JiachengDong2026/Vapor_Radar_App_V2/Docs/【任务书】三成员任务书_V1.3/00_任务分配总览与集成边界_V1.3.md

# 机载三维水汽激光雷达 FPGA 下位机——三成员任务分配总览与集成边界

> 版本：V1.3（2026-09-13，取代 V1.2/V1.1/V1.0 的任务责任分配）  
> 开发环境：Xilinx Vivado  
> RTL：Verilog-2001  
> FPGA：Xilinx XCKU11P-2FFVA1156I  
> 技术架构基线：`FPGA下位机Verilog开发指南_V1.1.md` + `FPGA下位机详细架构与接口分配方案_V1.1.md`  
> 说明：上述技术文档中的接口、寄存器、协议和物理连接仍有效；**本 V1.3 保持责任分工不变，并重新冻结多源数据通路、FIFO、DILA 分片和仲裁接口**。若责任归属与旧文档冲突，以 V1.3 为准。

---

# 1. V1.3 最终任务分配

| 责任主体 | 正式负责内容 | 形成的完整功能链 |
|---|---|---|
| **成员1** | AD4630、ADC3660、两路 ADC capture/FIFO/CDC、DILA0/DILA1 及 DILA 子模块 | **探测器 → ADC → FPGA采集 → DILA 1f/2f 解调 → DILA标准数据流** |
| **成员2** | WMS0/WMS1、正弦/锯齿发生、AD5791-0、AD5791-1、WMS→DAC 端到端链路 | **参数配置 → WMS锯齿+正弦 → DAC码 → AD5791 → 激光驱动器** |
| **成员3** | 公共 UART；PTB210、HMP、EPSILON2、BMP390、SHT45、TFA1500-L、RD105；Modbus RTU、RS485控制、I²C | **全部非ADC传感器的物理接口/串口/I²C → 协议解析 → 标准传感器数据流** |
| **项目负责人** | 时钟复位、统一时间基准/同步、RAW周期切帧、项目级 sensor_hub、stream arbiter、packetizer、命令/寄存器 crossbar、stepper、USB3.1/FX3、顶层/XDC整合、上下位机联调 | **项目公共控制、传输和最终集成** |

## 1.1 三条成员链路的设计原则

### 成员1：接收与解调链
成员1对“从 ADC 物理引脚开始，到 DILA 标准输出结束”的数据正确性负责。两种 ADC 的物理接口虽然不同，但进入系统后必须统一为 `sample_stream`。DILA0/DILA1 使用同一套可参数化 RTL，分别服务原位和遥测通道；每个 WMS 周期的曲线按 fragment 输出到独立 `bulk_stream`。

### 成员2：激励与输出链
成员2只负责 WMS + DAC，不再承担任何传感器协议。WMS 必须输出供系统使用的 `scan_start/cycle_id/sine_phase`，同时生成 DAC 样点并通过 AD5791 物理接口输出。

### 成员3：全部低速/串行传感器链
成员3统一负责公共 UART 和全部非 ADC 传感器，避免多个成员各自实现串口或协议栈。成员3需要把 RS232、RS422、RS485、TTL UART、I²C 等设备差异全部封装在驱动内部，上层只看到各设备独立的标准 `msg_stream` 和寄存器接口；每个 source 先进入独立 FIFO，再由负责人实现的 `sensor_hub` 进行消息级仲裁。

---

# 2. 项目负责人保留模块

以下模块仍由项目负责人开发或最终整合：

- `clk_rst_mgr`
- `time_sync_core`
- `timestamp_capture`
- `adc_cycle_framer`（RAW ADC 周期切帧）
- 项目级 `sensor_hub`（只做多传感器消息仲裁/状态汇总，不解析设备协议）
- `stepper_ctrl`
- 项目级 `stream_fifo`/深缓存策略
- `stream_arbiter`
- `data_packetizer`
- `cmd_decoder`
- `reg_ctrl_crossbar`
- `status_manager`
- `watchdog`
- `usb_fx3_gpif_if`
- `vapor_lidar_top`
- 最终 `vapor_lidar_top.xdc`
- FX3 firmware
- USB endpoint/VLP1 协议落地
- Qt 上位机对接与最终系统联调

**V1.3 中，公共 UART 和 DILA 仍由成员负责；新增的系统级多源仲裁、RAW bulk framer 仍由项目负责人负责。**

---

# 3. 模块所有权冻结表

| 模块 | 所有人 | 上游 | 下游 |
|---|---|---|---|
| `adc_ad4630_if` | 成员1 | AD4630 pins | ADC0 `sample_stream` |
| `adc_adc3660_if` | 成员1 | ADC3660 pins | ADC1 `sample_stream` |
| `dila_core` | 成员1 | `sample_stream` + WMS phase/cycle | DILA curve points |
| `dila_ref_gen` | 成员1 | WMS phase 或独立频率 | 1f/2f sin/cos |
| `dila_mixer` | 成员1 | ADC sample + refs | I/Q products |
| `dila_lpf` | 成员1 | mixed I/Q | filtered I/Q |
| `dila_decimator` | 成员1 | filtered I/Q | decimated points |
| `dila_block_framer` | 成员1 | DILA points + cycle metadata | `DILA_BLOCK` V2 `bulk_stream` fragments |
| `wms_wavegen` | 成员2 | cfg/time | DAC sample + scan/cycle/phase |
| `sine_lut`（WMS侧） | 成员2 | phase | WMS sine |
| `dac_ad5791_if` | 成员2 | WMS DAC sample | AD5791 pins |
| `uart_rx` | 成员3 | serial RX pin | byte stream |
| `uart_tx` | 成员3 | byte stream | serial TX pin |
| `crc16_modbus` | 成员3 | bytes | CRC |
| `modbus_rtu_master` | 成员3 | UART byte stream | device transactions |
| `rs485_halfduplex_ctrl` | 成员3 | UART TX state | DE/RE |
| `i2c_master` | 成员3 | device drivers | SCL/SDA |
| `ptb210_rs232` | 成员3 | UART | `msg_stream` |
| `hmp_modbus_rs485` | 成员3 | UART/Modbus/RS485 | `msg_stream` |
| `epsilon_rs422` | 成员3 | UART + FDILink | `msg_stream` + GNSS time tag |
| `bmp390_driver` | 成员3 | I²C | `msg_stream` |
| `sht45_driver` | 成员3 | I²C | `msg_stream` |
| `tfa1500_uart` | 成员3 | UART/GPIO RX | `msg_stream` |
| `rd105_uart` | 成员3 | UART/Modbus | `msg_stream` |

---

# 4. 成员之间必须冻结的接口

## 4.1 成员2 → 成员1/项目负责人：WMS参考接口

每个 WMS 通道必须提供：

```verilog
output wire        scan_start;       // 一个 sys_clk 周期脉冲，新锯齿周期开始
output wire [31:0] cycle_id;         // scan_start 时已经更新为新周期 ID
output wire [31:0] sine_phase;       // 当前 1f 相位，U32: 0..2^32-1 = 0..2pi
output wire        wms_running;
output wire        phase_valid;
```

冻结要求：

1. `scan_start`、`cycle_id`、`sine_phase` 位于 `sys_clk=100 MHz` 控制/参考域；
2. `scan_start` 仅 1 cycle；
3. `cycle_id` 每次有效 scan 起始递增 1；
4. `phase_valid=1` 时 `sine_phase` 可供 DILA 锁相；
5. WMS/DAC 内部 SPI 实现不能泄漏到成员1；
6. 成员1不得读取成员2内部寄存器来“猜”相位。

项目负责人同时消费 `scan_start/cycle_id` 用于 RAW ADC 周期切帧和周期级 timestamp。

## 4.2 成员1 → 项目负责人：ADC RAW 与 DILA 输出

每个 ADC 继续暴露标准 RAW `sample_stream`，供项目负责人 `adc_cycle_framer` 和 DILA 使用：

```verilog
output wire        raw_valid;
input  wire        raw_ready;
output wire [31:0] raw_data;
output wire [7:0]  raw_flags;
```

DILA0/DILA1 从 V1.3 起不再输出低速 `msg_stream`，而输出各自独立的 `bulk_stream`：

```verilog
output wire        b_valid;
input  wire        b_ready;
output wire [31:0] b_data;
output wire [3:0]  b_keep;
output wire        b_sof;
output wire        b_last;
output wire [15:0] b_source_id;
output wire [15:0] b_msg_id;
output wire [63:0] b_timestamp;
output wire [31:0] b_cycle_id;
output wire [31:0] b_flags;
```

冻结要求：

- `DILA0 source=0x0030`, `DILA1 source=0x0031`, `msg_id=0x1001`；
- 每个 WMS 周期可以产生多个 fragment；
- 默认最多 256 点/fragment；单 fragment payload <=8192 B；
- 每通道独立 bulk FIFO / ping-pong buffer，至少能缓存 2 个最大 fragment；
- 同一周期所有 fragment 的 timestamp/cycle_id 相同；
- 项目负责人只在 fragment 的 `b_last` 后切换 source。

成员1必须保证物理 ADC 不受下游 `ready` 直接反压。

## 4.3 成员3 → 项目负责人：传感器统一消息接口

每个 sensor driver 最终输出**独立**标准 `msg_stream`，并在 driver 输出侧配置独立消息 FIFO。项目负责人不需要知道 PTB ASCII、FDILink、Modbus、TFA binary frame 或 SHT CRC 等细节。

冻结要求：

- PTB/HMP/EPSILON2/BMP390/SHT45/TFA/RD105 不得直接并联一套 `msg_stream`；
- 每个 source 默认建议 FIFO 有效容量 >=1 KiB，至少能容纳一条最大合法记录；
- FIFO full 必须计数并置错误；
- 项目负责人实现 `sensor_hub`，按 message-locked round-robin 在各 source FIFO 之间仲裁；
- 成员3不实现项目级 `sensor_hub/stream_arbiter`。

成员3的 UART、Modbus、I²C 可以在成员内部复用。

---

# 5. 冻结寄存器地址/数据源归属

| 功能 | Base | 负责人 |
|---|---:|---|
| WMS0 | `0x2000` | 成员2 |
| WMS1 | `0x2100` | 成员2 |
| DAC0 AD5791 | `0x3000` | 成员2 |
| DAC1 AD5791 | `0x3100` | 成员2 |
| ADC0 AD4630 | `0x4000` | 成员1 |
| ADC1 ADC3660 | `0x4100` | 成员1 |
| DILA0 | `0x5000` | 成员1 |
| DILA1 | `0x5100` | 成员1 |
| PTB210 | `0x6000` | 成员3 |
| HMP | `0x6100` | 成员3 |
| EPSILON2 | `0x6200` | 成员3 |
| BMP390 | `0x6300` | 成员3 |
| SHT45 | `0x6400` | 成员3 |
| TFA1500-L | `0x6500` | 成员3 |
| RD105 | `0x6600` | 成员3 |

成员不得修改 base address、source_id、msg_id。若需要新增模块专用寄存器，只能在自己的 `0x100 B` 地址页内从未占用 offset 扩展，并在 README 中明确说明。

---

# 6. 项目级统一接口要求

> V1.3：`sample_stream`=ADC样点；`msg_stream`=低速消息；`bulk_stream`=DILA/RAW大块分片。禁止混用。

## 6.1 时钟/复位

```verilog
input wire sys_clk;       // 100 MHz
input wire rst_sys_n;     // 低有效，同步释放
```

器件源同步时钟（ADC DCLK/FCLK 等）可在接口模块内部使用，但进入统一数据平面前必须完成 CDC。

## 6.2 `cfg_bus`

正式可配置模块统一实现：

```verilog
input  wire        cfg_valid;
input  wire        cfg_write;
input  wire [31:0] cfg_addr;
input  wire [31:0] cfg_wdata;
input  wire [3:0]  cfg_wstrb;
output wire        cfg_ready;
output wire [31:0] cfg_rdata;
output wire        cfg_error;
```

规则：

- `cfg_valid && cfg_ready` 完成一次访问；
- `cfg_error` 与 `cfg_ready` 同拍；
- 单 outstanding；
- 只响应自身地址页；
- 非法参数返回 `cfg_error`；
- 实时参数优先使用 shadow + commit；
- WMS/DILA 等实时处理参数在安全边界生效。

## 6.3 统一寄存器页首部

每个 `0x100 B` 页：

| offset | 名称 | 访问 | 含义 |
|---:|---|---|---|
| `+0x00` | `ID_VERSION` | RO | module ID/version |
| `+0x04` | `CONTROL` | RW/W1P | enable/reset/commit/clear FIFO |
| `+0x08` | `STATUS` | RO | ready/busy/online/overflow/error/time sync |
| `+0x0C` | `ERROR` | RO/W1C | timeout/protocol/overflow/config/internal/device/data format |

---

# 7. 物理资源责任汇总

## 7.1 成员1

- AD4630：CON15/对应 ADC 接口网络及原理图中全部 AD4630 FPGA pins；
- ADC3660：CON17/对应 ADC3660 source-synchronous FPGA pins；
- ADC SPI/控制 pins（若该器件需要）；
- DILA 无新增板外引脚，使用内部数字数据。

## 7.2 成员2

- AD5791-0 → CON7 SMA；
- AD5791-1 → CON8 SMA；
- 两路 AD5791 的 SCLK/SYNCN/SDIN/SDO/RSTN/CLRN/LDACN FPGA pins。

## 7.3 成员3

- PTB210 → CON25 RS232A；
- HMP → CON19 RS485；
- EPSILON2 → CON24 RS422，SYNC 信号 CON22 交由项目负责人 `time_sync_core`；
- BMP390/SHT45 → CON11 I²C；
- TFA1500-L → CON21 TTL UART + CON11 LF RX；
- RD105 → CON11 GPIO UART。

最终 ball/pin 号以各自任务书与主开发指南的接口汇总表为准。

---

# 8. 禁止跨责任边界修改

成员不得：

1. 修改 VLP1/USB 协议；
2. 修改 source_id/msg_id/base address；
3. 修改项目顶层；
4. 修改最终总 XDC；
5. 新建第二套 timestamp；
6. 直接向 FX3/USB 写数据；
7. 在设备 driver 外暴露设备私有协议；
8. 通过全局变量/层次引用读取其他成员内部信号；
9. 修改其他成员冻结接口；
10. 未经负责人确认新增 IP 依赖或第三方 RTL。

---

# 9. 每名成员最终统一交付目录

```text
memberX_<scope>/
├── README.md
├── rtl/
│   └── *.v
├── sim/
│   ├── tb/
│   ├── models/
│   ├── vectors/
│   └── stubs/           # 仅仿真，禁止综合
├── constraints/
│   └── memberX_<scope>.xdc
├── scripts/
│   ├── run_sim.tcl
│   └── run_synth_check.tcl
├── reports/
│   ├── SIM_REPORT.md
│   ├── SYNTH_REPORT.md
│   └── TIMING_CDC_NOTES.md
└── docs/
    ├── INTERFACE.md
    ├── REGISTER_MAP.md
    ├── HARDWARE_MAPPING.md
    └── KNOWN_ISSUES.md
```

## README 最低内容

- Vivado 版本；
- 顶层待实例化模块名；
- RTL 文件清单；
- 编译顺序；
- 所需 clock/reset；
- 参数默认值；
- 外部依赖；
- 通过的 testbench；
- 综合/时序状态；
- 尚需实机确认项。

---

# 10. 统一验收门槛

每名成员交付前必须满足：

1. 所有 testbench PASS；
2. RTL 无 latch；
3. 综合无 Error/Critical Warning；
4. CDC 已解释或约束；
5. I/O 时钟有正确时序约束；
6. `cfg_bus` 非本地址不响应；
7. valid/ready 背压测试通过；
8. FIFO overflow/timeout/CRC 等异常均可观测；
9. XDC 只提交自己的 fragment；
10. 不提交 `.runs/`、`.cache/`、巨大 waveform 等临时文件；
11. 项目负责人将成员 RTL 加入顶层时，不应需要修改成员内部代码才能完成基本实例化。

---

# 11. 推荐并行开发顺序

### 成员1
ADC物理接口 → capture FIFO/CDC → ADC标准流 → DILA数学链 → DILA block → 双通道端到端测试。

### 成员2
WMS phase/波形 → AD5791 transport → 单通道 WMS→DAC → 双通道独立运行 → 导出冻结 WMS参考接口。

### 成员3
UART → Modbus/RS485/I²C → PTB/HMP/RD105 → EPSILON/TFA → BMP/SHT → 全传感器 `msg_stream` 回归。

三名成员均应在其他成员未完成时使用**同端口仿真 stub/model**，不得以依赖未完成为理由串行等待。
