JiachengDong2026/Vapor_Radar_App_V2/Docs/INTEGRATION_REVISION_20261002_DLIA_PRECISION.md

# 2026-10-02 DLIA参考与低通精度修订

本说明对应隔离候选源码 `E:/Documents/Vapor_Lc_App_Test/dlia_precision_20261002/source`。2026-10-04已将该版本同步至正式 `E:/Documents/Vapor_Lc_App_v2`；同步范围及复验见 [正式同步记录](MERGE_MANIFEST_20261004.md)。历史BIT的版本、哈希和板测记录保留原值。本隔离版本现已完成算法回归、实现时序检查、比特流下载和两轮真实激光器上板采集；验收范围为 CON7/WMS1 对应的第一路 ADC/DLIA，详见本任务目录的 [完整报告](E:/Documents/Vapor_Lc_App_Test/dlia_precision_20261002/REPORT.md)。其余通道不据此宣称完成实板验收。

## 原因与版本识别

解调输入含较大的直流偏置时，混频产生的20kHz/40kHz分量必须在抽取前充分抑制。原二阶1kHz低通的带外残留可能在抽取后影响H2；参考LUT直接截断地址也会引入参考波形量化误差。本修订分别改善参考精度与混频后滤波。

| 读回项 | 历史构建 | 本隔离候选 |
| --- | --- | --- |
| DLIA0 `0x5000` | `0x00300100` | `0x00300101` |
| DLIA1 `0x5100` | `0x00310100` | `0x00310101` |
| 模块版本低16位 | `0x0100` | `0x0101` |
| 1MHz `LPF_PROFILE` | `0x00020101`，二阶 | `0x00040101`，四阶 |
| 12.5MHz `LPF_PROFILE` | `0x00020102`，二阶 | `0x00040102`，四阶 |
| 数值描述 `+0x28` | `0x20112E10` | `0x20112E10` |

双AD4630顶层的两路均选择1MHz profile；12.5MHz profile继续用于编译参数与旧高速ADC回归兼容。profile由`INPUT_RATE_HZ`在编译时决定，不随运行时采样率寄存器自动重新设计。偏离设计采样率时，实际截止频率随采样率同比例变化。

寄存器地址、读写属性、既有位域、source/msg ID、流位宽、VLP 1.0以及`DILA_BLOCK` schema2均保持原定义。上位机须按读回版本选择算法说明，不应将旧BIT的profile读回当作新算法通过。

## 参考发生器

`dila_ref_gen.v`保留1024点有符号18位Q1.17正弦LUT，峰值为131071。`phase[31:22]`定位表项，`phase[21:10]`提供12位线性插值小数；下一表项在1023→0处回绕。插值乘积除以4096时采用最近舍入、恰好半LSB时远离零；最终10位phase不参与插值。组合端口及流水级数不变。

相位公式继续采用U32整圈并自然回绕：

- `p1 = phase + PHASE_1F`；
- `p2 = 2*phase + PHASE_2F_CORRECTION`；
- cos参考在对应sin相位上加`0x40000000`。

H2校正不自动包含两倍的1f相位偏置。本修订不新增H2校正角，也不改变I/Q符号、幅值计算或输出比例。混频低通后的I/Q仍没有额外乘2补偿。

## 四阶低通与定点格式

`dila_core.v`将两个已有`dila_lpf`串联，对I1/Q1/I2/Q2四个分量分别处理。结构为四阶Butterworth，设计截止频率1kHz；低Q节在前，高Q节在后。每节都具有单位DC增益，避免把极小前级增益与极大后级增益带入定点实现。

每节采用递推式 `y[n]=b0*x[n]+b1*x[n-1]+b2*x[n-2]-a1*y[n-1]-a2*y[n-2]`。系数均为48位有符号Q2.46，下表为乘以`2^46`后的整数；`a0=2^46`。

| 输入率 | 节 | b0=b2 | b1 | a1 | a2 |
| --- | --- | ---: | ---: | ---: | ---: |
| 1MHz | 1，低Q | 690501114 | 1381002230 | -139922478782895 | 69556496609689 |
| 1MHz | 2，高Q | 692843472 | 1385686942 | -140397131718583 | 70031158914805 |
| 12.5MHz | 1，低Q | 4442812 | 8885622 | -140672143489574 | 70303417083156 |
| 12.5MHz | 2，高Q | 4444020 | 8888039 | -140710403851039 | 70341677449454 |

每行严格满足 `b0+b1+b2=2^46+a1+a2`，包括系数量化后的DC增益。输入和节间IQ为32位有符号数；每节历史状态为48位有符号、16位小数。乘积96位，求和100位，舍入临时量101位；系数缩放和最终输出均采用最近舍入、半LSB远离零。状态限幅到48位，输出限幅到32位，避免溢出回绕。

`+0x34`累计两节的饱和脉冲；任一节同一输入的多个IQ通道同时饱和仍计为该节一个事件，两节同周期同时饱和加2，并置滤波饱和错误位。正常信号验证未触发饱和；有意施加的正负满幅阶跃用于验证限幅和计数。

MODE.bit2同时旁路两节输出。两节共用本地复位/FIFO clear；完整194位采样标签随数据流转。待提交配置和STOP/drain判断同时包含两节busy/valid，避免第一节仍在处理时误认流水为空。连续周期边界保持IIR状态；清空和软件复位按原语义清除算术历史。

## 时序与频率响应变化

第二节增加3个100MHz系统时钟，即30ns的运算流水延迟。两节并行处理相邻样点，各自每3clk可接收一个输入；既有core最短6clk接收间隔不变。仿真验证12.5MHz场景每8clk输入一次没有漏样或额外背压。抽取位置仍在两节低通之后，1MHz→10kHz仍抽取100，12.5MHz→10kHz仍抽取1250。

运算流水延迟与滤波群延迟不同。四阶响应在低基带频率附近的群延迟约0.416ms，原二阶约0.225ms，增加约0.191ms；具体群延迟随包络频率变化，不能用固定30ns代表全部响应变化。因此扫描包络和瞬态的响应会延后、启动稳定需要时间。H2参考相位定义保持原样，但随时间变化的H2包络会受到新的滤波相位响应；不能据此宣称所有频率上的输出相位数值不变。

标签仍标识原采样时刻，未增加软件时间戳补偿。对比RAW与DLIA扫描曲线时应考虑滤波群延迟，不能把新旧曲线逐点错位直接当作幅值错误。

| 数值频响 | 1MHz设计 | 12.5MHz设计 |
| --- | ---: | ---: |
| 1kHz增益 | -3.0103dB | -3.0103dB |
| 20kHz抑制 | 104.128dB | 104.083dB |
| 40kHz抑制 | 128.348dB | 128.166dB |

以上为双精度Butterworth设计响应；定点、LUT与输出量化另由逐位模型验证，不能将理论带外抑制直接当作整板噪声指标。

## 已完成验证及交付边界

Vivado/XSim 2020.2运行`tb_dila_filter_precision.v`，实际`dila_core`通过1MHz的18,000个输入与12.5MHz的225,000个输入逐位比较，共243,000个。覆盖两节完整标签、8clk持续吞吐、正负满幅限幅及计数、旁路±满幅/±1LSB、软件复位清历史、在途FIFO clear，以及新版ID/profile。最终日志标记`DILA_FILTER_PRECISION_PASS`，满幅用例累计两节饱和事件分别为13和50。

独立Python整数模型还与SciPy双精度SOS比较。已知合成输入为4V DC、0.5V峰值20kHz一次谐波和0.05V峰值40kHz二次谐波，换算比例131072 LSB/V，运行10ms并对最后2ms统计。为与输入峰值比较，验证计算采用`2*sqrt(I2^2+Q2^2)`，这不是对硬件接口新增乘2。

| 指标 | 1MHz | 12.5MHz |
| --- | ---: | ---: |
| H2峰值相对理想值最大误差 | 0.03069% | 0.06049% |
| 定点IQ相对双精度最大误差 | 0.594 LSB | 2.789 LSB |

复现脚本、向量、日志及详细报告在外部 `E:/Documents/Vapor_Lc_App_Test/dlia_precision_20261002/filter_validation/`，入口`run_filter_validation.ps1`，结果`REPORT.md`与`numeric_summary.json`。参考发生器独立回归、已有系统回归、真实RAW回放、实现时序/资源和上板测试由本次总任务另行汇总，不能用这里的合成信号结果代替实板结论。

## 版本记录

- 历史模块0100：1024点参考LUT直接寻址，二阶1kHz低通，profile00020101/00020102；既有2026-09-28/2026-10-01构建记录保留。
- 2026-10-02隔离候选模块0101：参考增加12位线性插值，低通改为各节单位DC增益的四阶结构，profile00040101/00040102；同步更新协议入口、寄存器附录、开发指南与任务规范引用。寄存器布局、数据格式和硬件管脚不变。
