JiachengDong2026/Vapor_Radar_App_V2/Docs/【资料】电路板资料/项目开发需求表单—国科大杭高院260420.xlsx

为了更高效地推进项目合作，精准把握产品细节和开发功能需求，烦请您仔细填写以下功能需求表。这份表格是项目开发的关键指引，将贯穿产品设计、研发、测试等各个环节，我们依据此了解产品功能全貌，确保开发方向与您的期望严丝合缝。请您从功能特性、性能指标、优先级等维度详尽描述需求，若有相关示例或参考设计，可一并附上，以便我们深入理解。再次感谢您的积极配合！
项目开发需求表
公司名称 | 国科大杭州高等研究院
服务类型 | ☑ PCB硬件 □ PCB硬件+固件 □ ID,MD外壳设计&3D打印手板（配套可选） □ 其他开发（配套可选）备注：XXXXXXX
项目名称 | 激光雷达水汽检测
项目情况 | 系统总体安装于无人机平台。信号发生器输出用于光谱扫描的低频扫频信号，并叠加高频调制信号以驱动激光器工作。激光经发射光路射向目标区域，在传播过程中受到水汽吸收后，目标区域的部分反射回波由接收光学系统收集并聚焦至光电探测器。光电探测器输出的模拟电压信号经模数转换器（ADC）采集后转换为数字信号，并送入FPGA进行高速数据接收与预处理。 与此同时，机载多类环境与状态传感器同步接入FPGA，包括通过1个RS232接口连接的气压传感器、通过1个3.3V的TTL接口连接的高度传感器、通过1个RS485接口连接的温湿度传感器以及通过1个RS422接口连接的组合导航模块，FPGA统一完成各类传感器数据与光电探测原始数据的时序汇聚、同步管理及部分前端处理，并通过PCIe高速接口将光电探测原始数据、FPGA预处理结果以及各辅助传感器数据传输至机载工控机。工控机把数据存到本地硬盘，用于实现大容量数据存储。工控机运行上位机软件，完成信号解调、特征提取、浓度反演、数据存储及检测报告生成等功能；同时，借助工控机现有无线传输链路，将相关数据实时或准实时回传至地面端。
功能需求（总体要求） | 目前我方已确定采用的FPGA芯片是XCKU11P-2FFVA1156I,放弃原有的核心板方案，不用核心板了，设计一个pcb板，以实现模拟信号采集、模拟信号输出、外部传感器接入、同步控制以及与上位机高速通信等功能。工作温度范围应达到：-40°C ～ +50°C。系统总数据吞吐能力要求满足 最大 5.2 Gbps 的传输需求。 板子总体应包含以下接口与功能模块： 2个ADC模块； 3个DAC模块； 1路RS485接口； 1路RS422接口； 2路RS232接口； 9个SMA口（其中8个给了AD,DA使用，剩下的一个给sync_out触发信号） 1个PCIE3×8金手指 1路FMC HPC接口；（不要和下面的banK88,89）重复 DDR4-2666 64bit； 1个千兆网口； 1个USB3.1 FPGA Bank电压可配置和bank引脚要求 底板需支持通过 跳线帽或等效硬件配置方式，对FPGA芯片的Bank89的工作电压进行切换设置，使其能够在 2.5 V 与 3.3 V 两种电压等级之间灵活切换，以适应不同外设接口的电平匹配需求。bank88引出来24个引脚，bank89引出来16个引脚，一共是40个引脚，用20*2p的排针引出，bank89的引脚已经引出来16个引脚给到了那个40Pin排针，现在bank89还剩8个引脚没引出，然后再将bank89剩下的8个引脚用一个8*1p的排针引出来,banK88电压是3.3V。 接口统计： 9个SMA口（其中8个连接4个AD/DA芯片，另一个SMA口输入sync_out触发信号（频率最高100Hz，这个触发信号最高是5V电平，打算将触发信号输入到一个SMA口后直接连接FPGA的IO口，这个IO口对应的BANK电压3.3V就行，触发信号5V电压太高了会损坏IO口，需要降压处理，可以采用电阻分压降压降到3.3V。）； 1个40pin I/O（这个40pin的组成为bank88提供24个，bank89提供16个，然后要求bank89电压可调）； 1个8Pin I/O（由bank89剩下的8个引脚提供） 1个RS422输入；2个RS232输入；1个485输入，1个UART TTL_3.3V输入 1个FMC HPC； 1个PCIE3×8金手指;1个USB3.1 1个千兆网口
功能需求（核心功能） | 一、需要两套AD/DA模块，一套低速一套高速。DA均需要电压输出，AD均为单端电压输入。其中： 低速AD/DA（信号最高频率50kHz）： DAC 1： AD5791BRUZ（20bit，1Msps，单通道，电压输出） 输出电压范围：±2.5V，±5V，±10V 一共三个范围可调节（电压输出）；输入接口形式：2个SMA。 （2个这个芯片） ADC 1： AD4630-24BBCZ（24bit，2Msps，双通道，差分输入） 前端要设置单端转差分；输入电压范围：0-5V，0-10V，0- -10V，一共三个范围可调节（我们的输入信号是单端输入）；输入接口形式：2个SMA。（1个这个芯片）；此外，增加50欧和1M欧的不同输入阻抗调节 高速AD/DA（信号最高频率1MHz）： DAC 2： AD3552RBCPZ16-RL7（16bit，33Msps，双通道，电流输出） 后端要求转换，将输出的电流信号转为电压信号;输出电压范围：±2.5V，±5V，±10V 一共三个范围可调节（电压输出）;输出接口形式：2个SMA。（1个这个芯片） ADC 2： ADC3660IRSBT（16bit，30Msps，双通道，差分输入） 前端要设置单端转差分;输入电压范围：0-5V，0-10V，0- -10V，一共三个范围可调节（我们的输入信号是单端输入）;输入接口形式：2个SMA。（1个这个芯片）；此外，增加50欧和1M欧的不同输入阻抗调节 二、通过该电路板实现对多个串口设备的数据接收和转发。其中，串口设备包括： 1. 激光测距模块接口。要求：采用 UART TTL_3.3V 电平；接口形式为4pin接线端子座（TX,RX用两个pin，地用一个pin,使能再用一个pin）；4pin端子座型号:DG301-5.0-04P-14-1000A(H) 2. 温湿度传感器接口。要求：提供 1 路RS-485接口，接口形式为5pin接线端子座；需加485转换芯片；5pin端子座型号：DB128V-5.0-5P-GN-S 3. 压强计接口。要求：提供 1 路 RS232C 接口，接口形式为9pin接线端子座；需加232转换芯片； 9pin端子座型号：DB128V-5.0-9P-GN-S 4. 组合导航接口。要求：其中一个RS232串口通信，波特率（921600bps），接口形式为5pin接线端子座；需加232转换芯片；然后我这个组合导航模块还会输出一个sync_out触发信号（频率最高100Hz，这个触发信号最高是5V电平，打算将触发信号输入到一个SMA口后直接连接FPGA的IO口，这个IO口对应的BANK电压3.3V就行，触发信号5V电压太高了会损坏IO口，需要降压处理，可以采用电阻分压降压降到3.3V。）
细分选项 | 3 | 产品要求级别： □ 消费级 ☑ 工业级 □ 车规级 □军工级 □ 航天级
 | 单板成本控制要求： □不敏感 ☑敏感 控制金额：99000（报销政策限制，总价不能超过10万） | 是否需要进行产品认证： ☑ 不需要 □ 需要 种类：
 | 需要PCBA样品数量： □不需要 ☑ 需要 数量：1 | 是否需要进行EMC测试及整改： ☑ 不需要 □需要 种类：
 | 量产是否需要批量供PCBA： ☑ 不需要 □ 需要 数量： | PCBA尺寸结构定义： □ 提供DXF图纸及限高信息 ☑ 无需考虑，可先行设计，后期结构配合
 | 需要3D打印手板样品数量： ☑不需要 □ 需要 数量： | 对标产品链接：
服务备注 | B，研发服务流程：需求解析——合同签订——项目60%预付——原理图设计——PCB设计——固件编写——功能调试——项目验收——结算40%尾款（服务全流程客户确认）
项目备注
