JiachengDong2026/Vapor_Radar_App_V2/Docs/【资料】电路板资料/LIDAR_WATER_VAPOR_DETECTION_SCH_0908(1).pdf

# TITLE

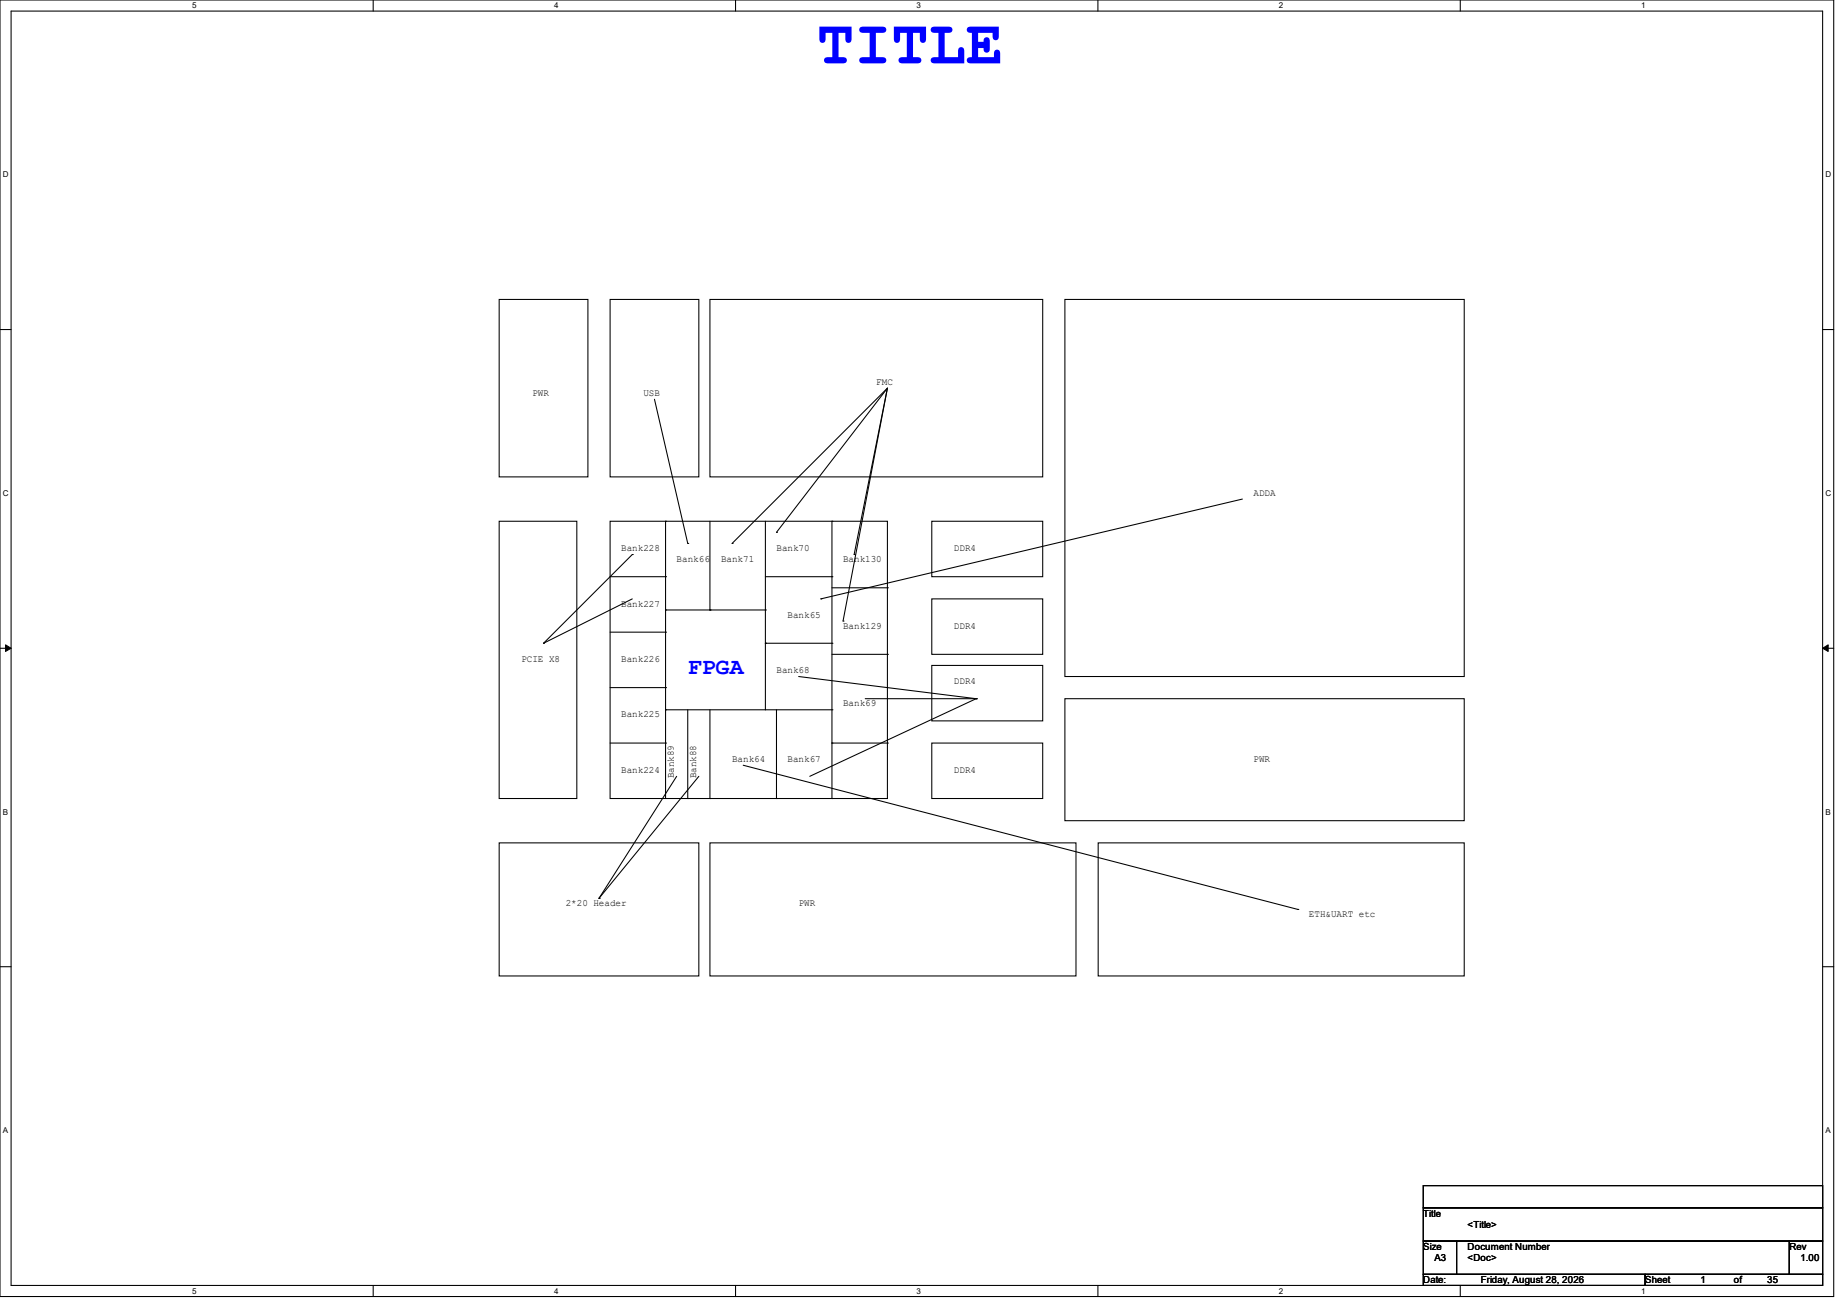
[picture p2: page 1]
Bank228; Bank224; Bank225; Bank226; Bank227; Bank129; Bank130; Bank64; Bank65; Bank66; Bank67; Bank68; Bank69; Bank70; Bank71 Bank89; Bank88; DDR4; ADDA; PCIE X8; USB; FMC; PWR; FPGA; 2*20 Header; Title Size; Document Number; Rev Date:; Sheet; of <Doc>; 1.00 <Title> A3; Friday, August 28, 2026; 35 Title Size

ETH&UART etc

# Diagram

+12V

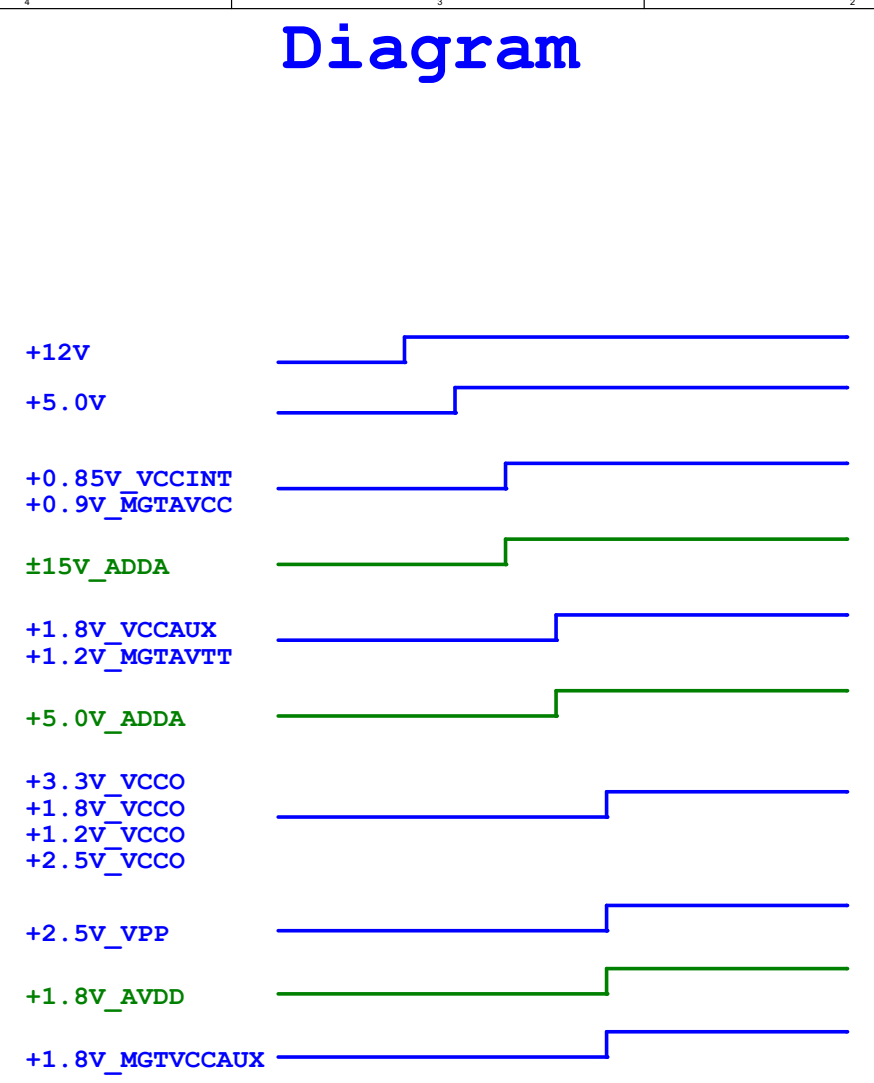
[picture p3: page 2]
+0.85V_VCCINT +0.9V_MGTAVCC; ±15V_ADDA; +3.3V_VCCO +1.8V_VCCO +1.2V_VCCO +2.5V_VCCO; +2.5V_VPP; +1.8V_VCCAUX +1.2V_MGTAVTT; +1.8V_MGTVCCAUX; +5.0V_ADDA; +1.8V_AVDD; Title Size; Document Number; Rev Date:; Sheet; of <Doc>; 1.00 <Title> A3; Friday, July 10, 2026; 35 Title Size

# FPGA_CFG

# 0402 R516 4.7K/1%_NC ⁰⁴⁰² R260

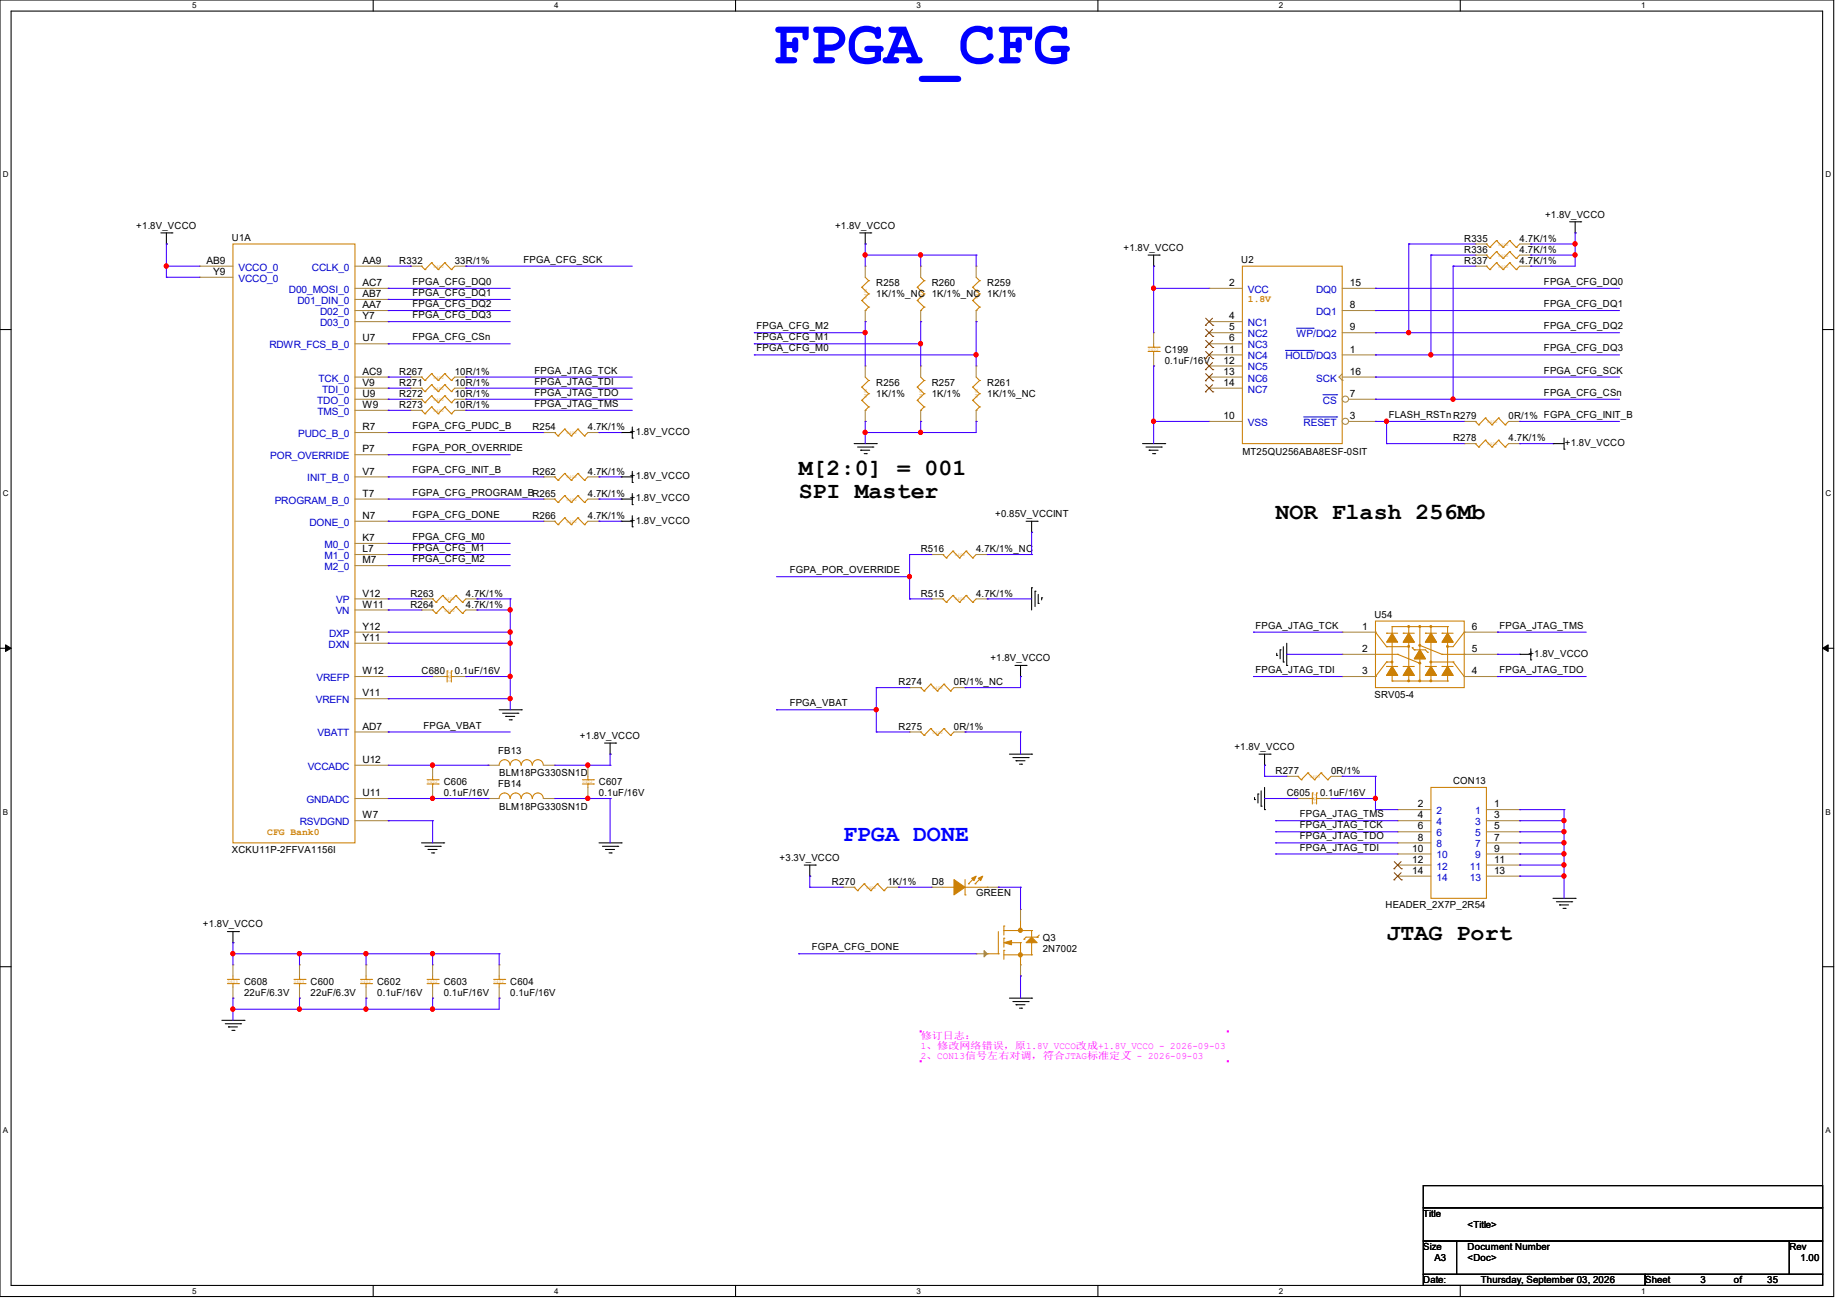
[picture p4: page 3]

1.8V U2MT25QU256ABA8ESF-0SIT HOLD/DQ3 1 RESET 3 CS 7 DQ1 8 WP/DQ2 9 DQ0 15 SCK 16 VCC 2 NC2 5 NC3 6 NC4 11 NC5 12 NC6 13 NC7 14 NC1 4 VSS 10

VBATT AD7 VCCADC U12 VREFN V11 VREFP W12

# FPGA_DDRMC

FPGA_DDR4_DQ9 FPGA_DDR4_DQSP1 FPGA_DDR4_DQSN1 FPGA_DDR4_DQSP3 FPGA_DDR4_DQSN3 FPGA_DDR4_DM3 FPGA_DDR4_DQSP2 FPGA_DDR4_DQSN2 FPGA_DDR4_DM2 FPGA_DDR4_DQSP0 FPGA_DDR4_DQSN0 FPGA_DDR4_DM0

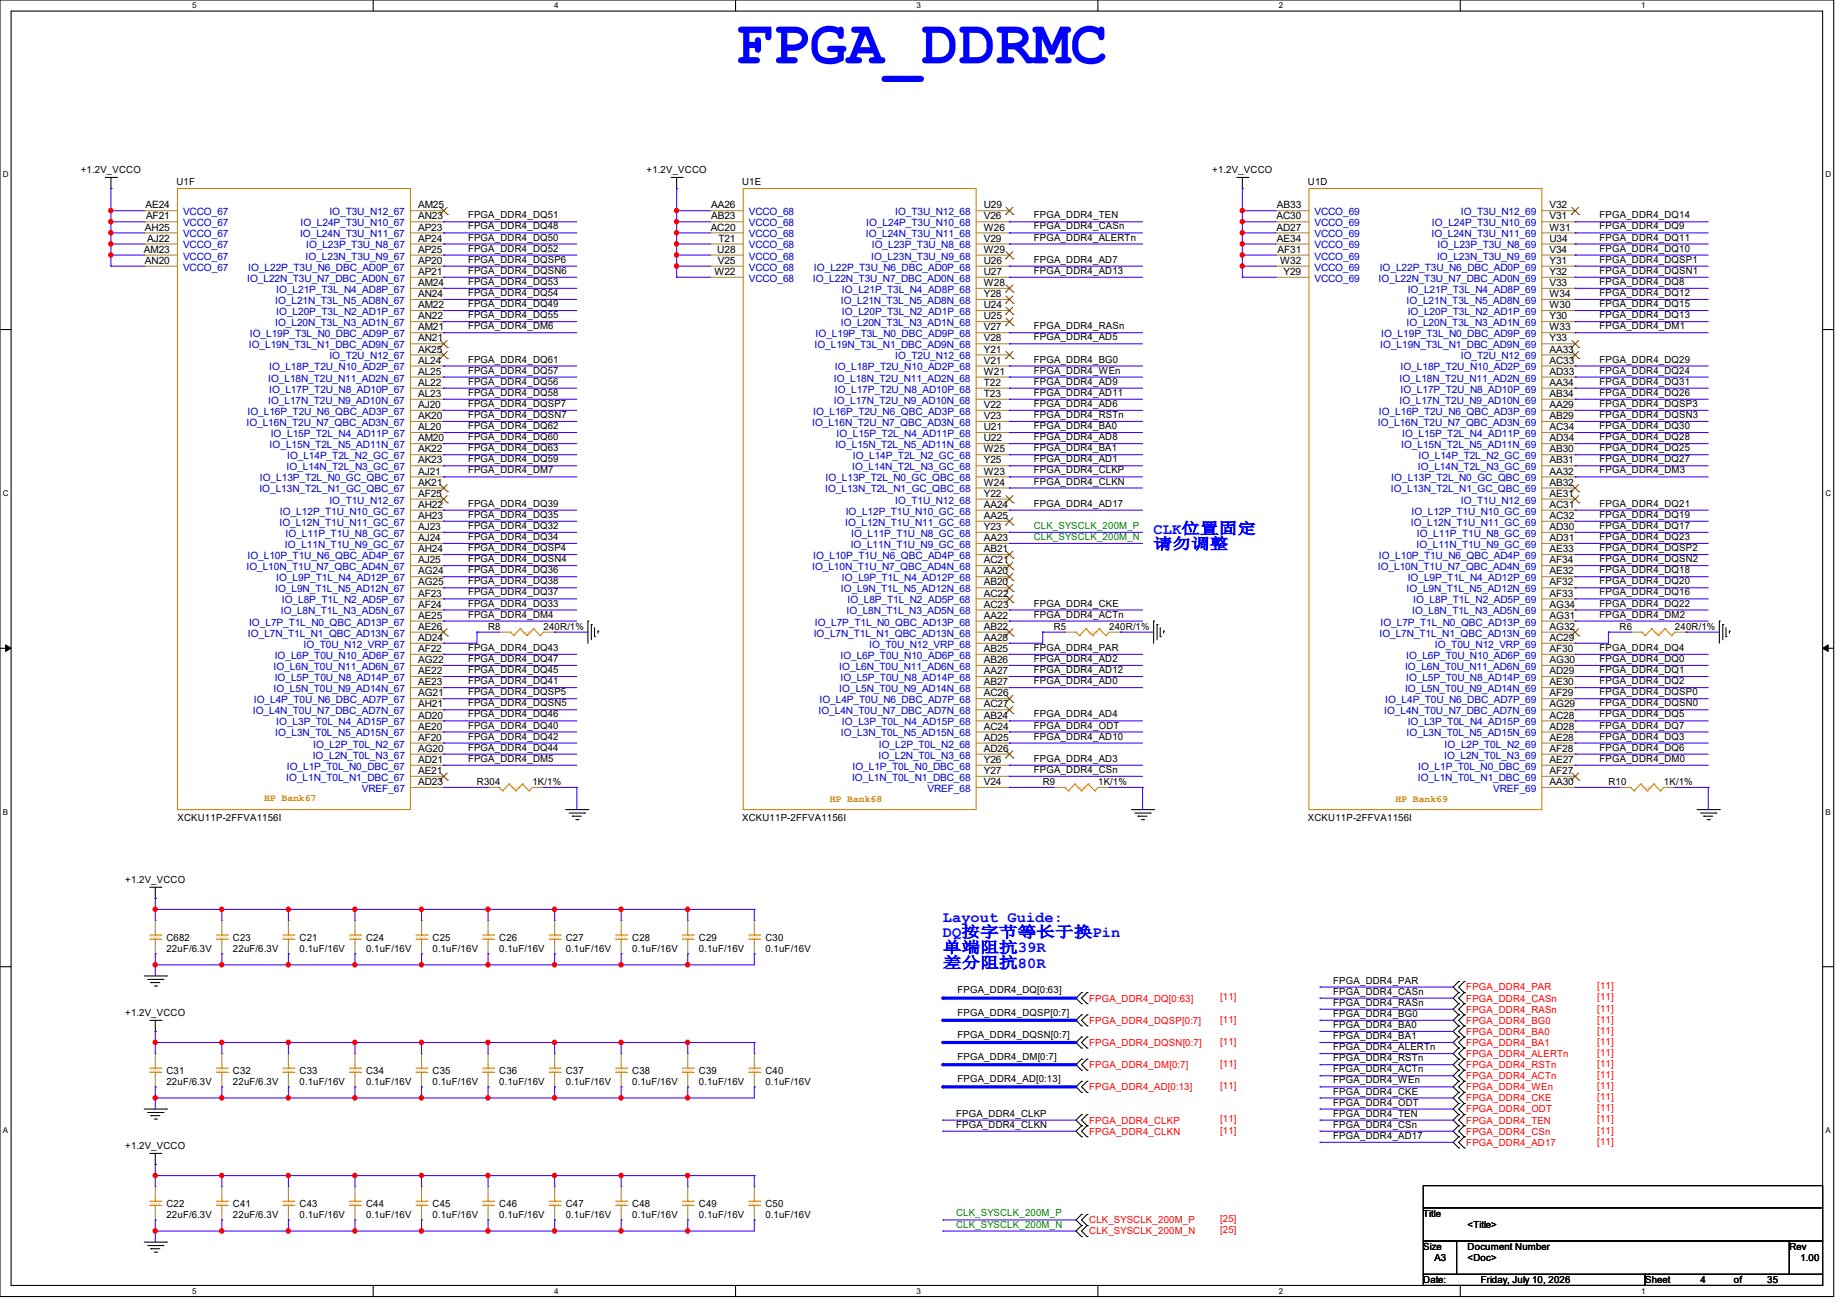
[picture p5: page 4]

# FPGA_ADDA&USB

# Low Speed DAC

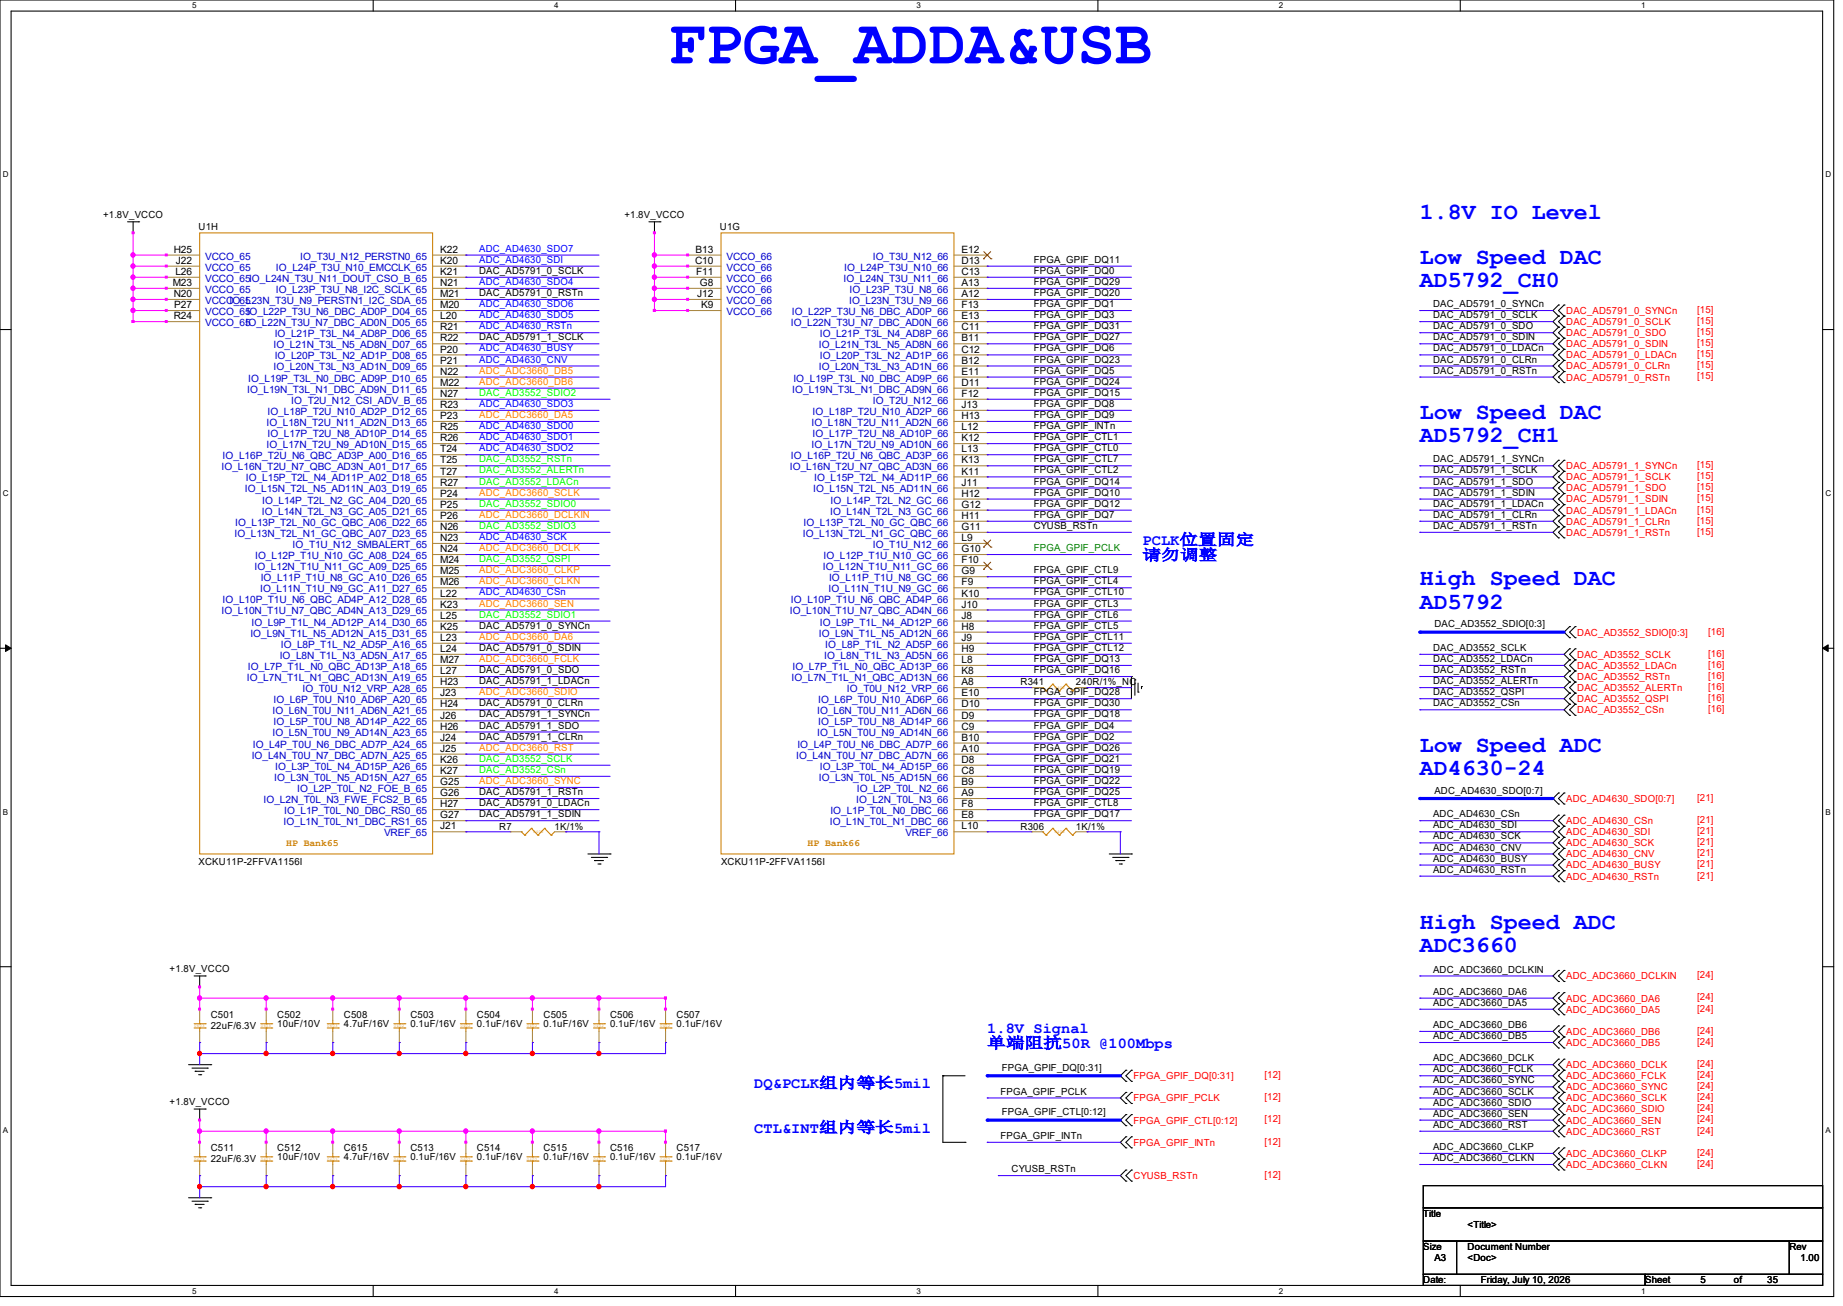
[picture p6: page 5]

# FPGA_HPIO_FMC

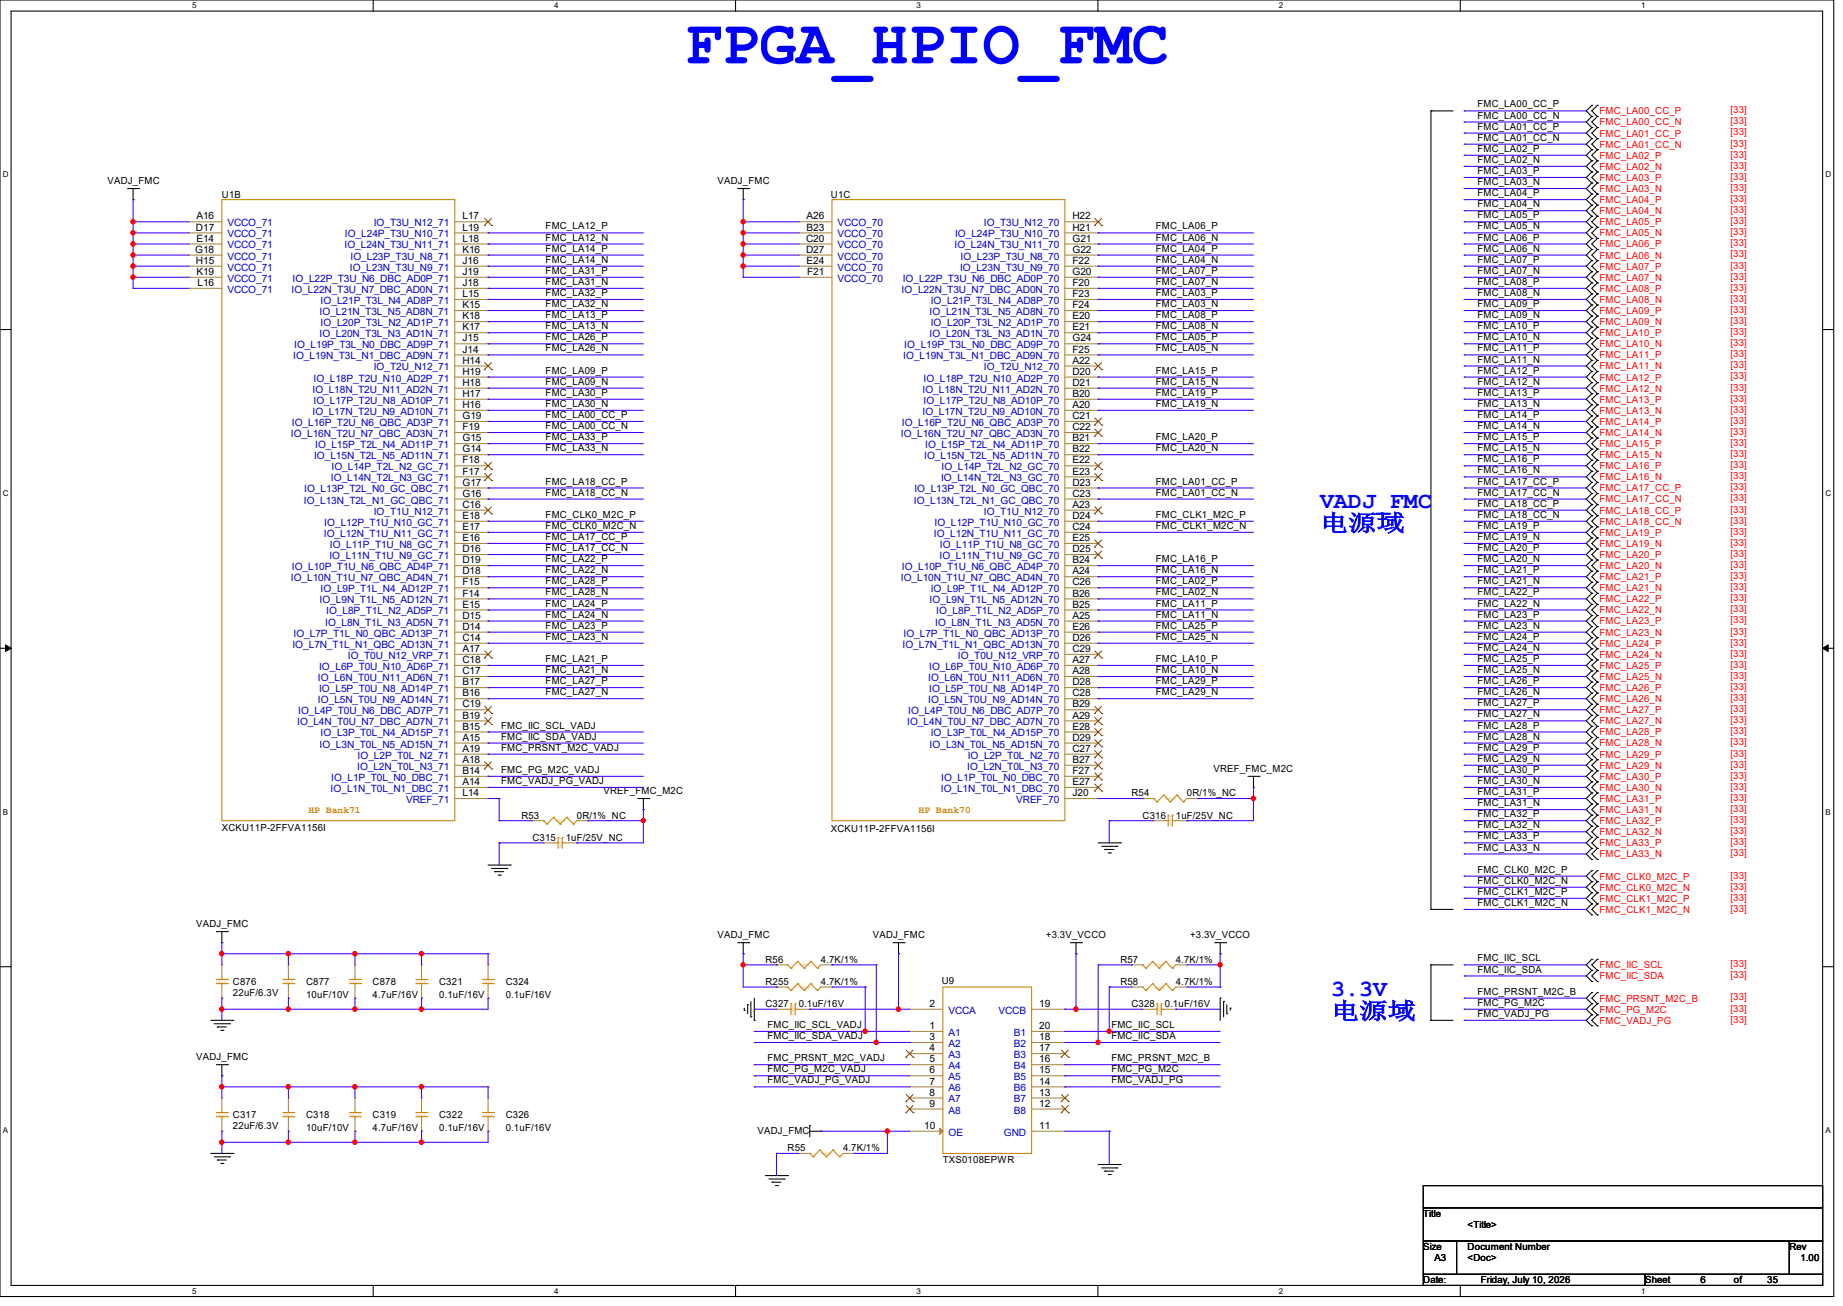
[picture p7: page 6]

# FPGA_OTHER

GPIO_BANK88_LP1 GPIO_BANK88_LN1 GPIO_BANK88_LP3 GPIO_BANK88_LN3 GPIO_BANK88_LP4 GPIO_BANK88_LN4 GPIO_BANK88_LP5 GPIO_BANK88_LN5 GPIO_BANK88_LP6 GPIO_BANK88_LN6 GPIO_BANK88_LP7 GPIO_BANK88_LN7 GPIO_BANK88_LP8 GPIO_BANK88_LN8 GPIO_BANK88_LP9 GPIO_BANK88_LN9 GPIO_BANK88_LP10 GPIO_BANK88_LN10 GPIO_BANK88_LP11 GPIO_BANK88_LN11 GPIO_BANK88_LP12 GPIO_BANK88_LN12

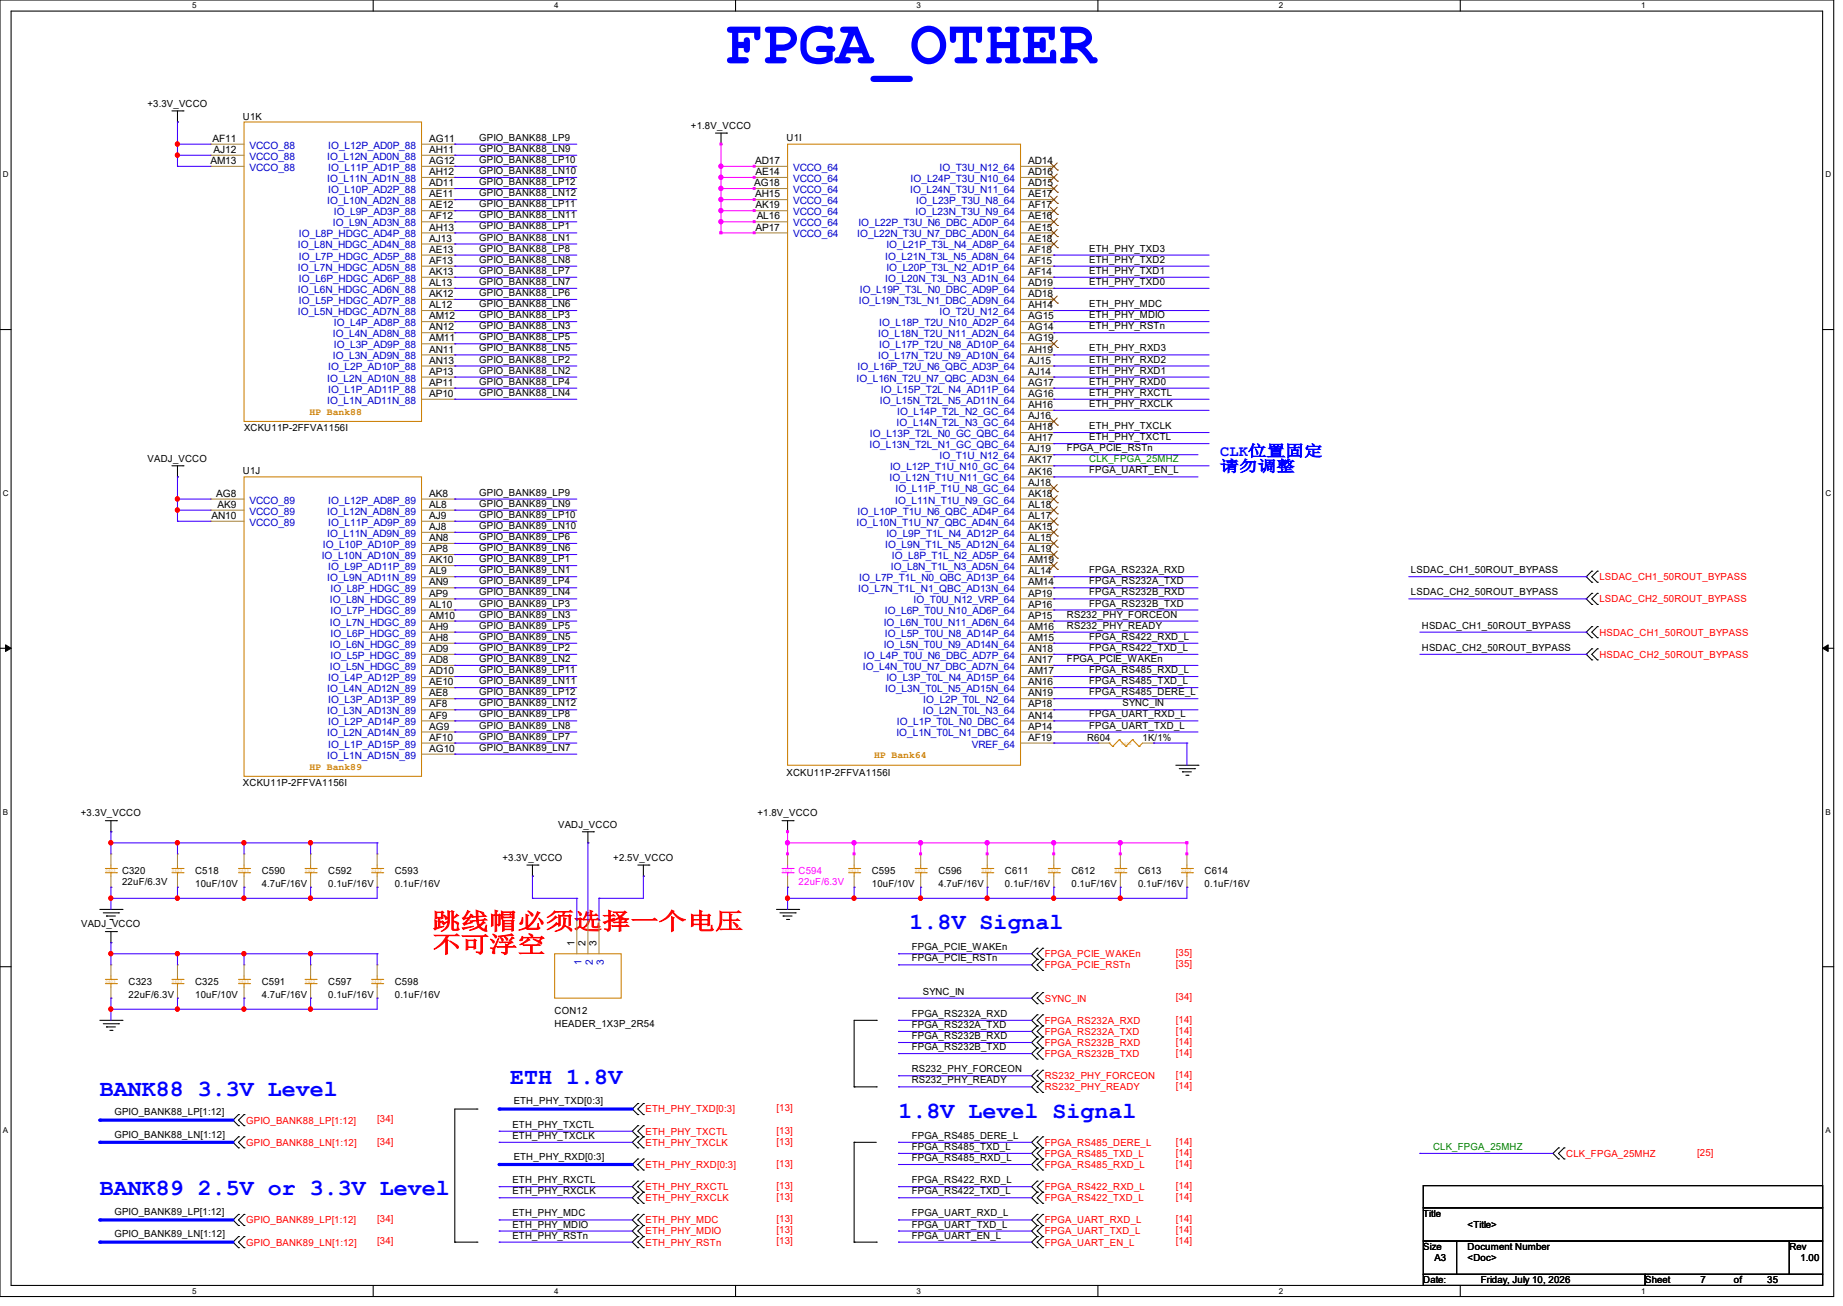
[picture p8: page 7]

# FGPA_GT_SerDes

# FMC HPC GT 8Lane

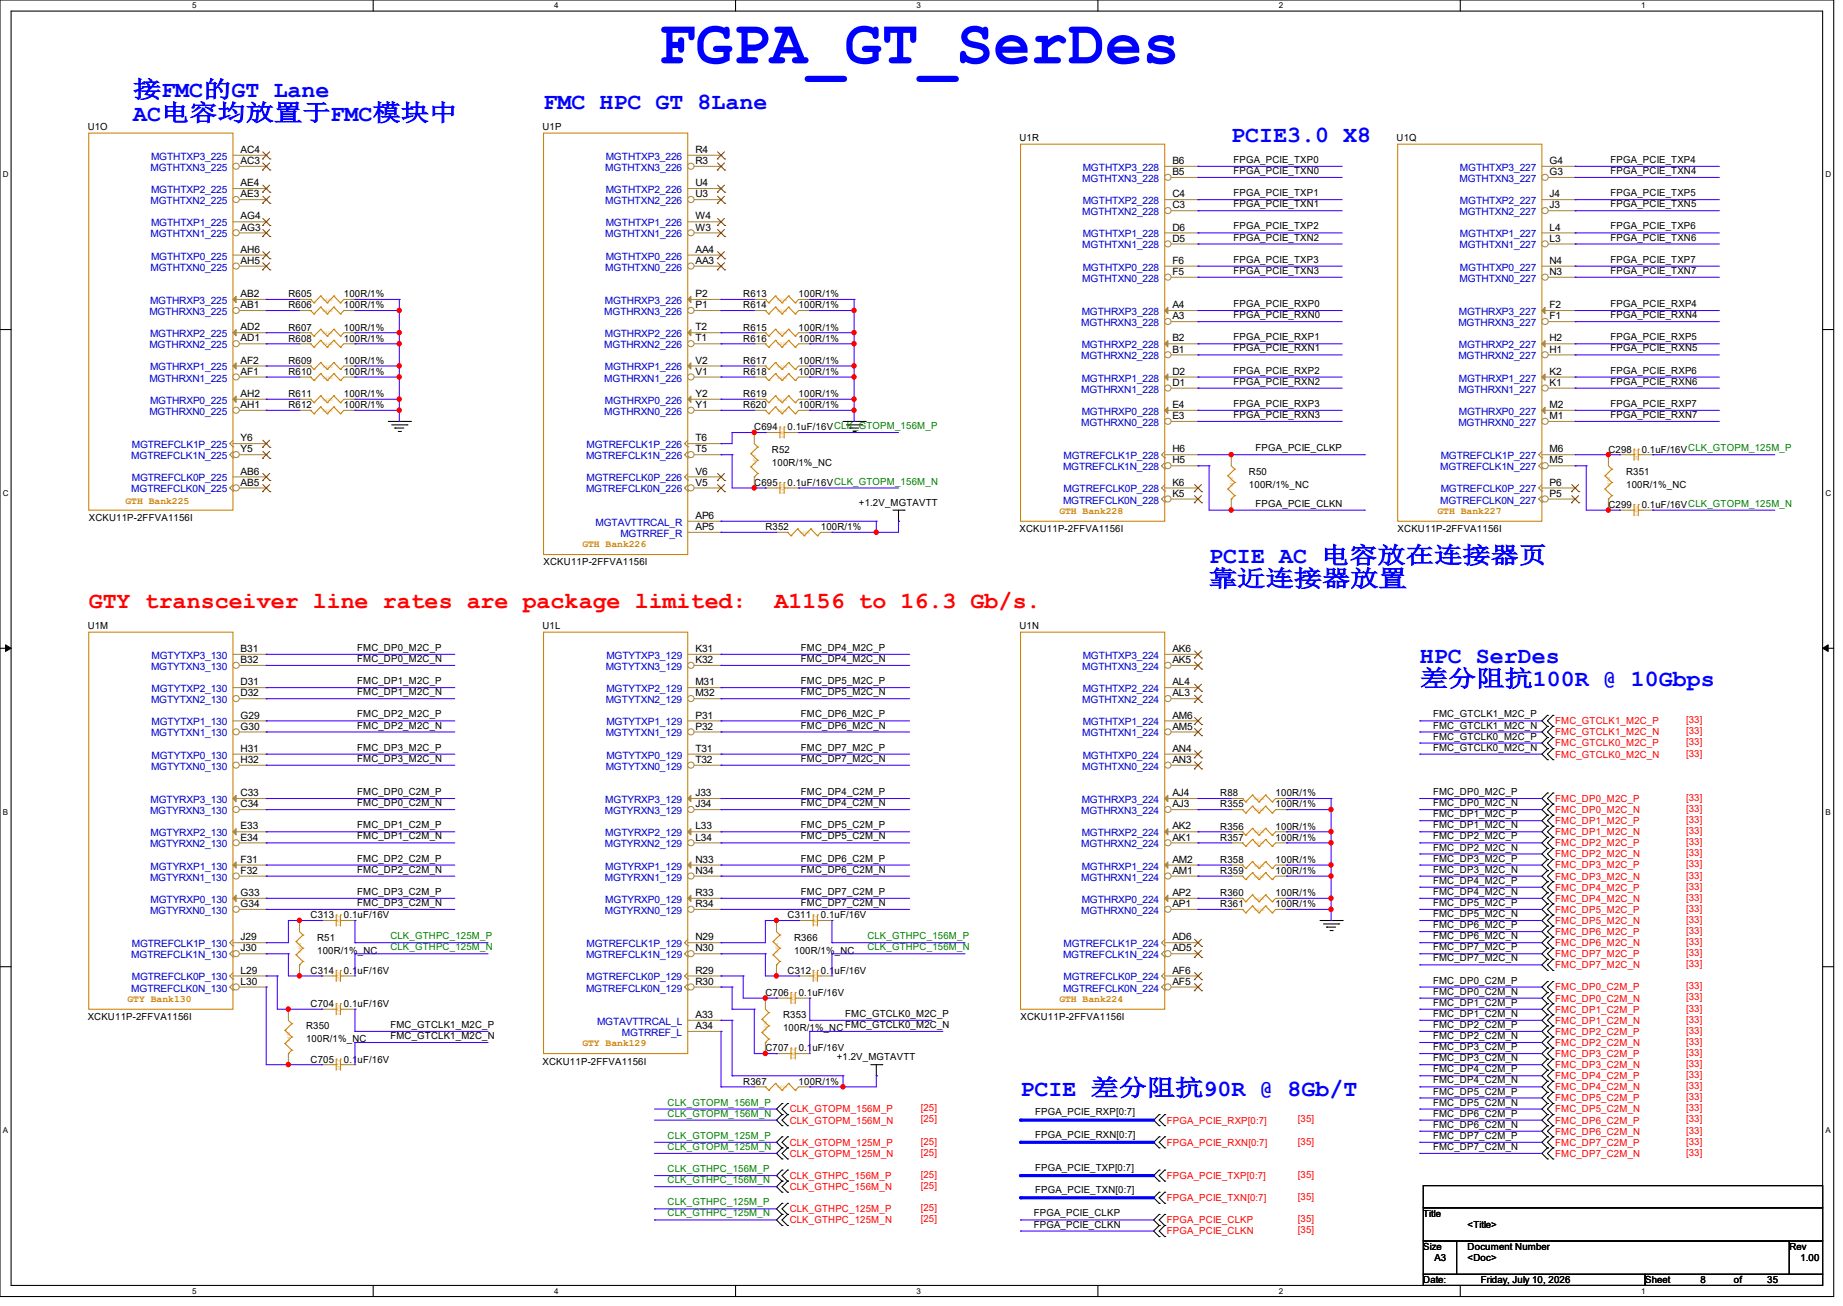
[picture p9: page 8]

GTY transceiver line rates are package limited: A1156 to 16.3 Gb/s.

# FPGA_GND&NC

GND F33 GND F34 GND F4 GND F7 GND G1 GND G13 GND G23 GND G28 GND G31 GND G5 GND G7 GND H10 GND H20 GND H28 GND H30 GND H34 GND H4 GND H7 GND J1 GND J17 GND J2 GND J27 GND J28 GND J32 GND J5 GND J7 GND K14 GND K24 GND K28 GND K3 GND K30 GND K34 GND K4 GND L1 GND L11 GND L21 GND L28 GND L31 GND L5 GND M10 GND M12 GND M14 GND M16 GND M18 GND M28 GND M30 GND M33 GND M34 GND M4 GND M8 GND N1 GND N11 GND N13 GND N15 GND N17 GND N19 GND N2 GND N25 GND N28 GND N32 GND N5 GND N9 GND P10 GND P12 GND P14 GND P16 GND P18

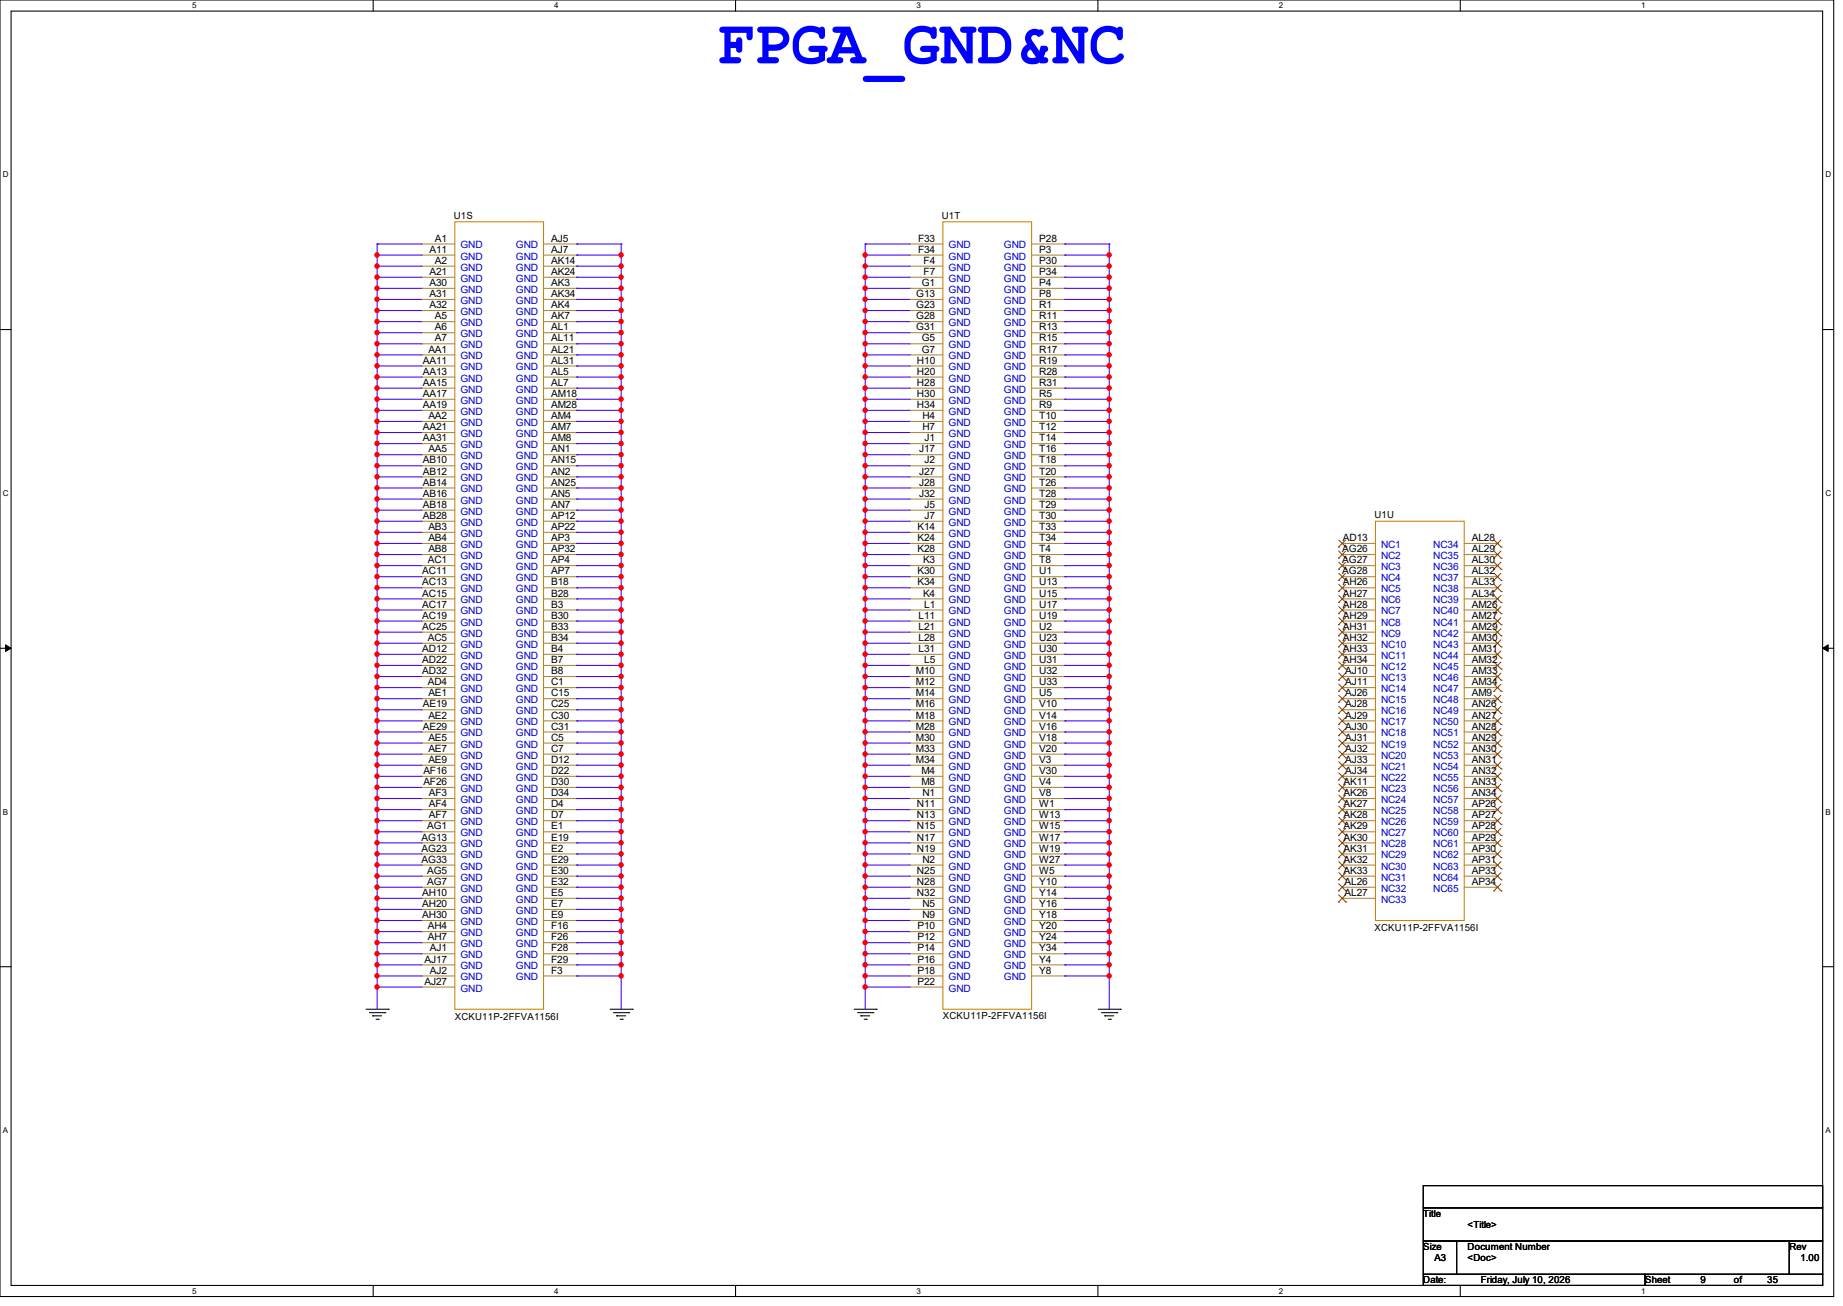
[picture p10: page 9]

GND A1 GND A11 GND A2 GND A21 GND A30 GND A31 GND A32 GND A5 GND A6 GND A7 GND AA1 GND AA11 GND AA13 GND AA15 GND AA17 GND AA19 GND AA2 GND AA21 GND AA31 GND AA5 GND AB10 GND AB12 GND AB14 GND AB16 GND AB18 GND AB28 GND AB3 GND AB4 GND AB8 GND AC1 GND AC11 GND AC13 GND AC15 GND AC17 GND AC19 GND AC25 GND AC5 GND AD12 GND AD22 GND AD32 GND AD4 GND AE1 GND AE19 GND AE2 GND AE29 GND AE5 GND AE7 GND AE9 GND AF16 GND AF26 GND AF3 GND AF4 GND AF7 GND AG1 GND AG13 GND AG23 GND AG33 GND AG5 GND AG7 GND AH10 GND AH20 GND AH30 GND AH4 GND AH7 GND AJ1 GND AJ17 GND AJ2 GND AJ27

GND P8 GND R1 GND R11 GND R13 GND R15 GND R17 GND R19 GND R28 GND R31 GND R5 GND R9 GND T10 GND T12 GND T14 GND T16 GND T18 GND T20

GND AJ5 GND AJ7 GND AK14 GND AK24 GND AK3 GND AK34 GND AK4 GND AK7 GND AL1 GND AL11 GND AL21 GND AL31 GND AL5 GND AL7 GND AM18 GND AM28 GND AM4 GND AM7 GND AM8 GND AN1 GND AN15 GND AN2 GND AN25 GND AN5 GND AN7 GND AP12 GND AP22 GND AP3 GND AP32 GND AP4 GND AP7 GND B18 GND B28 GND B3 GND B30 GND B33 GND B34 GND B4 GND B7 GND B8 GND C1 GND C15 GND C25 GND C30 GND C31 GND C5 GND C7 GND D12 GND D22 GND D30 GND D34 GND D4 GND D7 GND E1 GND E19 GND E2 GND E29 GND E30 GND E32 GND E5 GND E7 GND E9 GND F16 GND F26 GND F28 GND F29 GND F3

GND T26 GND T28 GND T29 GND T30 GND T33 GND T34 GND T4 GND T8 GND U1 GND U13 GND U15 GND U17 GND U19 GND U2 GND U23 GND U30 GND U31 GND U32 GND U33 GND U5 GND V10 GND V14 GND V16 GND V18 GND V20 GND V3 GND V30 GND V4 GND V8 GND W1 GND W13 GND W15 GND W17 GND W19 GND W27 GND W5 GND Y10 GND Y14 GND Y16 GND Y18 GND Y20 GND Y24 GND Y34 GND Y4 GND Y8

VCCINT AA10 VCCINT AA12 VCCINT AA14 VCCINT AA16 VCCINT AB11 VCCINT AB13 VCCINT AB15 VCCINT AC10 VCCINT AC12 VCCINT AC14 VCCINT AC16 VCCINT M11 VCCINT M13 VCCINT M15 VCCINT M9 VCCINT N10 VCCINT N12 VCCINT N14 VCCINT N16 VCCINT N8 VCCINT P11 VCCINT P13 VCCINT P15 VCCINT P9 VCCINT R10 VCCINT R12 VCCINT R14 VCCINT R16 VCCINT R8 VCCINT T11 VCCINT T13 VCCINT T15 VCCINT T17 VCCINT T9 VCCINT U10 VCCINT U14 VCCINT U16 VCCINT V13 VCCINT V15 VCCINT W10 VCCINT W14 VCCINT W16 VCCINT Y13 VCCINT Y15

XCKU11P-2FFVA1156I VCCAUX AA8 VCCAUX AC8 VCCAUX U8 VCCAUX W8 VCCBRAM AA18 VCCBRAM AB17 VCCBRAM V17 VCCBRAM Y17 VCCINT_IO M17 VCCINT_IO P17 VCCINT_IO R18 VCCINT_IO U18 VCCINT_IO W18 VCCAUX_IO AB19 VCCAUX_IO AC18 VCCAUX_IO M19 VCCAUX_IO N18 VCCAUX_IO P19 VCCAUX_IO R20 VCCAUX_IO T19 VCCAUX_IO U20 VCCAUX_IO V19 VCCAUX_IO W20 VCCAUX_IO Y19

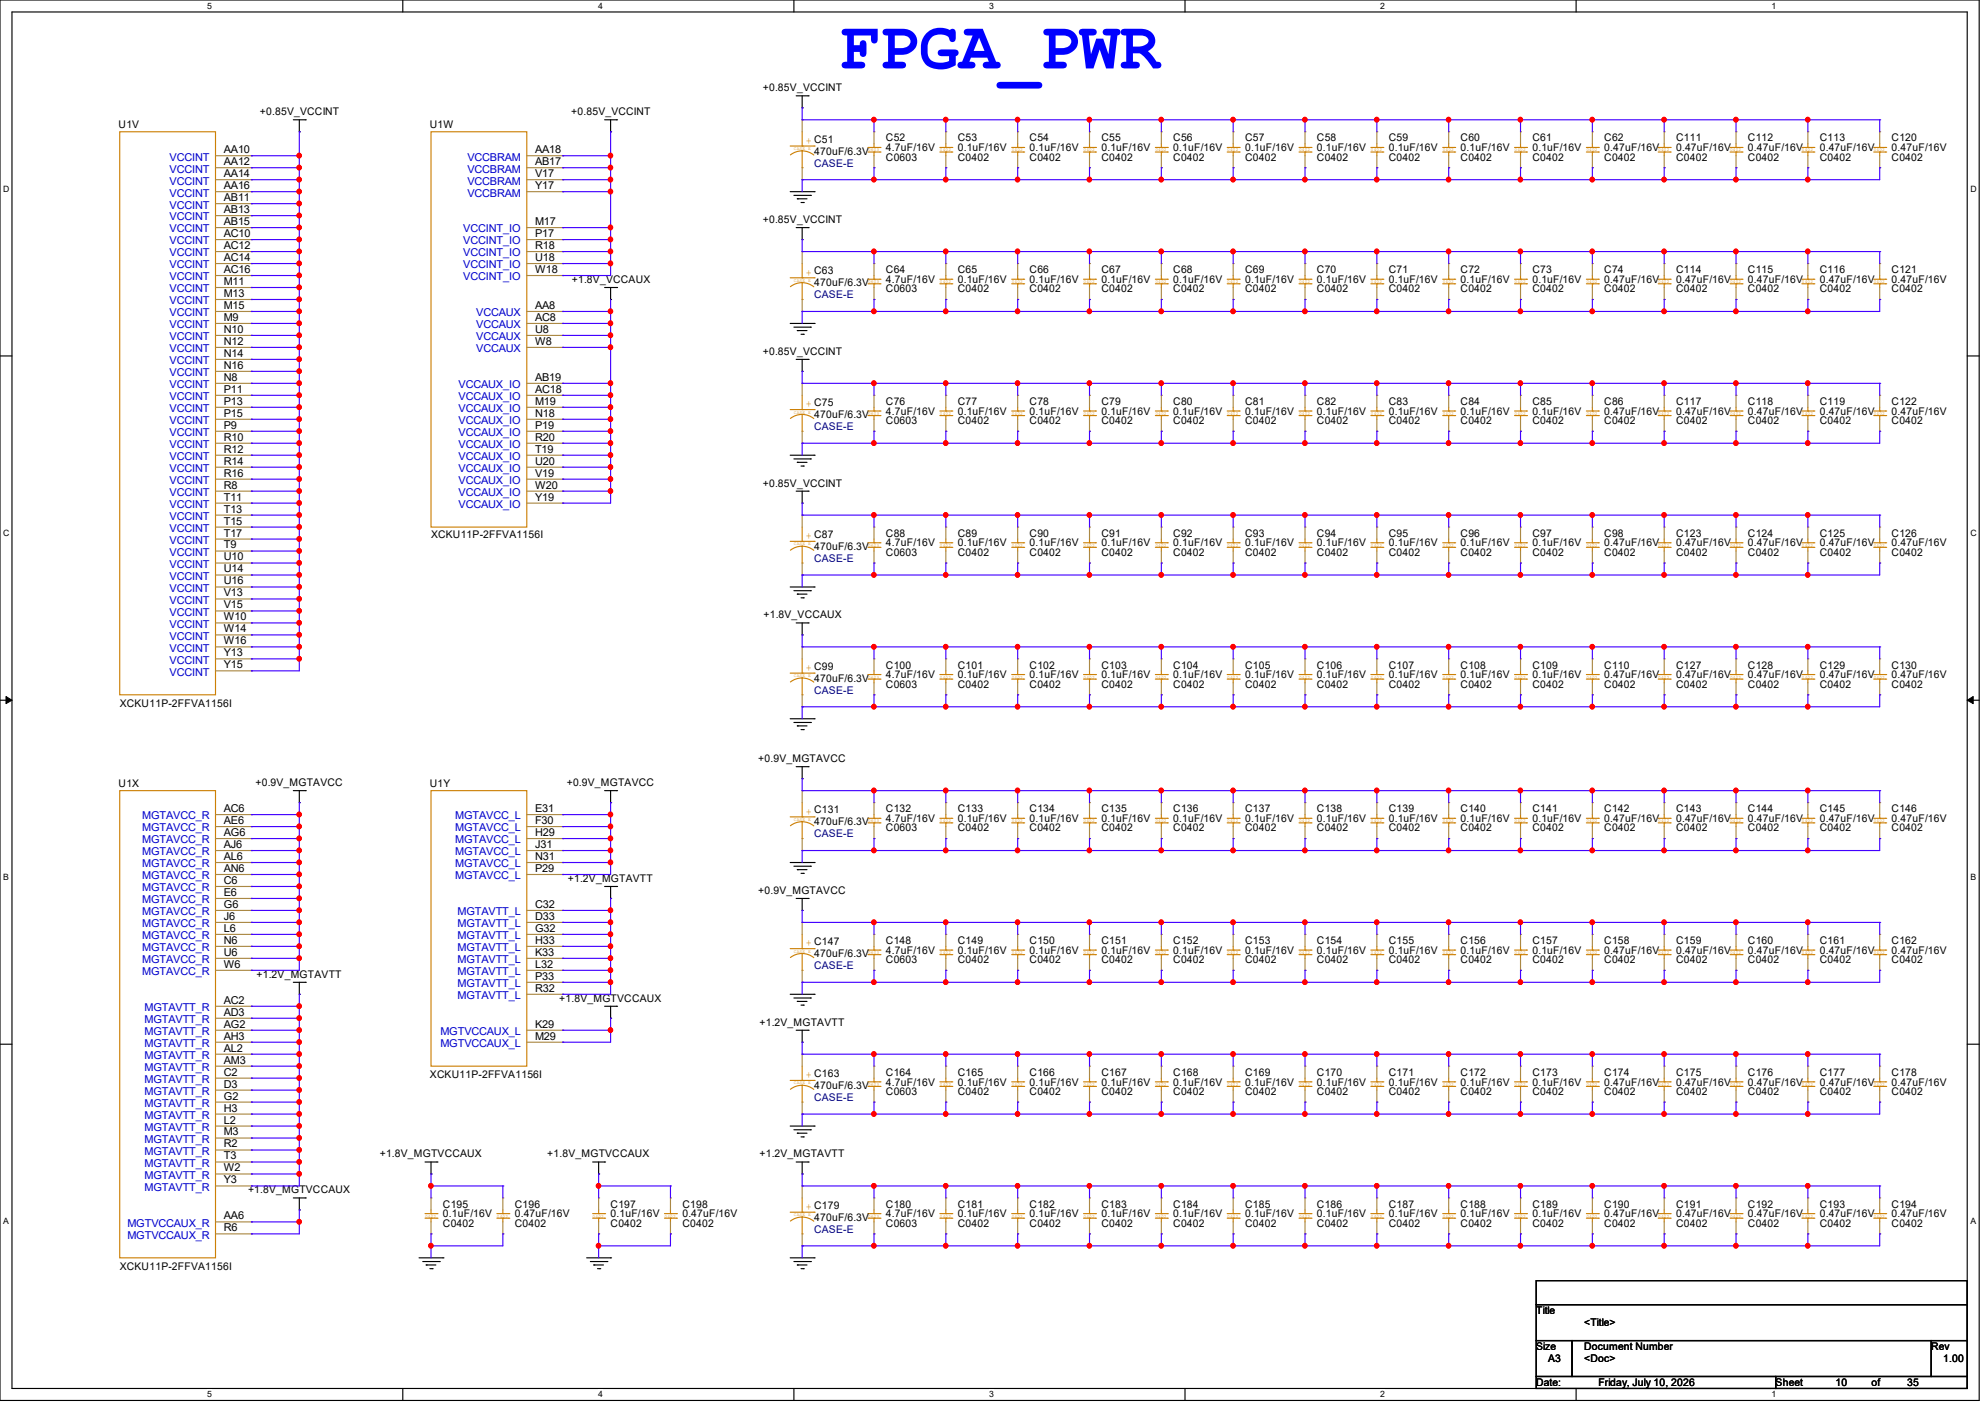
[picture p11: page 10]

# FPGA_DDR4

# LDM/LDBI E7 DQ0 G2 DQ1 F7 DQ2 H3 DQ3 H7 DQ4 H2 DQ5 H8 DQ6 J3 DQ7 J7

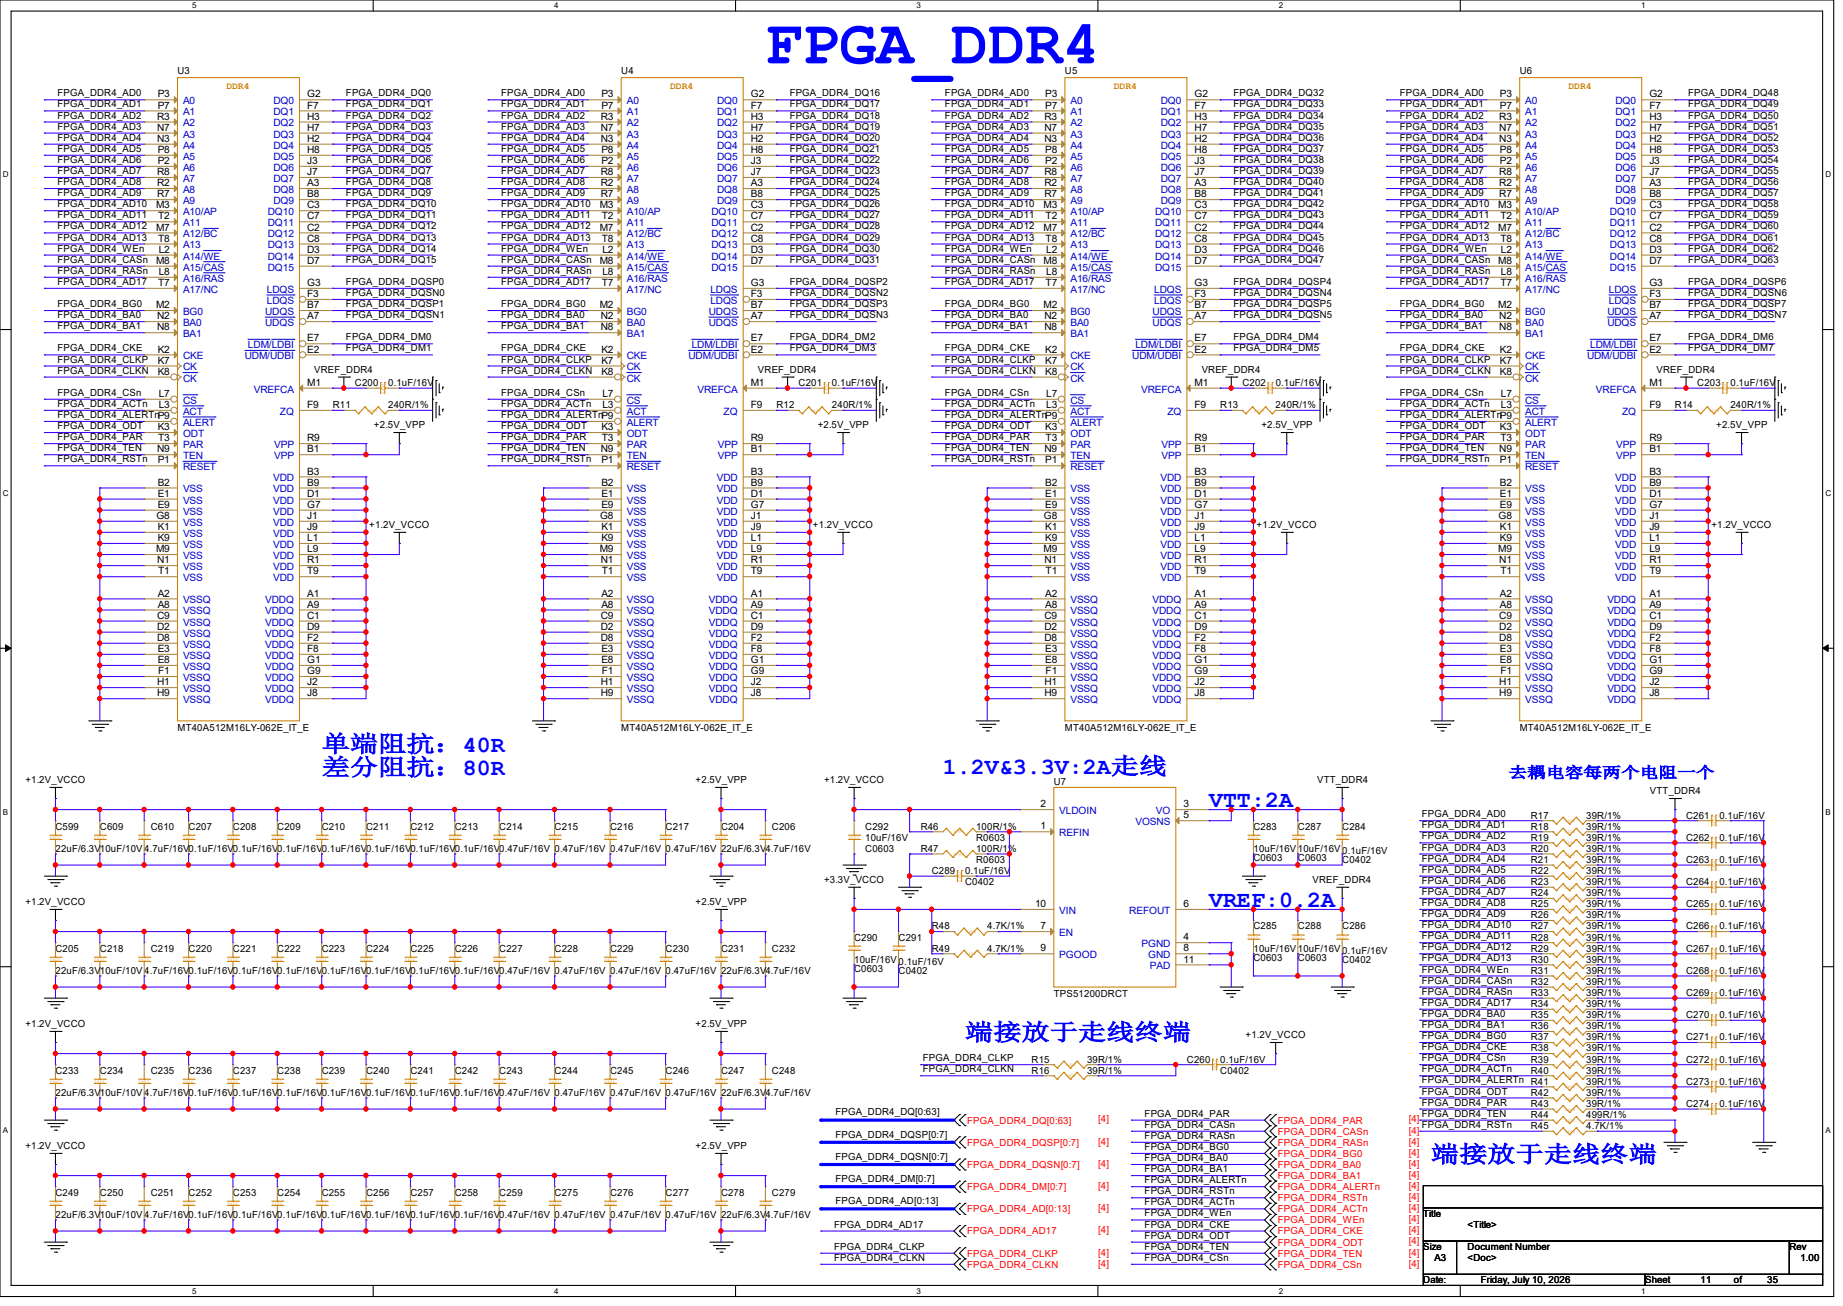
[picture p12: page 11]

# USB_PHY 设计参考

## infineon-an70707-ez-usb-fx3-fx3s-hardware-design-

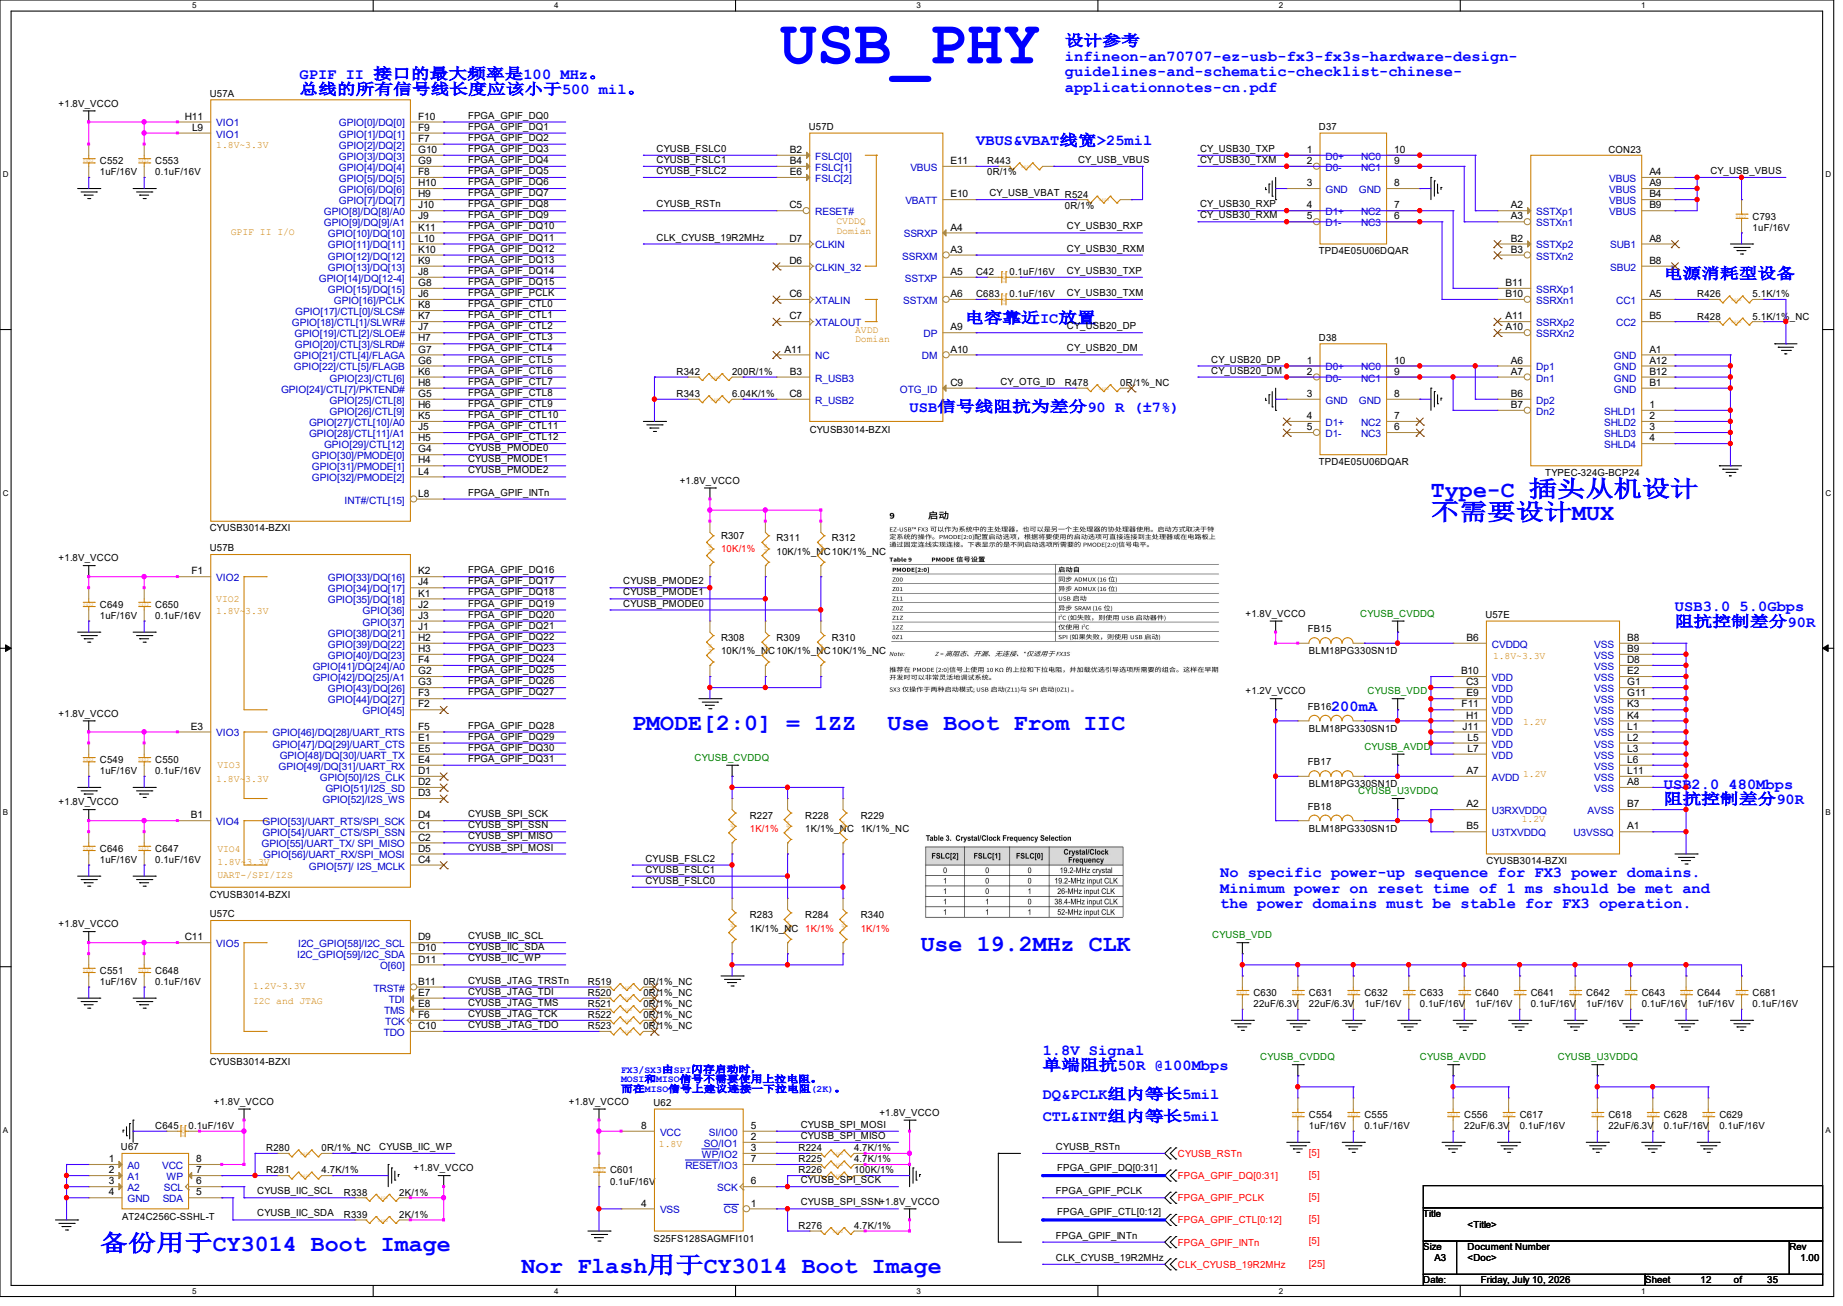
[picture p13: page 12]

GPIF II 接口的最大频率是100 MHz。
总线的所有信号线长度应该小于500 mil。
FPGA_GPIF_DQ0 FPGA_GPIF_DQ1 FPGA_GPIF_DQ2 FPGA_GPIF_DQ3 FPGA_GPIF_DQ4 FPGA_GPIF_DQ5 FPGA_GPIF_DQ6 FPGA_GPIF_DQ7 FPGA_GPIF_DQ8 FPGA_GPIF_DQ9 FPGA_GPIF_DQ10 FPGA_GPIF_DQ11 FPGA_GPIF_DQ12 FPGA_GPIF_DQ13 FPGA_GPIF_DQ14 FPGA_GPIF_DQ15 FPGA_GPIF_PCLK
GPIO[0]/DQ[0] F10 GPIO[5]/DQ[5] F8 GPIO[1]/DQ[1] F9 GPIO[2]/DQ[2] F7 GPIO[22]/CTL[5]/FLAGB G6 GPIO[21]/CTL[4]/FLAGA G7 GPIO[15]/DQ[15] G8 GPIO[4]/DQ[4] G9 GPIO[3]/DQ[3] G10 GPIO[20]/CTL[3]/SLRD# H7 GPIO[7]/DQ[7] H9 GPIO[6]/DQ[6] H10 GPIO[16]/PCLK J6 GPIO[19]/CTL[2]/SLOE# J7 GPIO[14]/DQ[12-4] J8 GPIO[9]/DQ[9]/A1 J9 GPIO[8]/DQ[8]/A0 J10 GPIO[23]/CTL[6] K6 GPIO[18]/CTL[1]/SLWR# K7 GPIO[17]/CTL[0]/SLCS# K8 GPIO[13]/DQ[13] K9 GPIO[12]/DQ[12] K10 GPIO[10]/DQ[10] K11 GPIO[11]/DQ[11] L10 GPIO[30]/PMODE[0] G4 GPIO[25]/CTL[8] G5 GPIO[31]/PMODE[1] H4 GPIO[29]/CTL[12] H5 GPIO[26]/CTL[9] H6 GPIO[24]/CTL[7]/PKTEND# H8 GPIO[28]/CTL[11]/A1 J5 GPIO[27]/CTL[10]/A0 K5 GPIO[32]/PMODE[2] L4

guidelines-and-schematic-checklist-chinese-
applicationnotes-cn.pdf
FPGA_GPIF_CTL0 FPGA_GPIF_CTL1 FPGA_GPIF_CTL2 FPGA_GPIF_CTL3 FPGA_GPIF_CTL4 FPGA_GPIF_CTL5 FPGA_GPIF_CTL6 FPGA_GPIF_CTL7 FPGA_GPIF_CTL8 FPGA_GPIF_CTL9 FPGA_GPIF_CTL10 FPGA_GPIF_CTL11 FPGA_GPIF_CTL12 CYUSB_PMODE0 FPGA_GPIF_INTn

PMODE[2:0] = 1ZZ Use Boot From IIC

No specific power-up sequence for FX3 power domains.
Minimum power on reset time of 1 ms should be met and
the power domains must be stable for FX3 operation.

I2C_GPIO[59]/I2C_SDA D10 O[60] D11 TRST# B11 TDI E7 TDO C10 TMS E8 TCK F6

# ETH_PHY

## 靠近PHY芯片放置

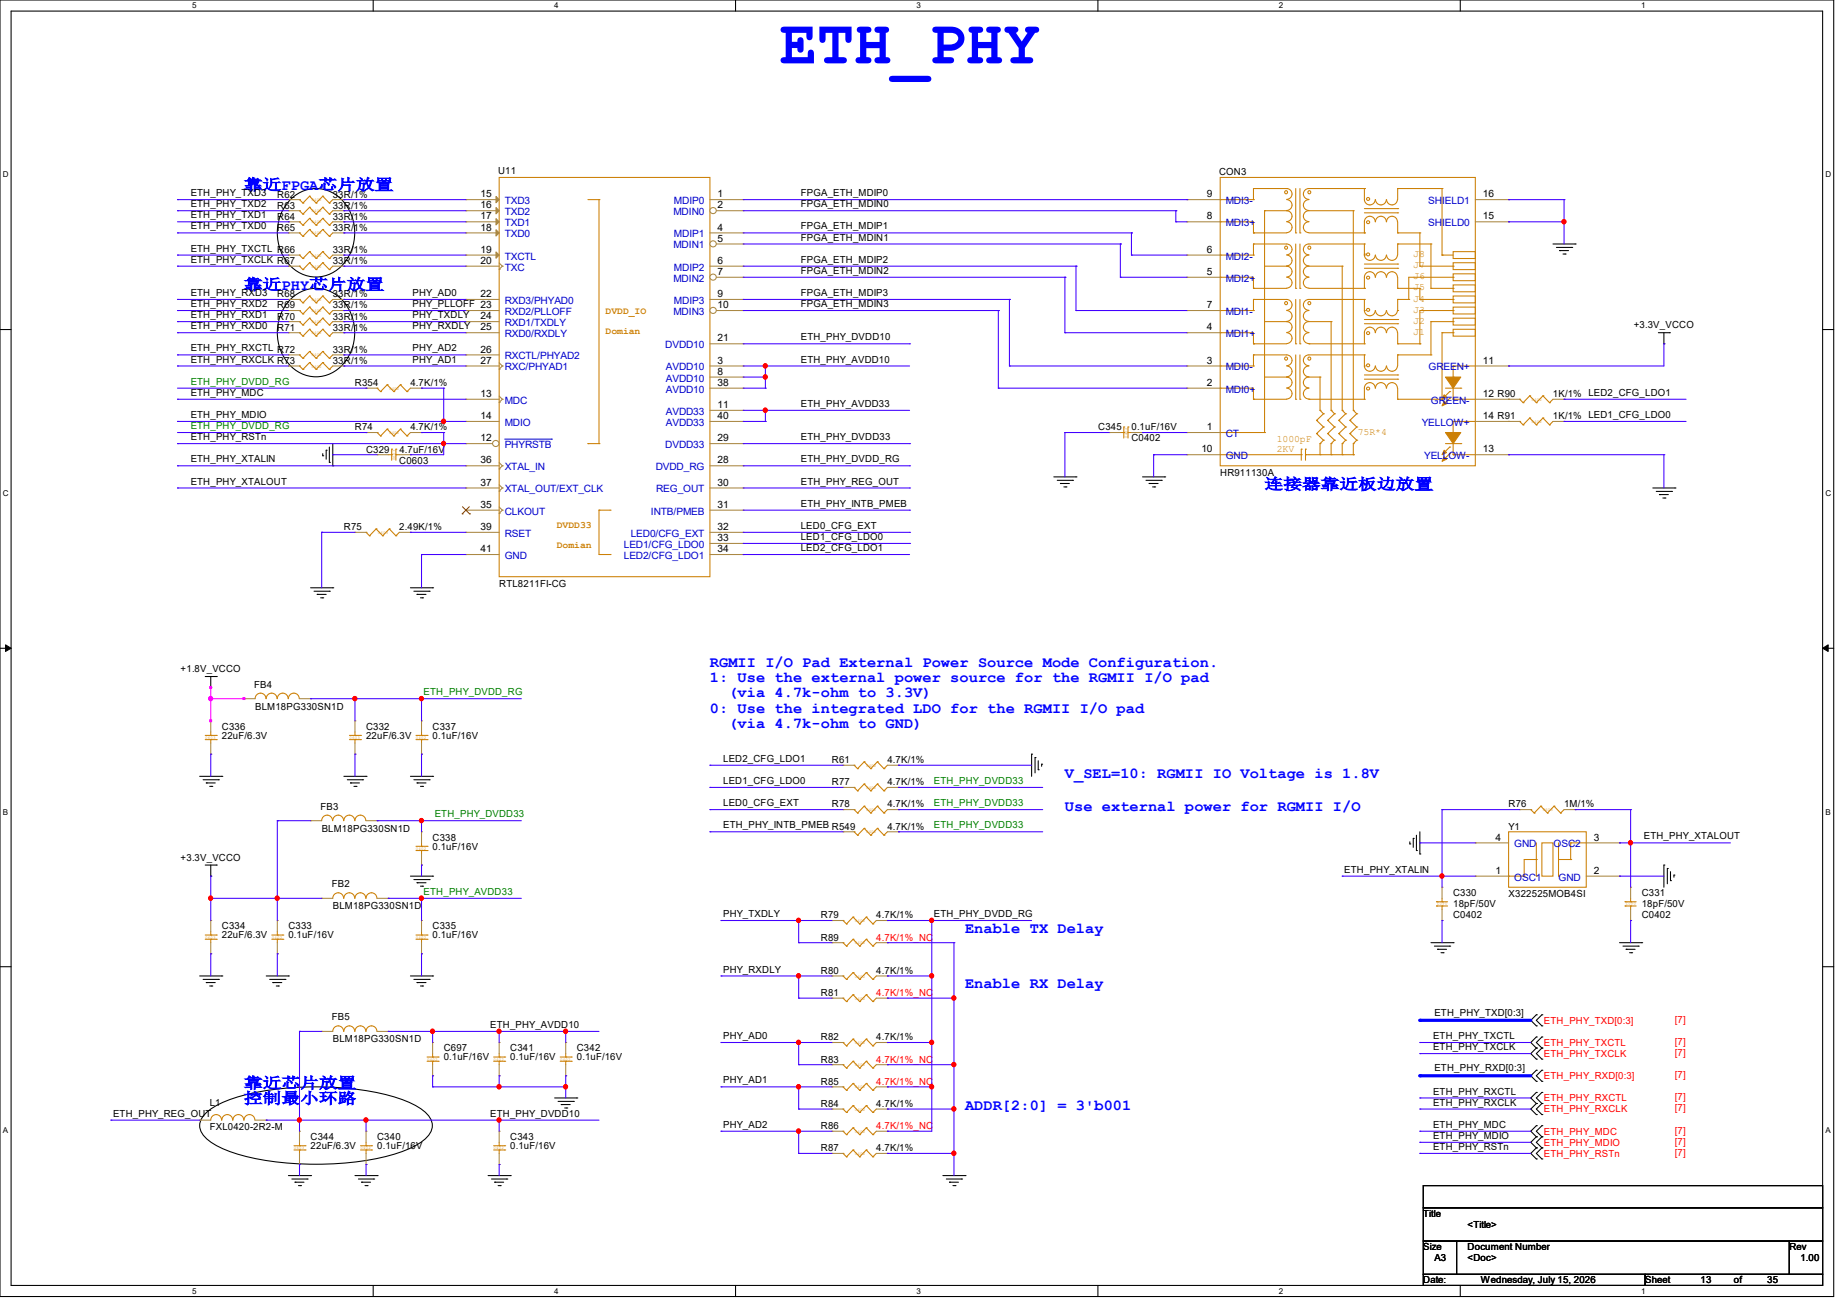
[picture p14: page 13]

TXD3 15 TXD2 16 TXD1 17 TXD0 18 TXCTL 19 TXC 20 RXD3/PHYAD0 22 RXD2/PLLOFF 23 RXD1/TXDLY 24 RXD0/RXDLY 25 RXCTL/PHYAD2 26 RXC/PHYAD1 27 MDC 13 MDIO 14

RGMII I/O Pad External Power Source Mode Configuration.
1: Use the external power source for the RGMII I/O pad
(via 4.7k-ohm to 3.3V)
0: Use the integrated LDO for the RGMII I/O pad
(via 4.7k-ohm to GND)

V_SEL=10: RGMII IO Voltage is 1.8V
Use external power for RGMII I/O

# PHY_RSXXX

1.8V

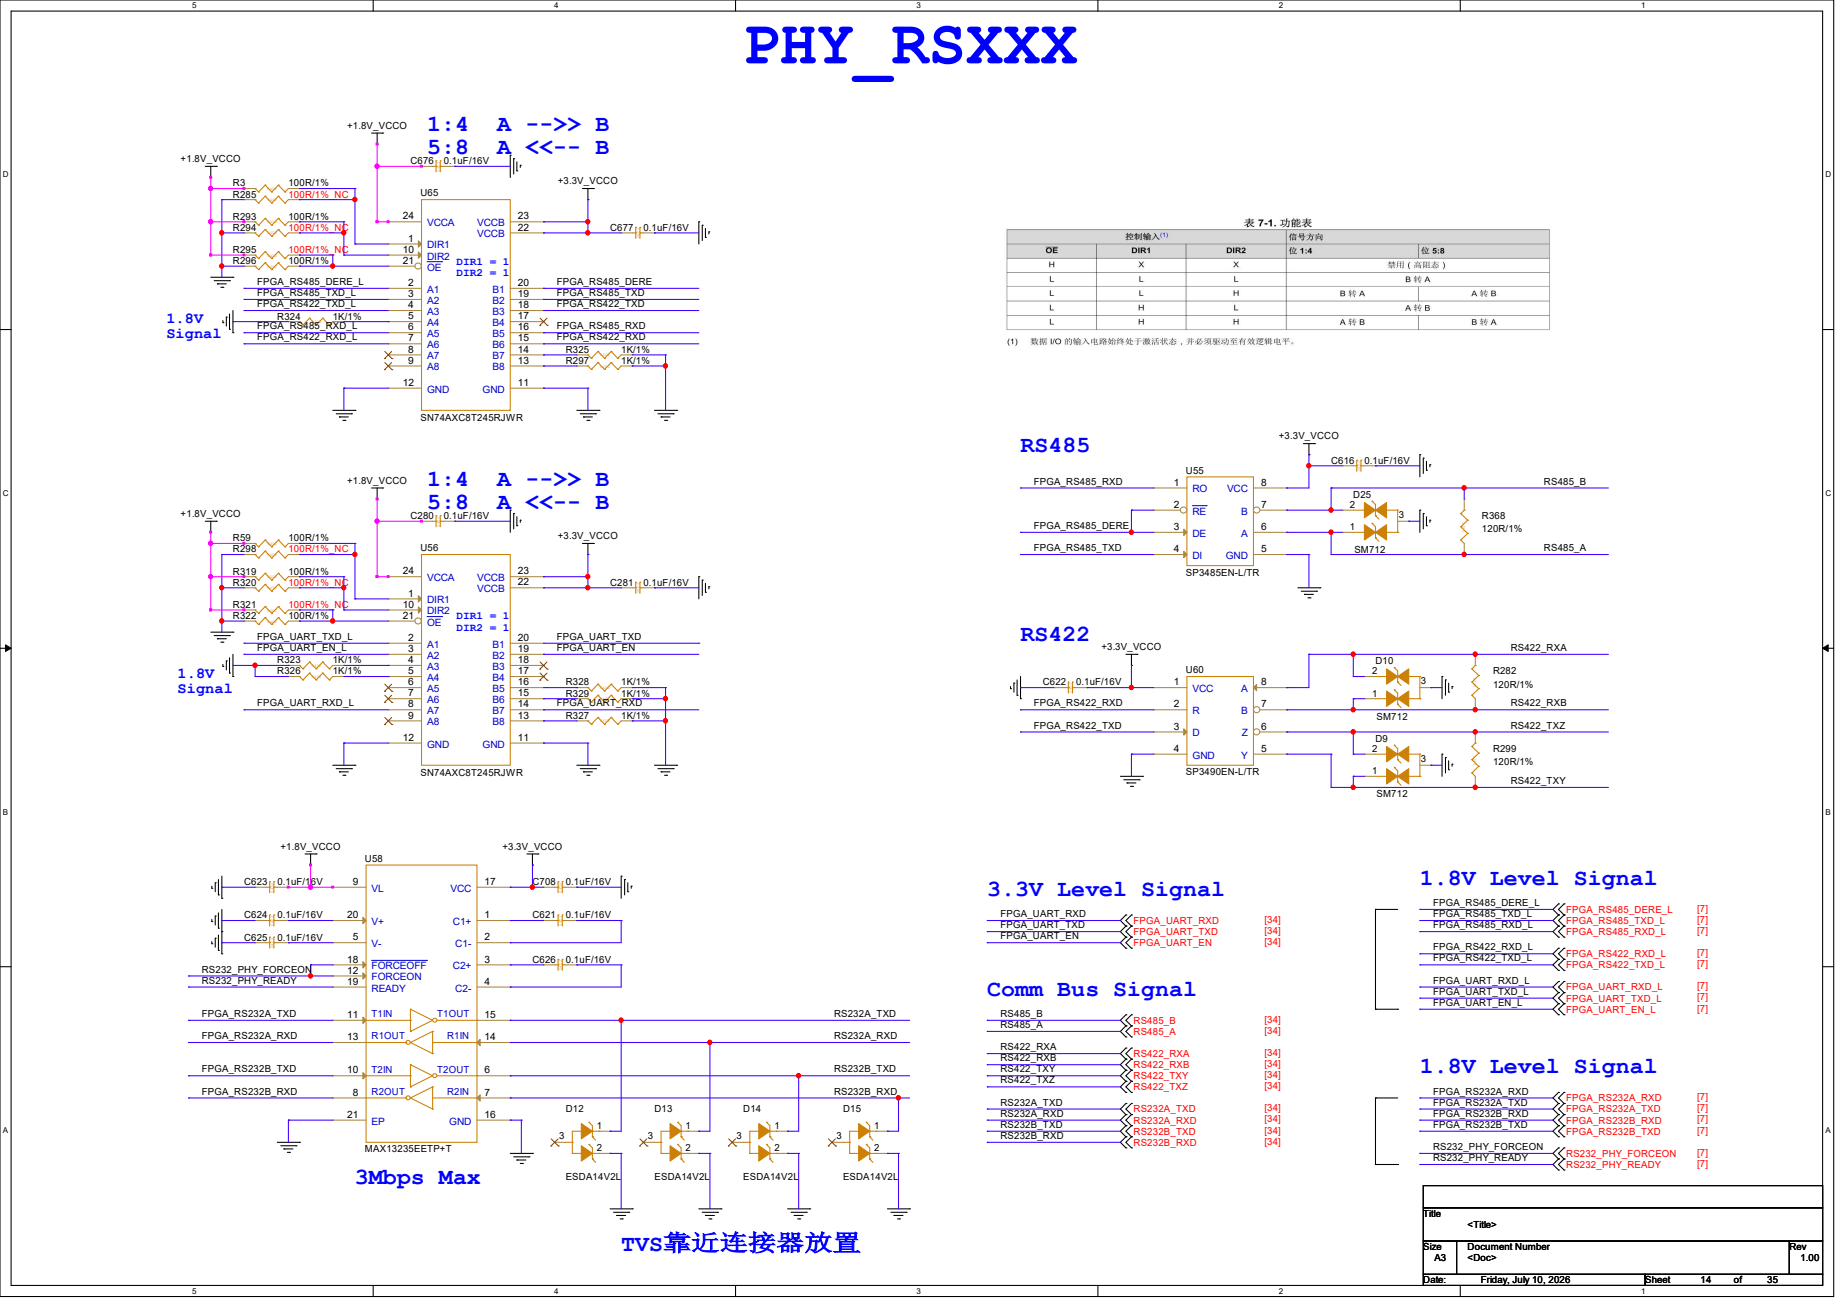
[picture p15: page 14]

## AD5791BRUZ（20bit，1Msps，单通道，电压输出）

## 输出电压范围：±2.5V，±5V，±10V 一共三个范围可调节（电压输出）； DAC_AD5791 输入接口形式：2个SMA。 （2个这个芯片）

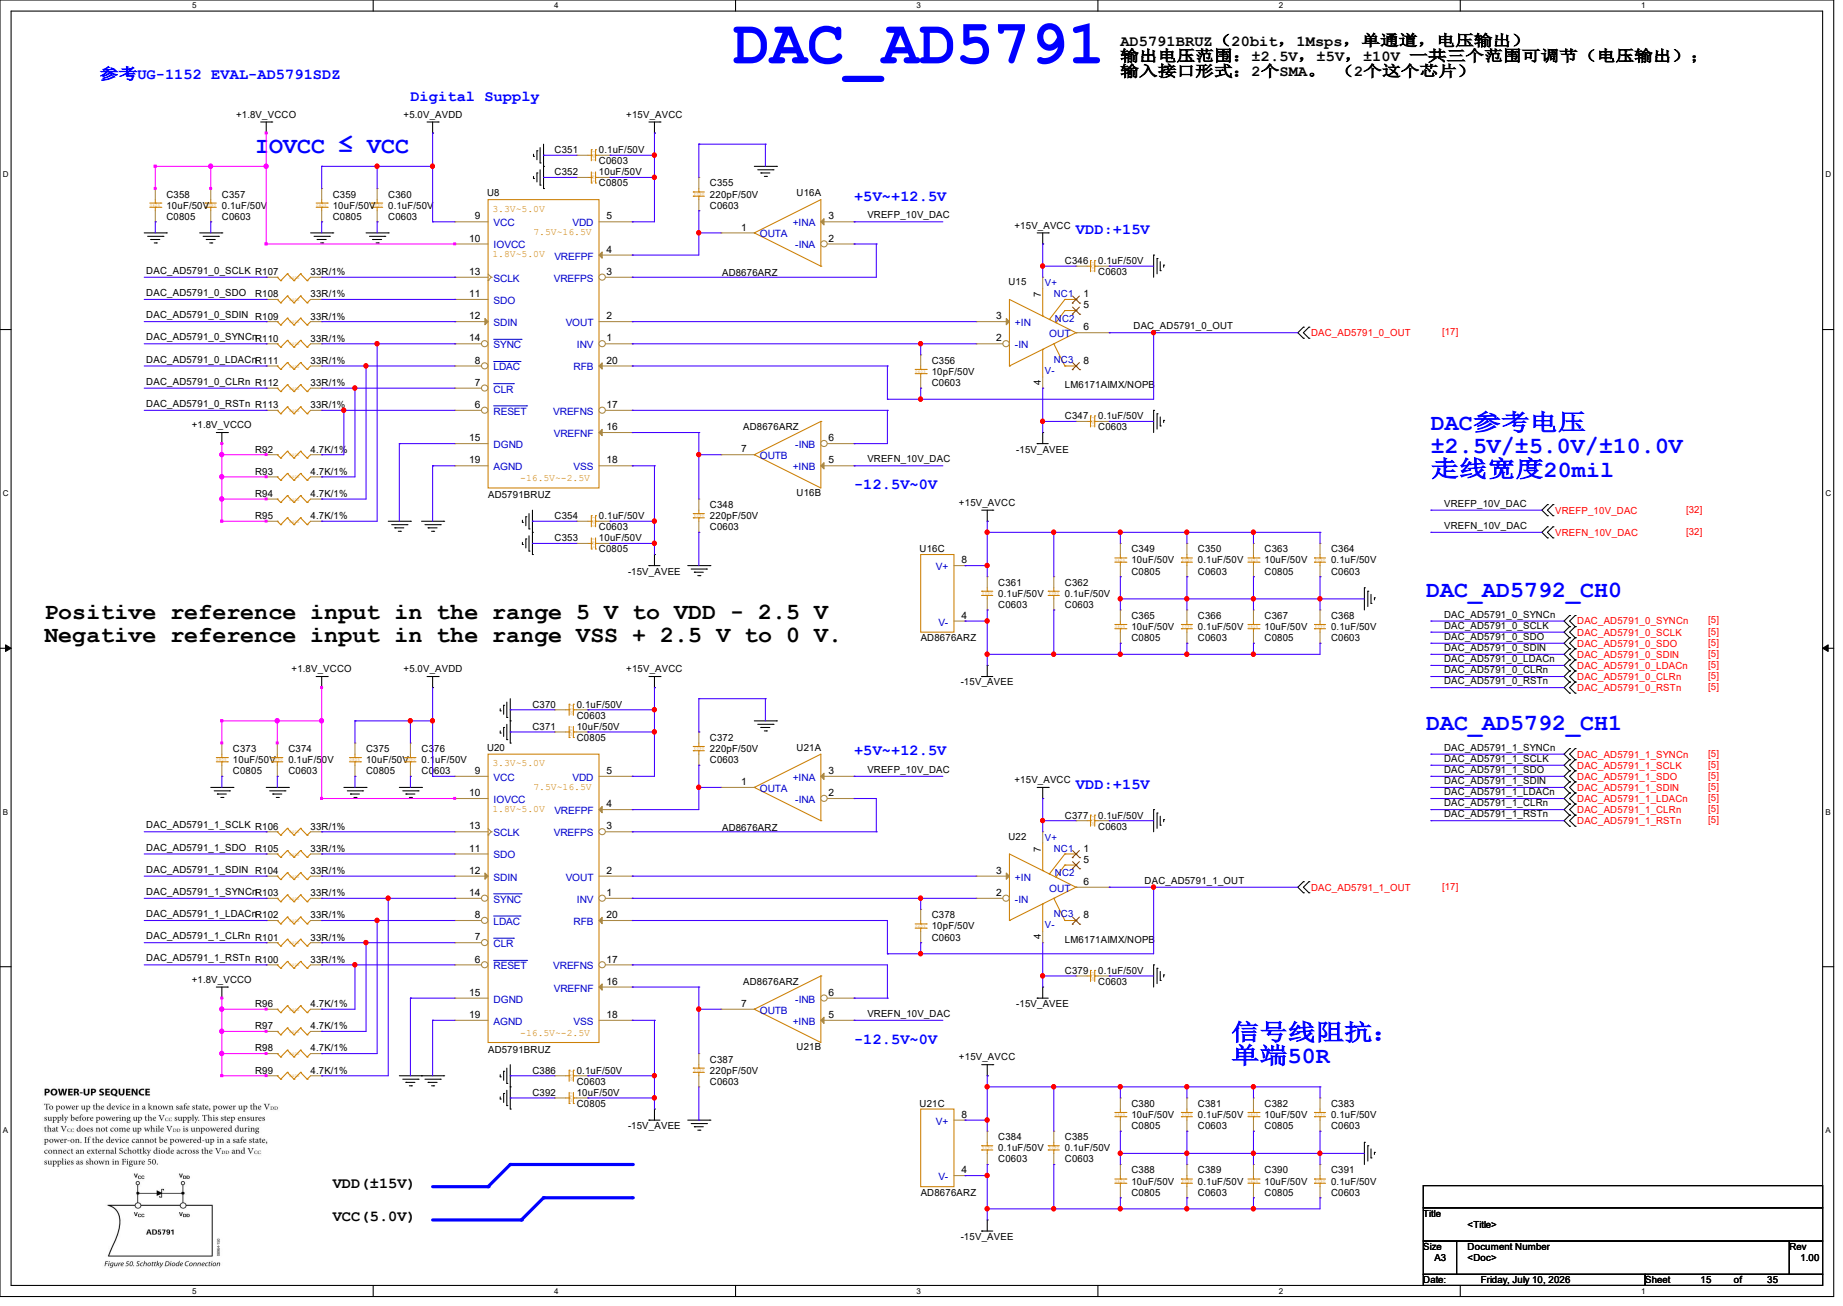
[picture p16: page 15]

Digital Supply
U8AD5791BRUZ
INV 1 VOUT 2 VREFPS 3 VREFPF 4 VDD 5 RESET 6 CLR 7

Positive reference input in the range 5 V to VDD - 2.5 V
Negative reference input in the range VSS + 2.5 V to 0 V.

## AD3552RBCPZ16-RL7（16bit，33Msps，双通道，电流输出）

## 后端要求转换，将输出的电流信号转为电压信号; 输出电压范围：±2.5V，±5V，±10V 一共三个范围可调节（电压输出）; 输出接口形式：2个SMA。

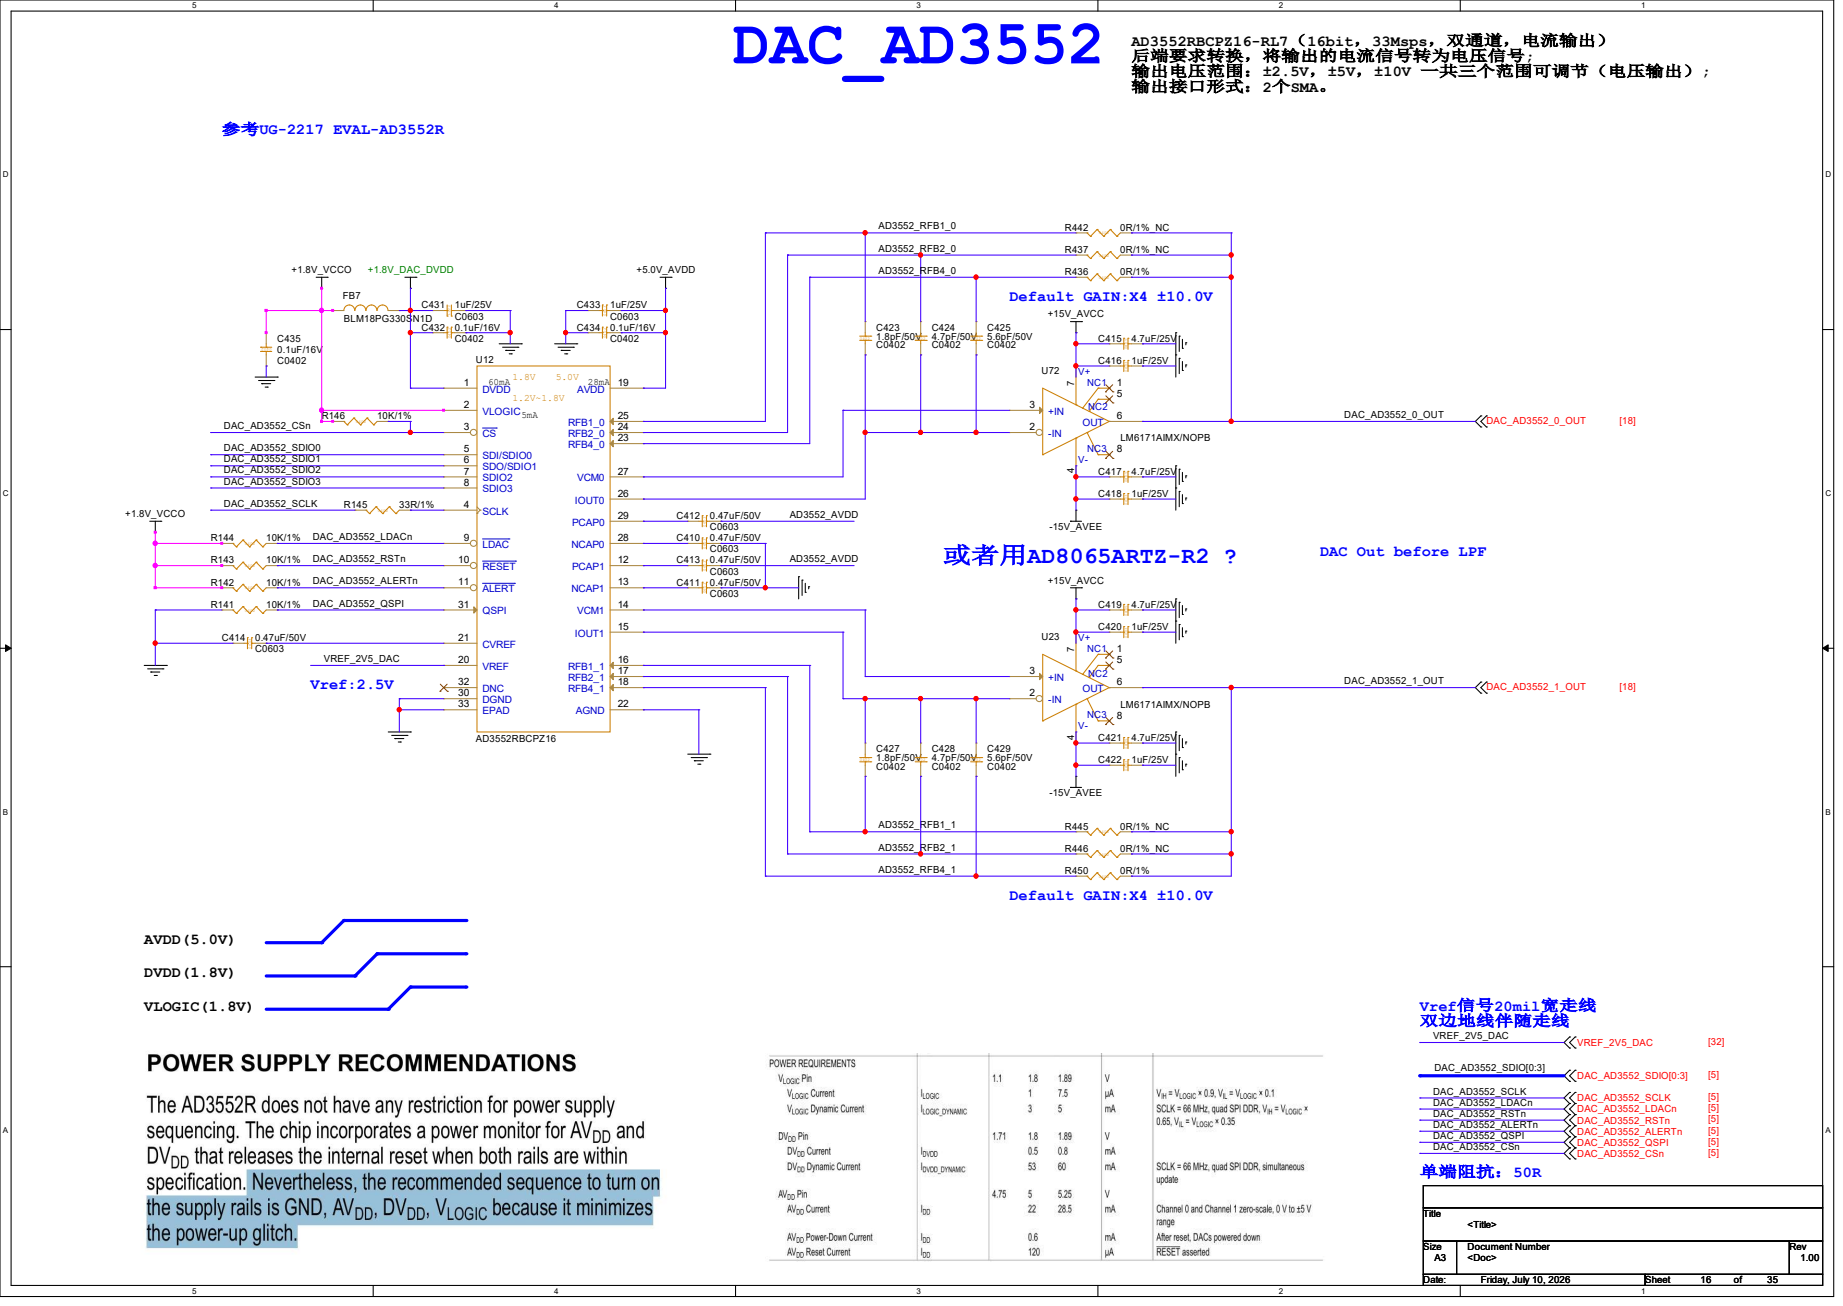
[picture p17: page 16]

CS 3 SCLK 4 SDI/SDIO0 5 SDO/SDIO1 6 SDIO2 7 SDIO3 8

# LSDAC_LPF 低速DAC的滤波截止频率设计为250KHZ

# 采用二阶Bessel低通滤波

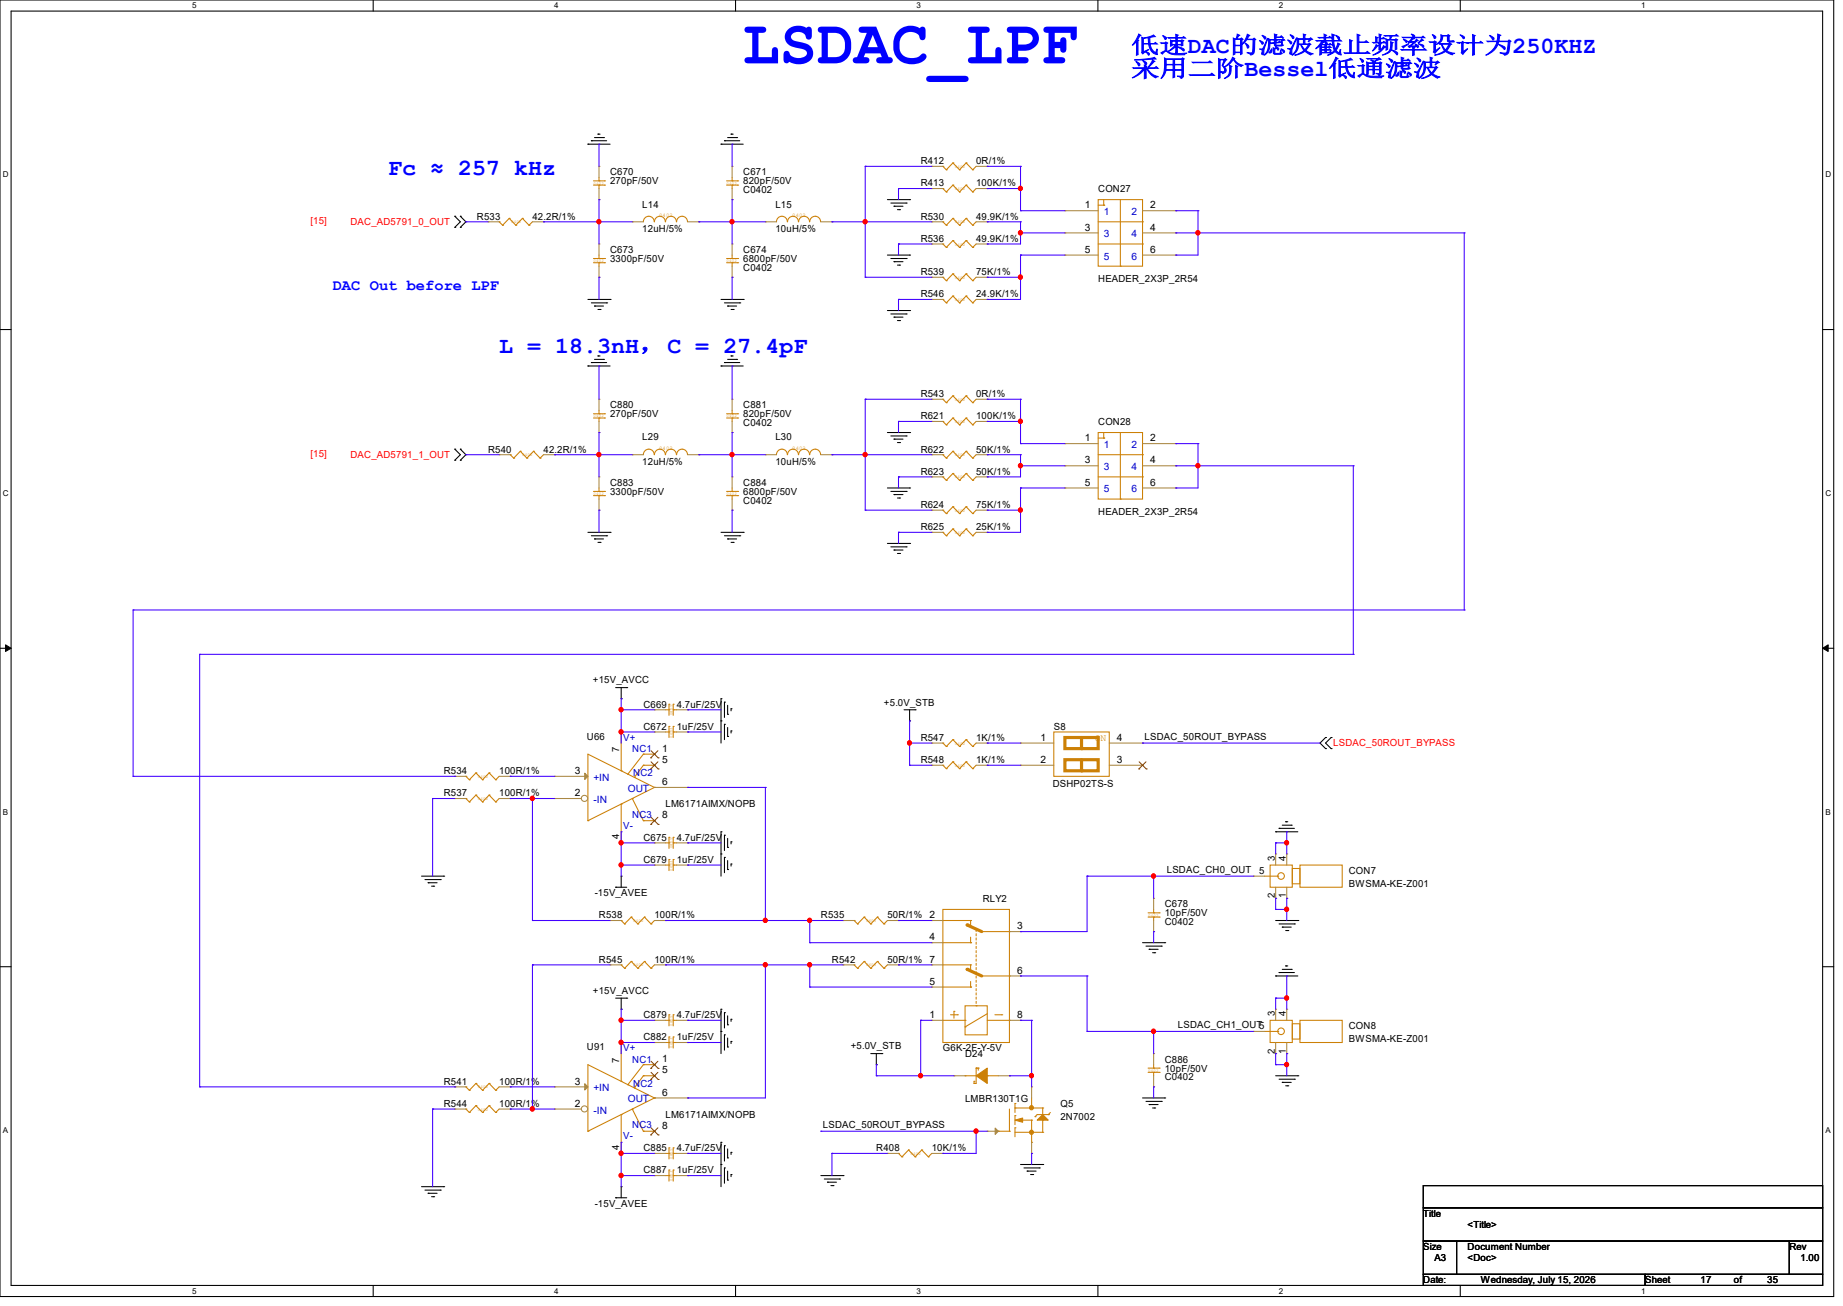
[picture p18: page 17]

DAC Out before LPF

# HSDAC_LPF 高速DAC的滤波截至频率设计为5MHZ

# 采用二阶Bessel低通滤波

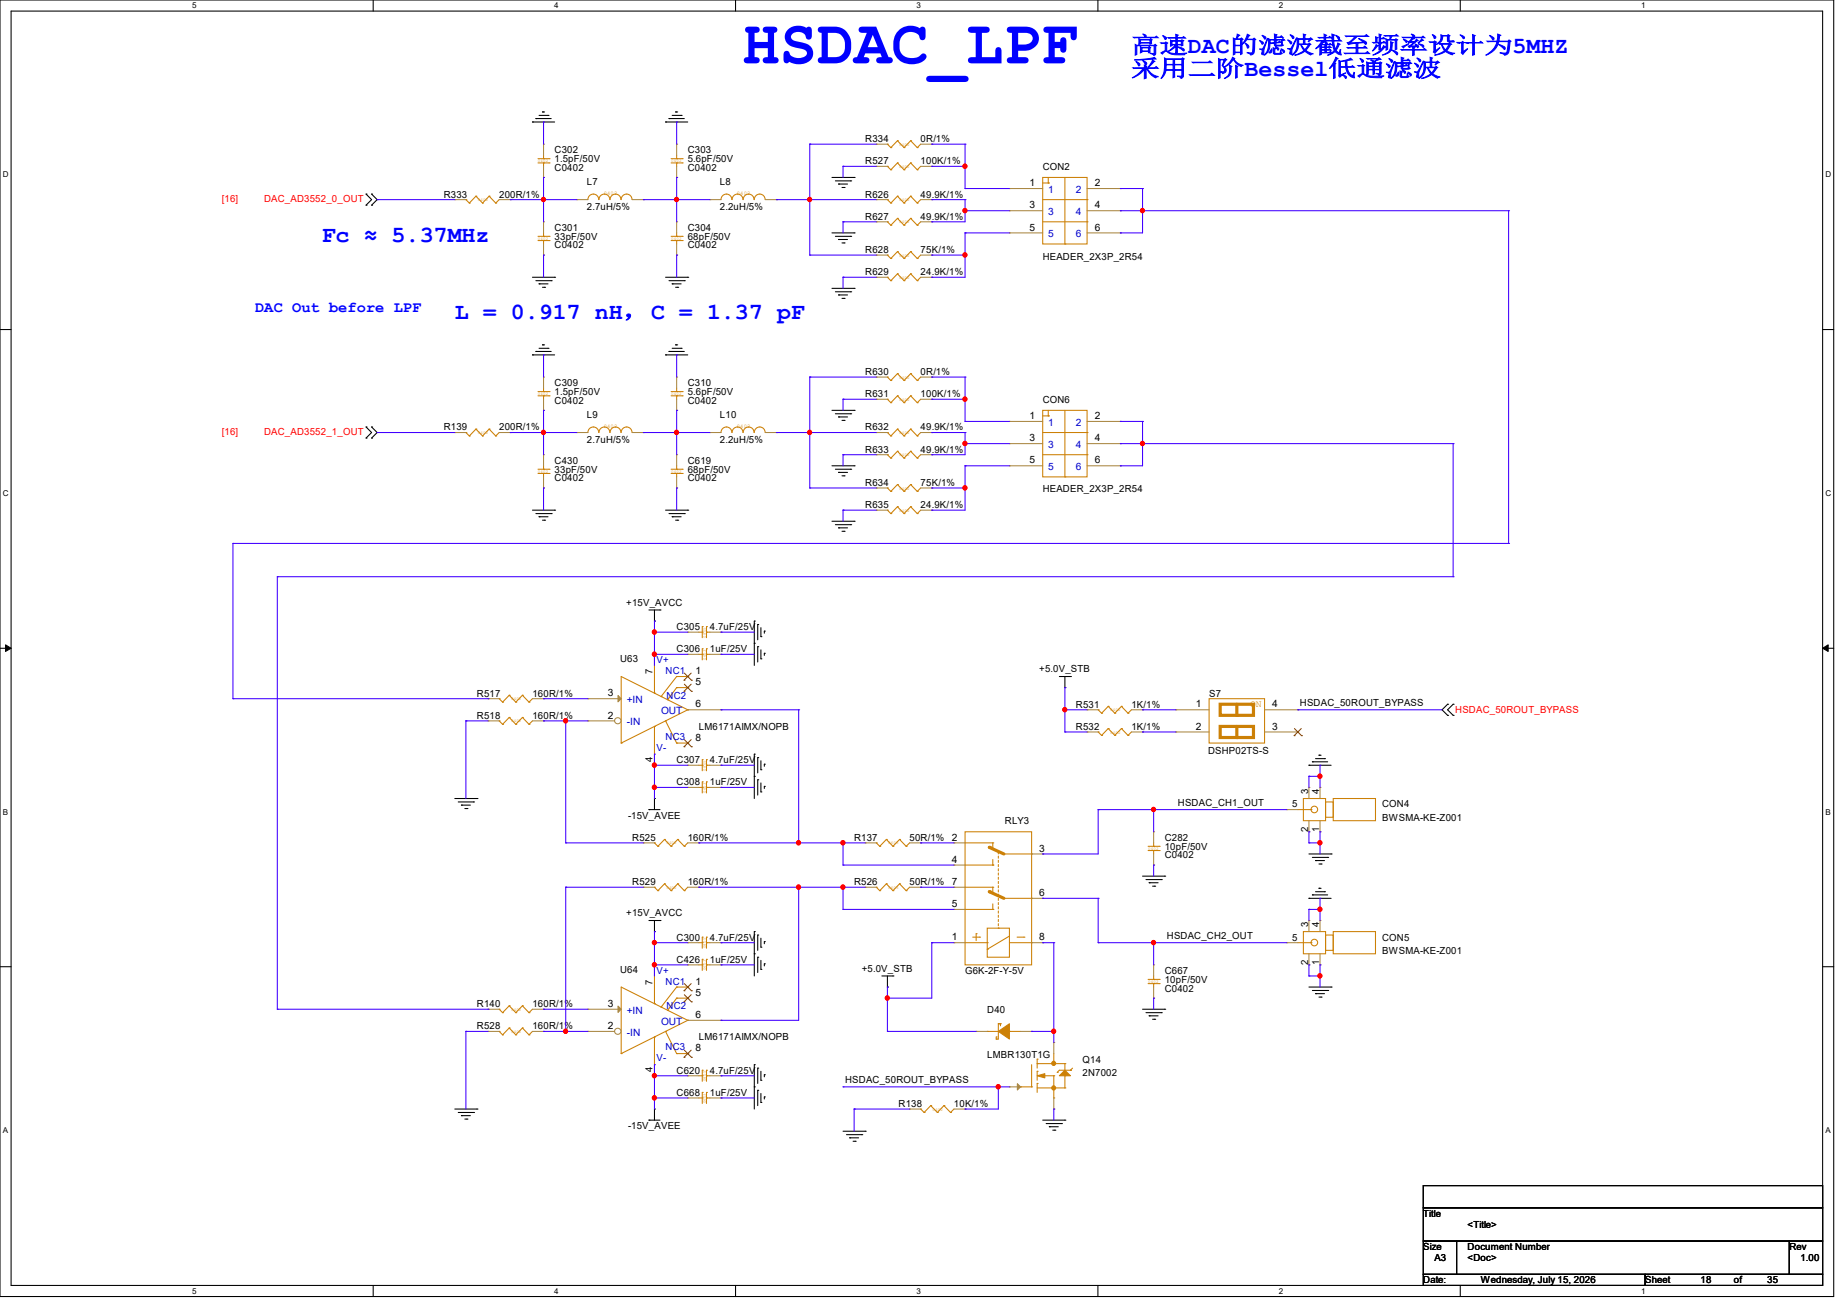
[picture p19: page 18]

DAC Out before LPF

# VADJ_AD4630

## 50R/1M端接电阻/运放/继电器

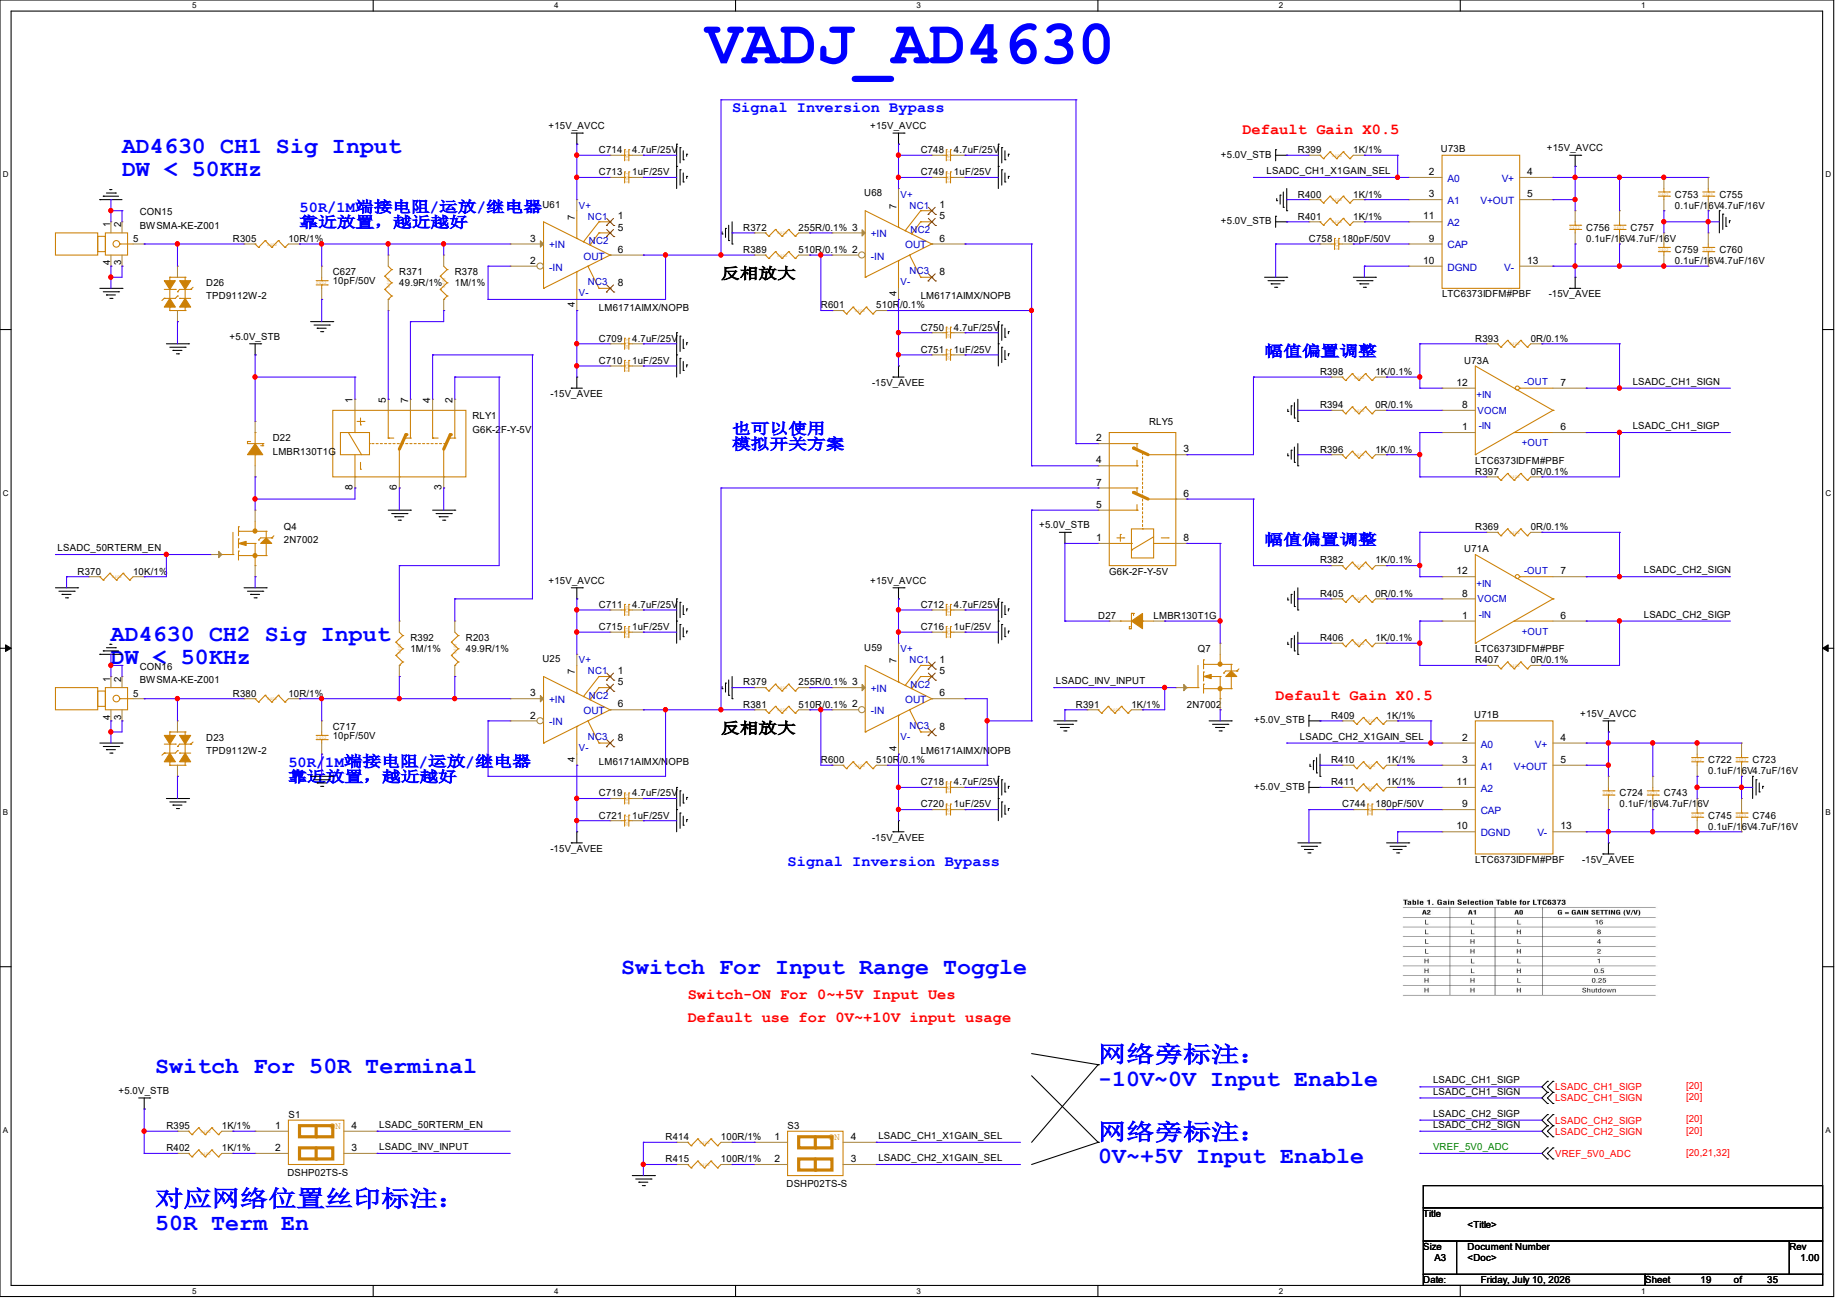
[picture p20: page 19]

Switch For Input Range Toggle

Switch-ON For 0~+5V Input Ues
Default use for 0V~+10V input usage

# AD4630_LPF

# 高速ADC截至频率设计为250KHZ

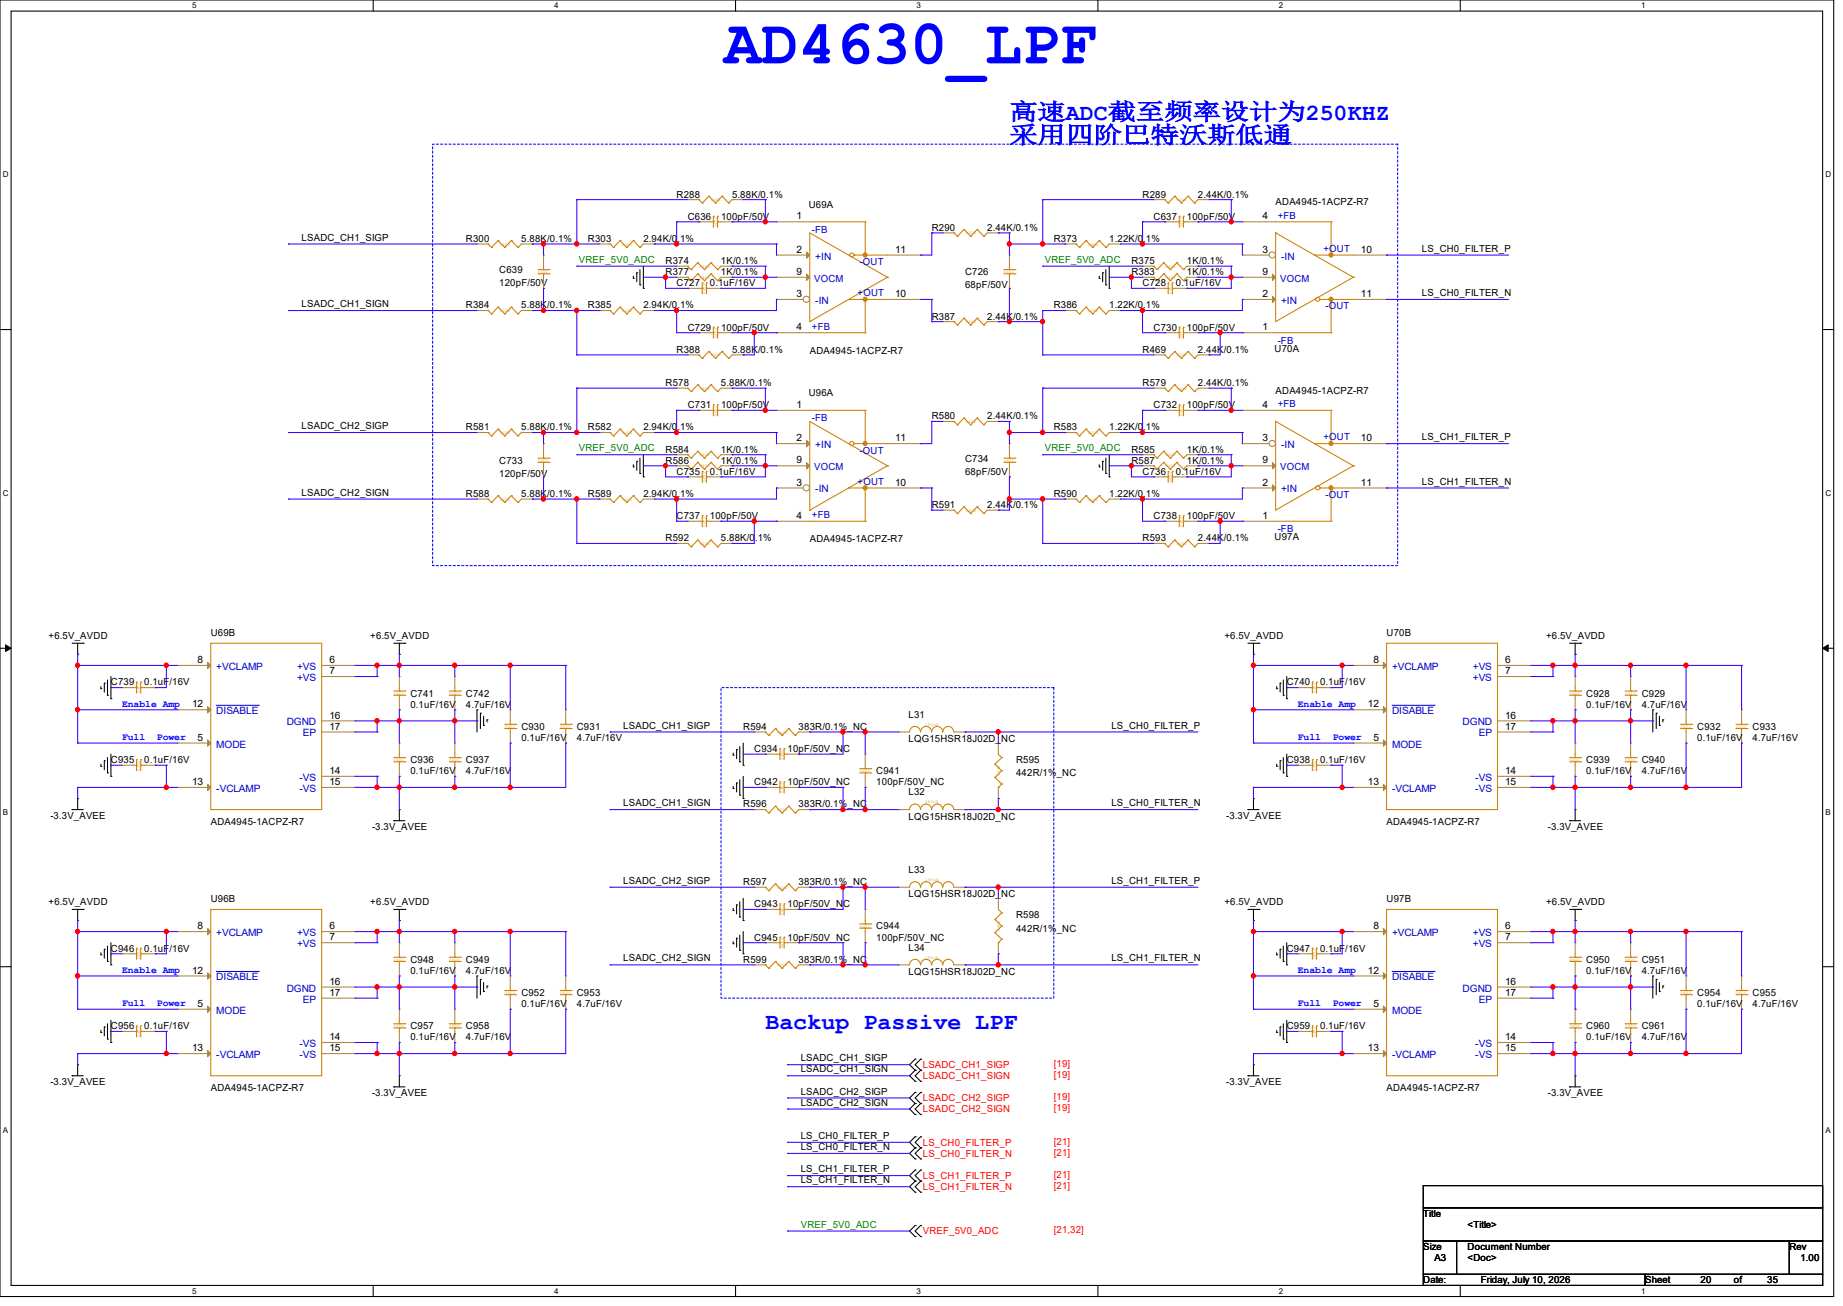
[picture p21: page 20]

## ADC_AD4630AD4630-24BBCZ（24bit，2Msps，双通道，差分输入）

## 输入电压范围：0-5V，0-10V，0- -10V，三个范围可调节（单端输入）；

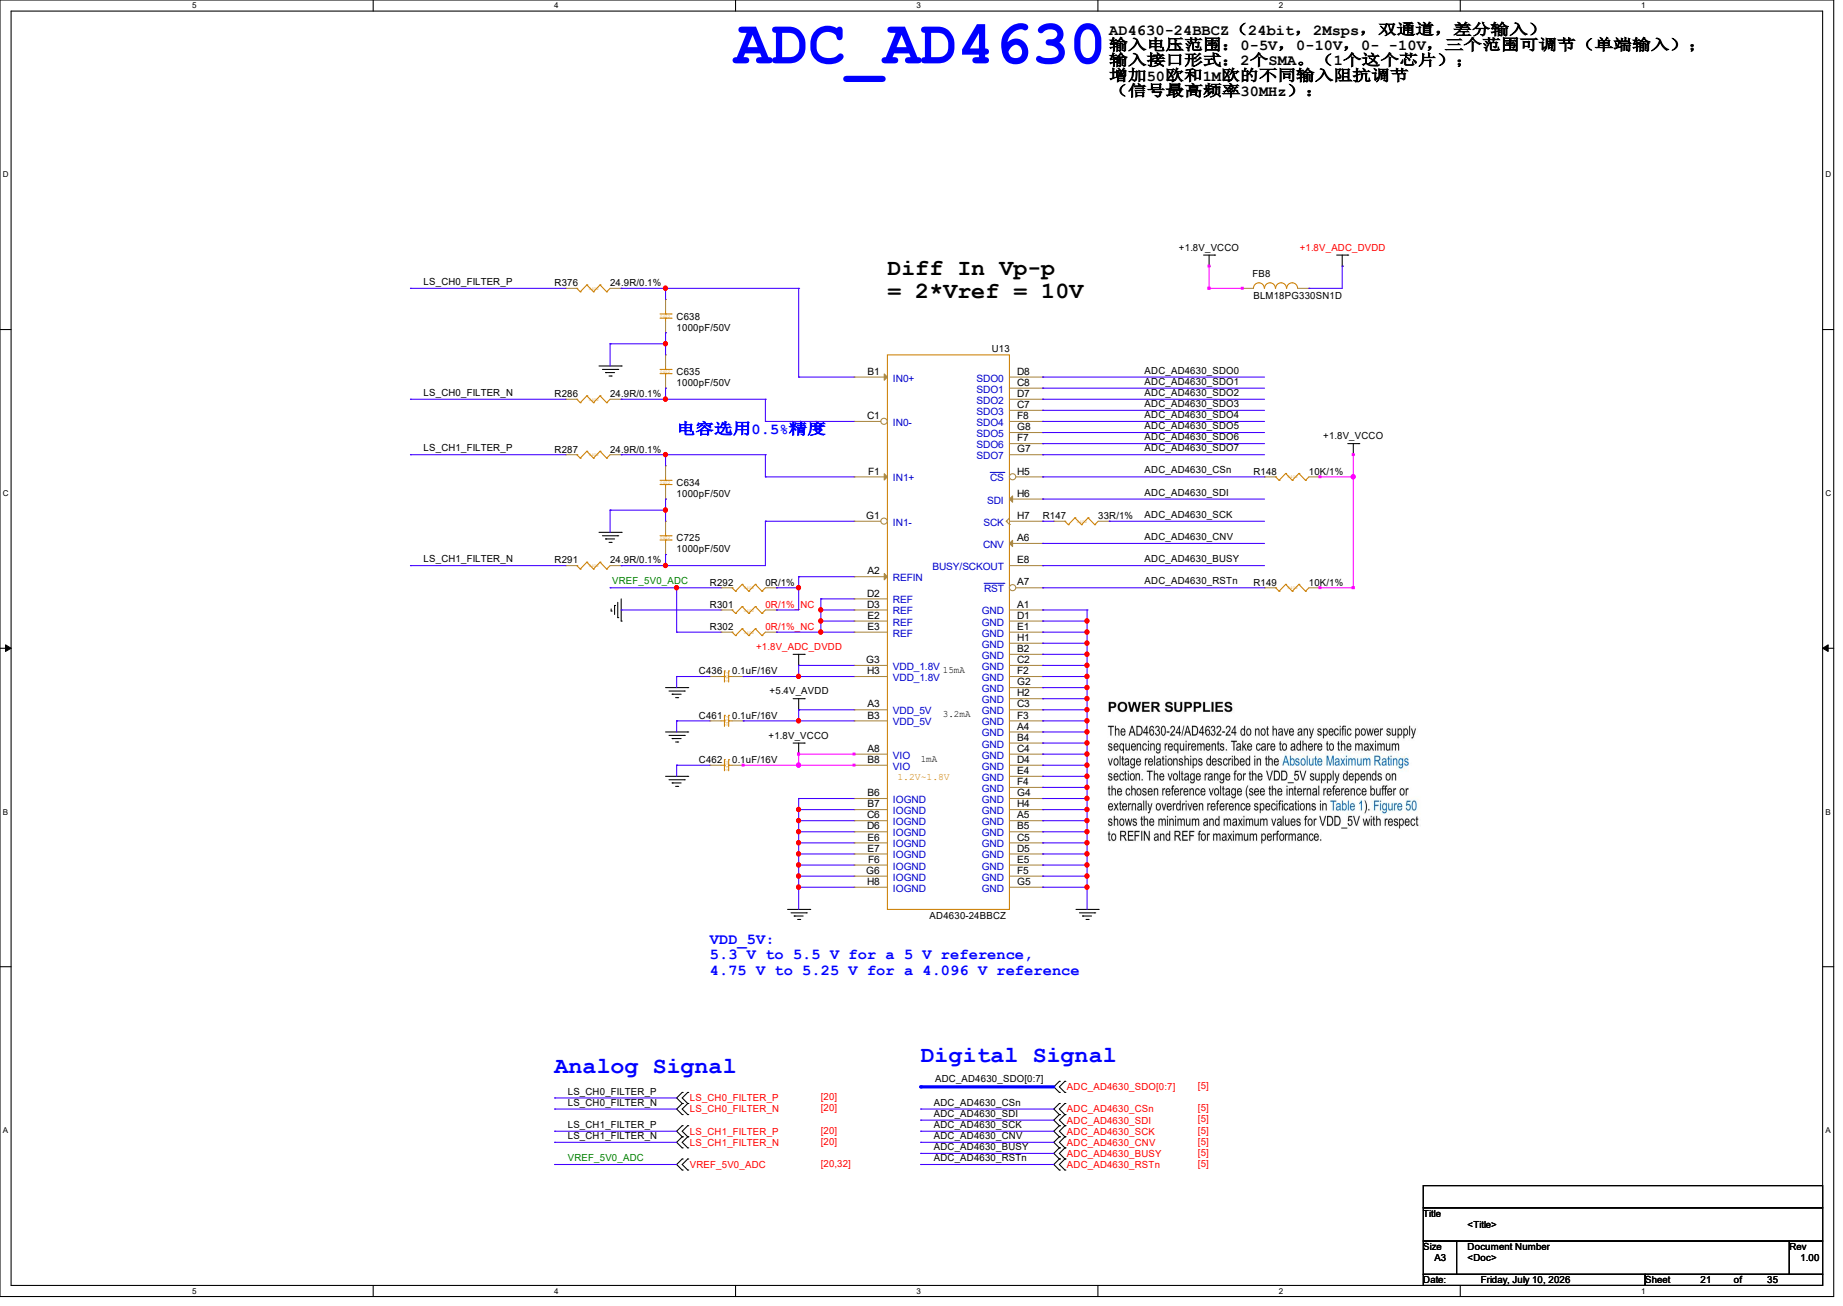
[picture p22: page 21]

Digital Signal Analog Signal

# VADJ_ADC3360

## 50R/1M端接电阻/运放/继电器

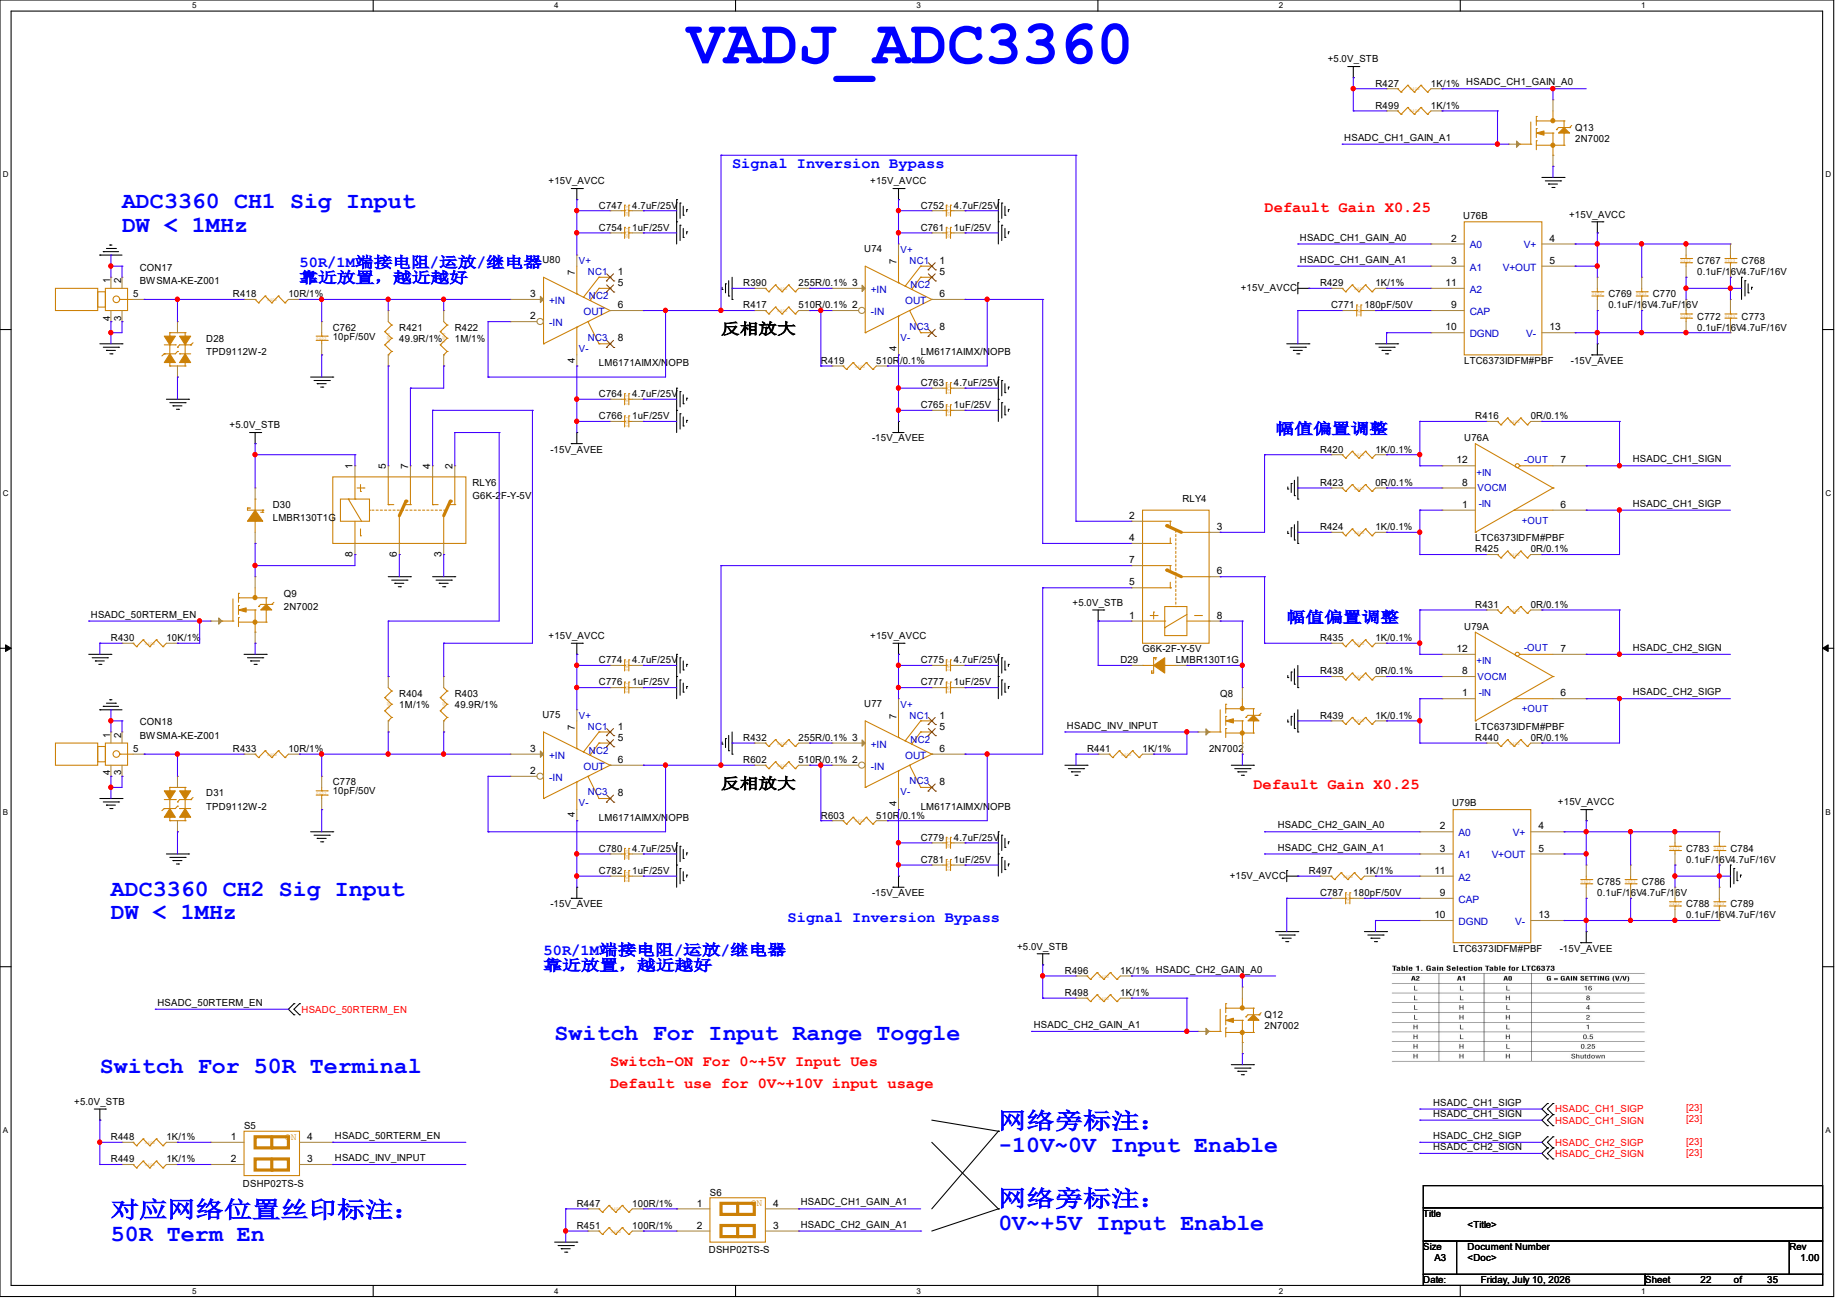
[picture p23: page 22]

Switch For Input Range Toggle

Switch-ON For 0~+5V Input Ues
Default use for 0V~+10V input usage

# ADC3660_LPF

## 差分输入电压范围需要已调整为 ±2.5V

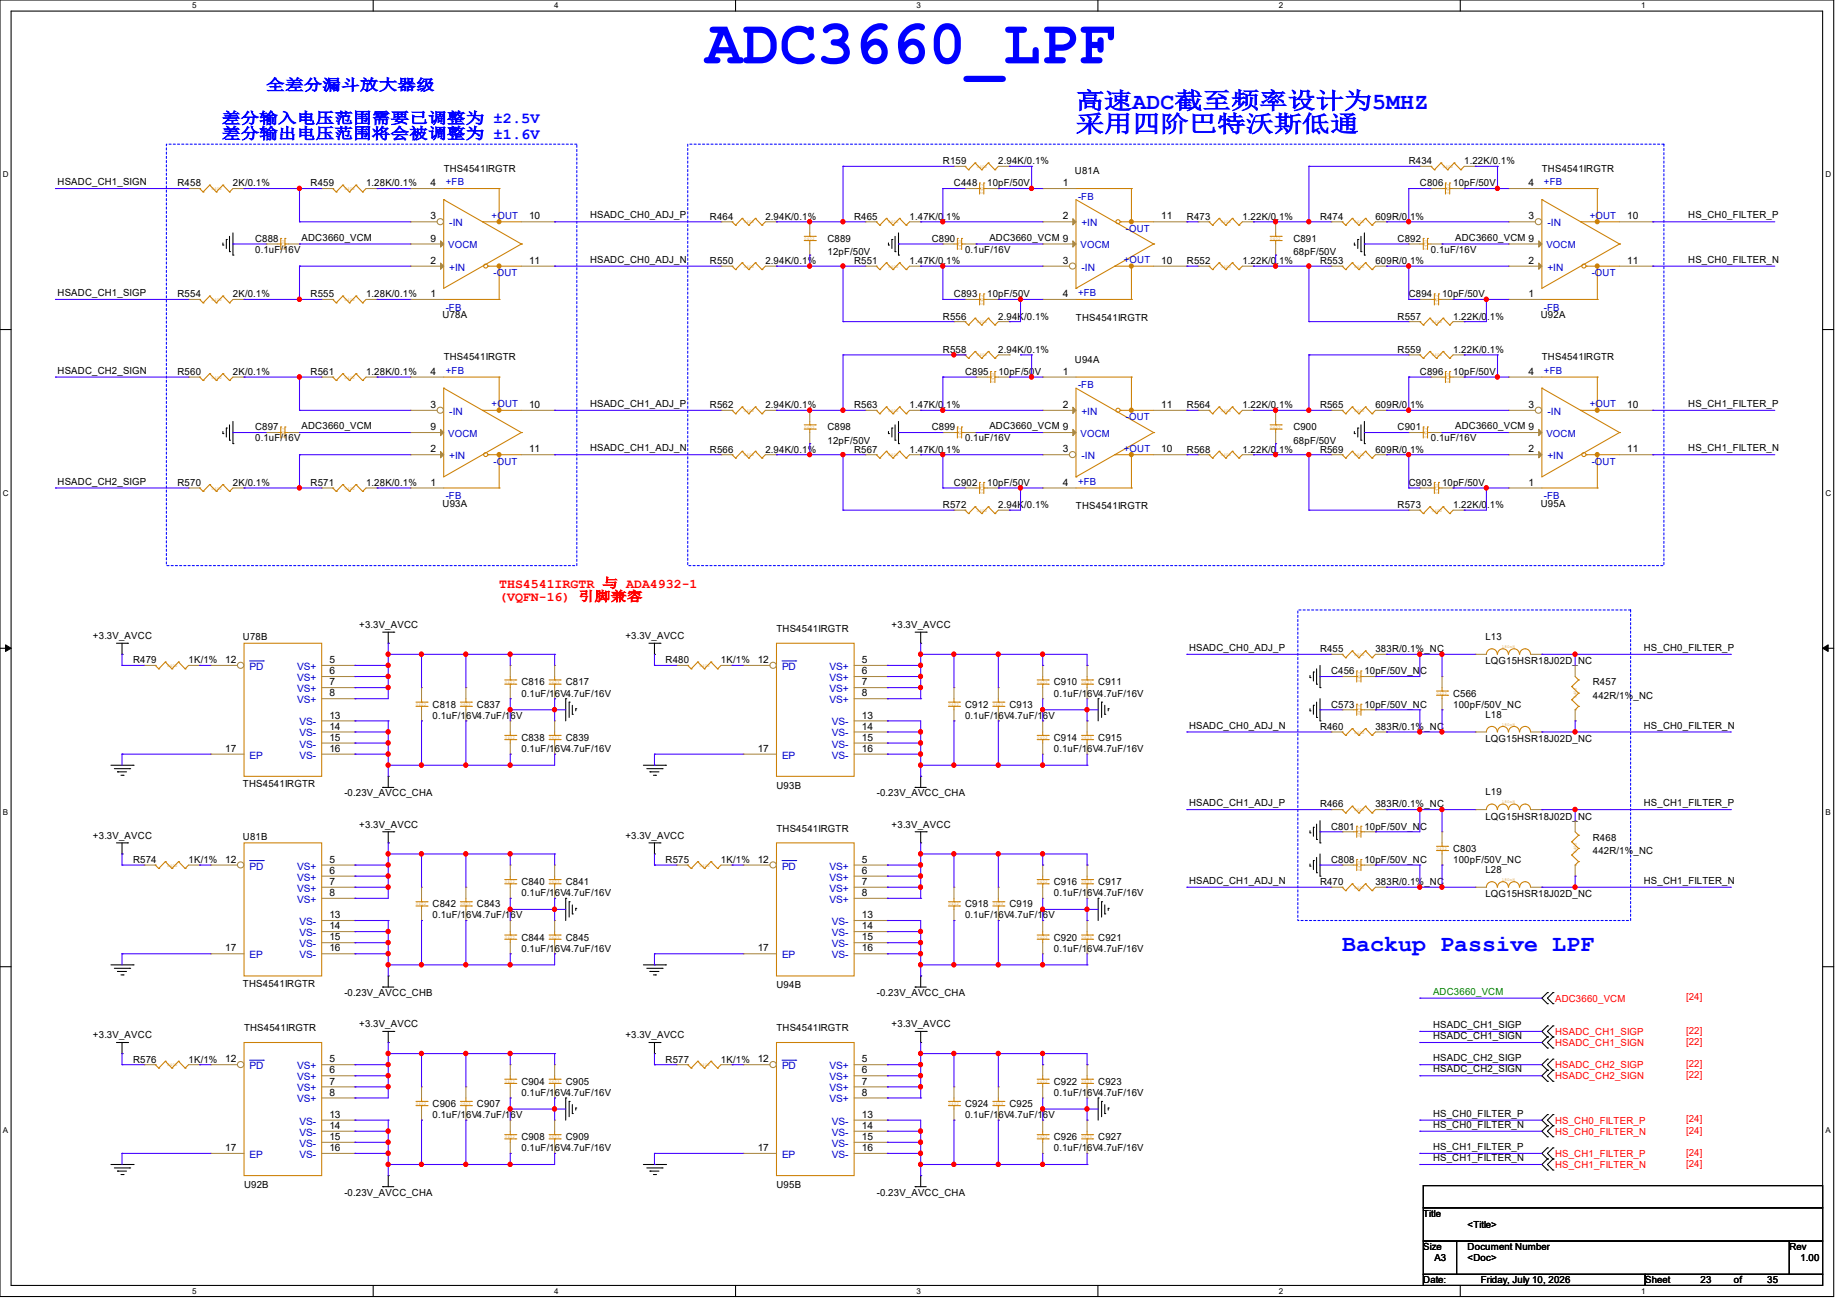
[picture p24: page 23]

## ADC_ADC3660 ADC3660IRSBT（16bit，30Msps，双通道，差分输入）

## 输入电压范围：0-5V，0-10V，0- -10V，一共三个范围可调节（单端输入）; 输入接口形式：2个SMA。（1个这个芯片）；

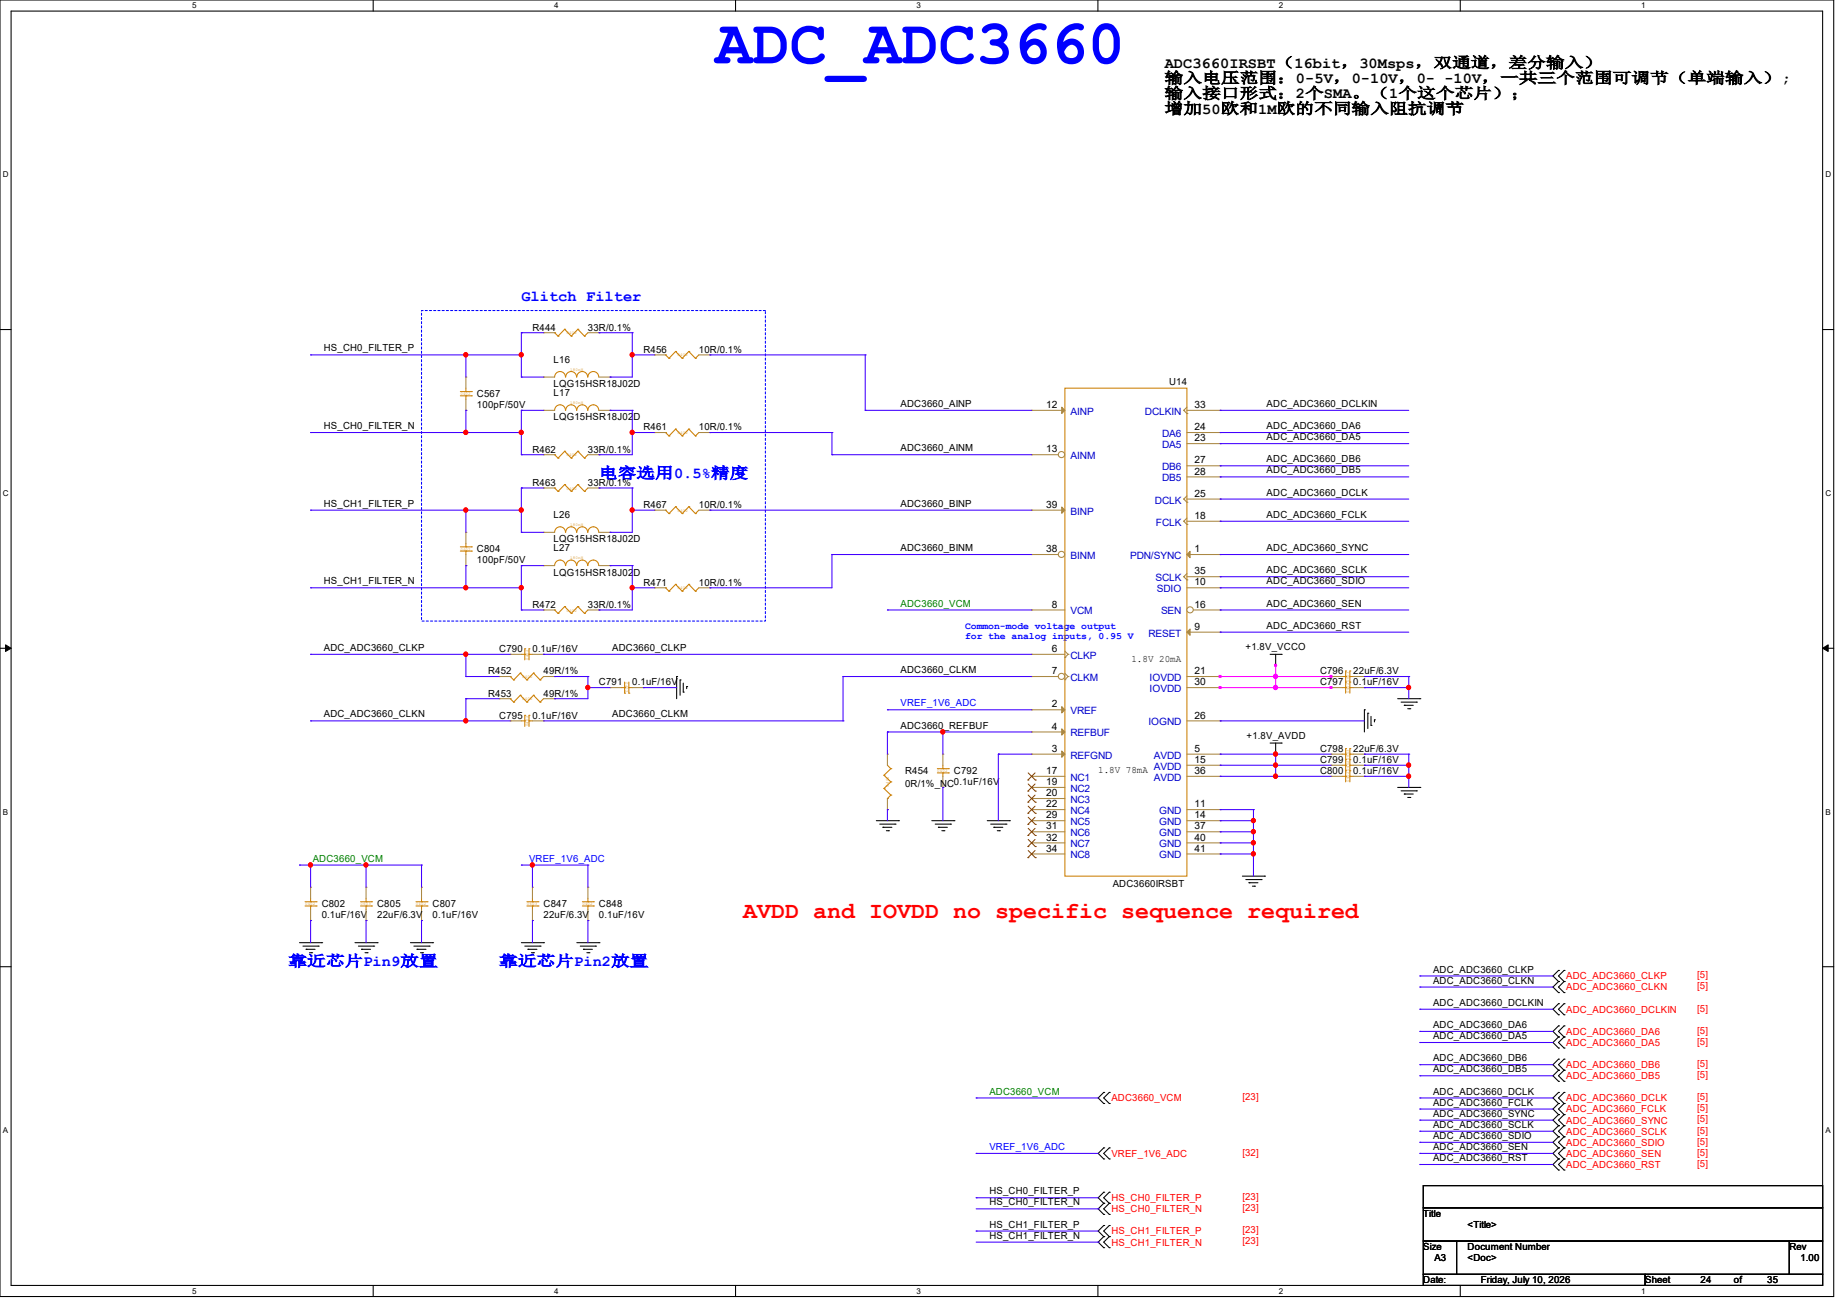
[picture p25: page 24]

Common-mode voltage output
for the analog inputs, 0.95 V

IOGND 26 AVDD 5 AVDD 15 AVDD 36 GND 11 GND 14 GND 37 GND 40 GND 41 CLKP 6 CLKM 7

AVDD and IOVDD no specific sequence required

# CLK_OSC

# LVDS Diff Clk: 156.25MHz

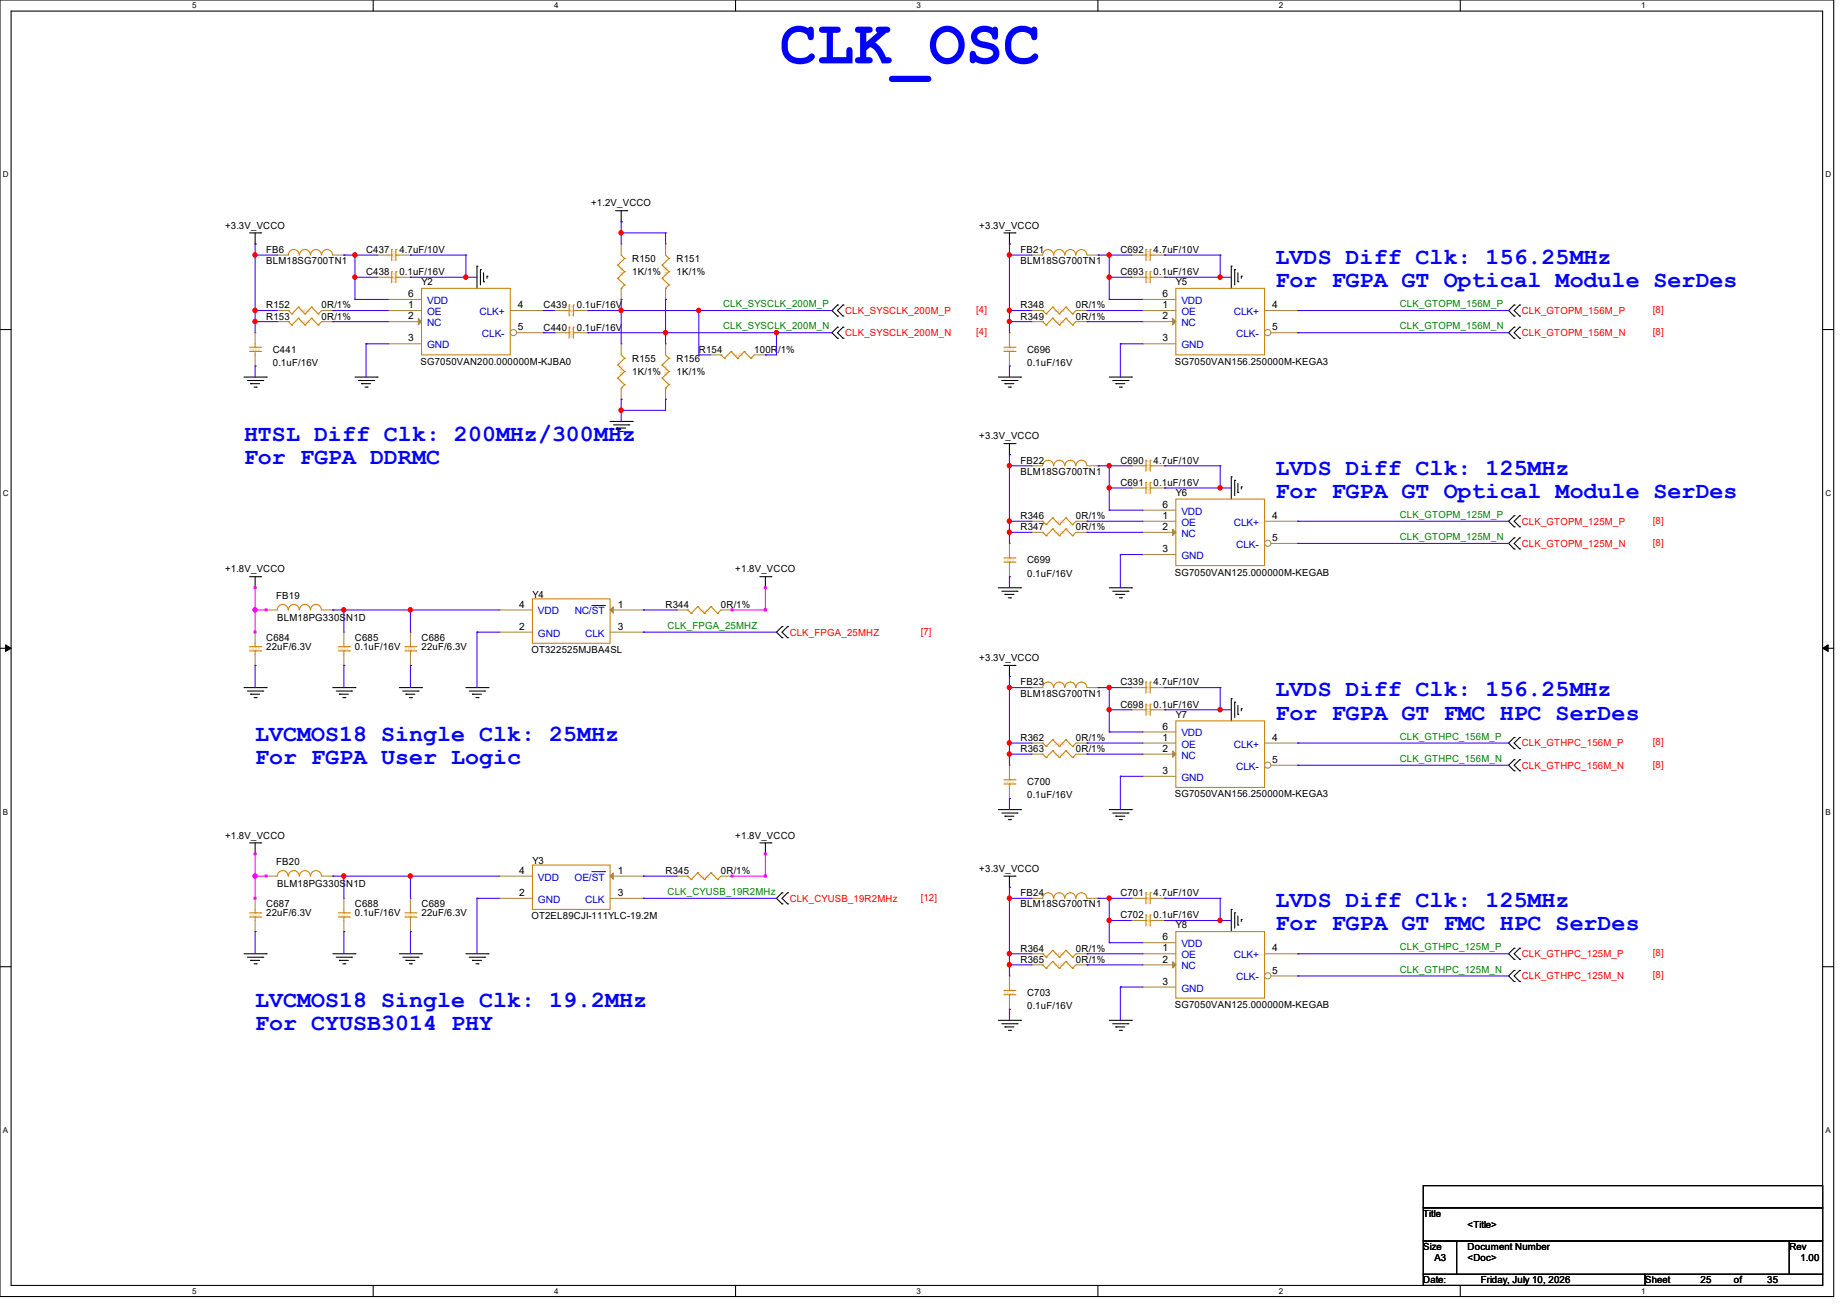
[picture p26: page 25]

For FGPA GT Optical Module SerDes

Y5 SG7050VAN156.250000M-KEGA3 CLK+ 4 CLK- 5 GND 3 OE 1 NC 2 VDD 6

LVDS Diff Clk: 125MHz

LVDS Diff Clk: 156.25MHz
For FGPA GT FMC HPC SerDes

Y7 SG7050VAN156.250000M-KEGA3 CLK+ 4 CLK- 5 GND 3 OE 1 NC 2 VDD 6

LVCMOS18 Single Clk: 25MHz
For FGPA User Logic

## 二极管靠近芯片放置

# Power In Port

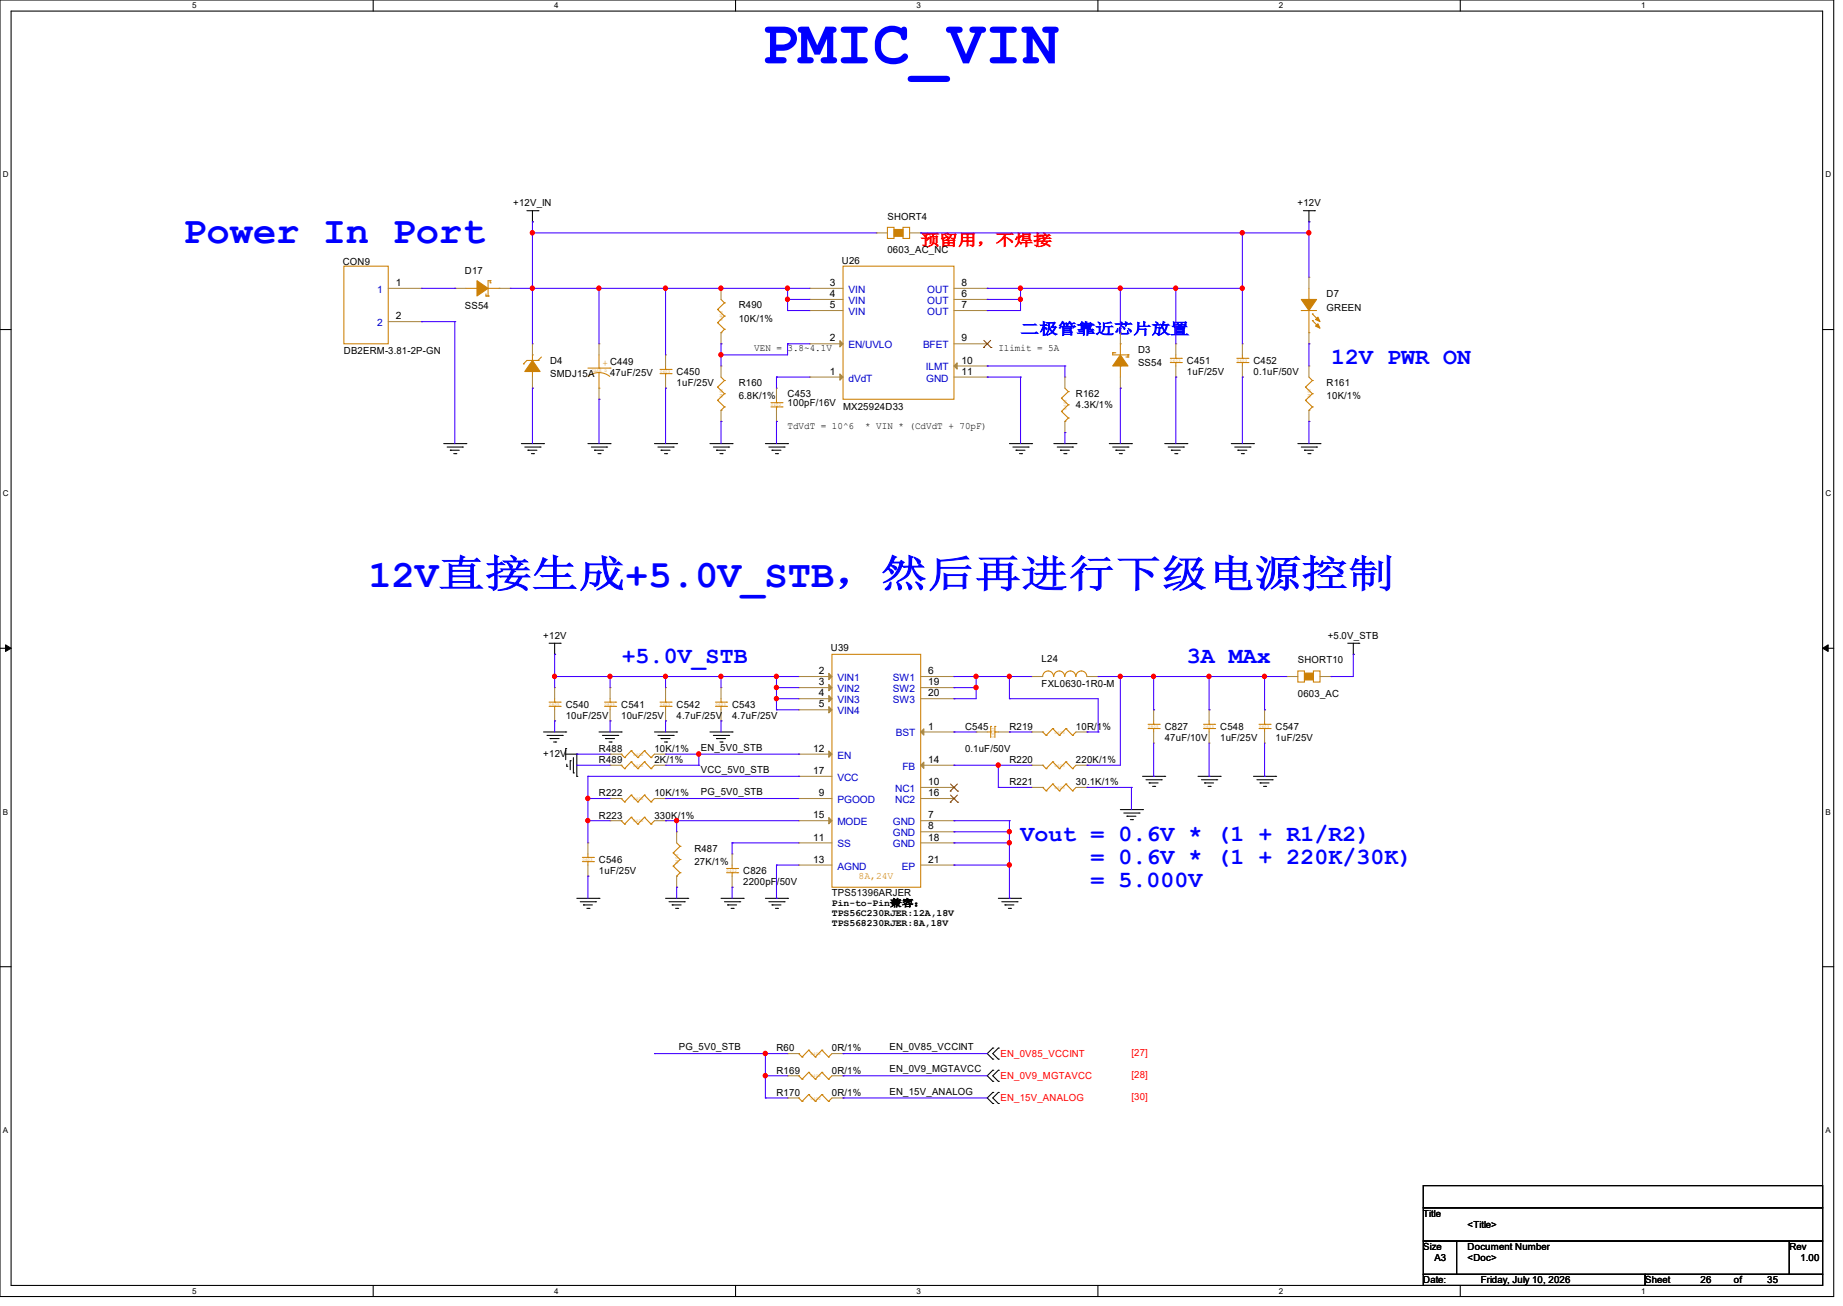
[picture p27: page 26]

预留用，不焊接 TdVdT = 10^6 * VIN * (CdVdT + 70pF)

# PMIC_VCCINT&AUX

0.85V @36A

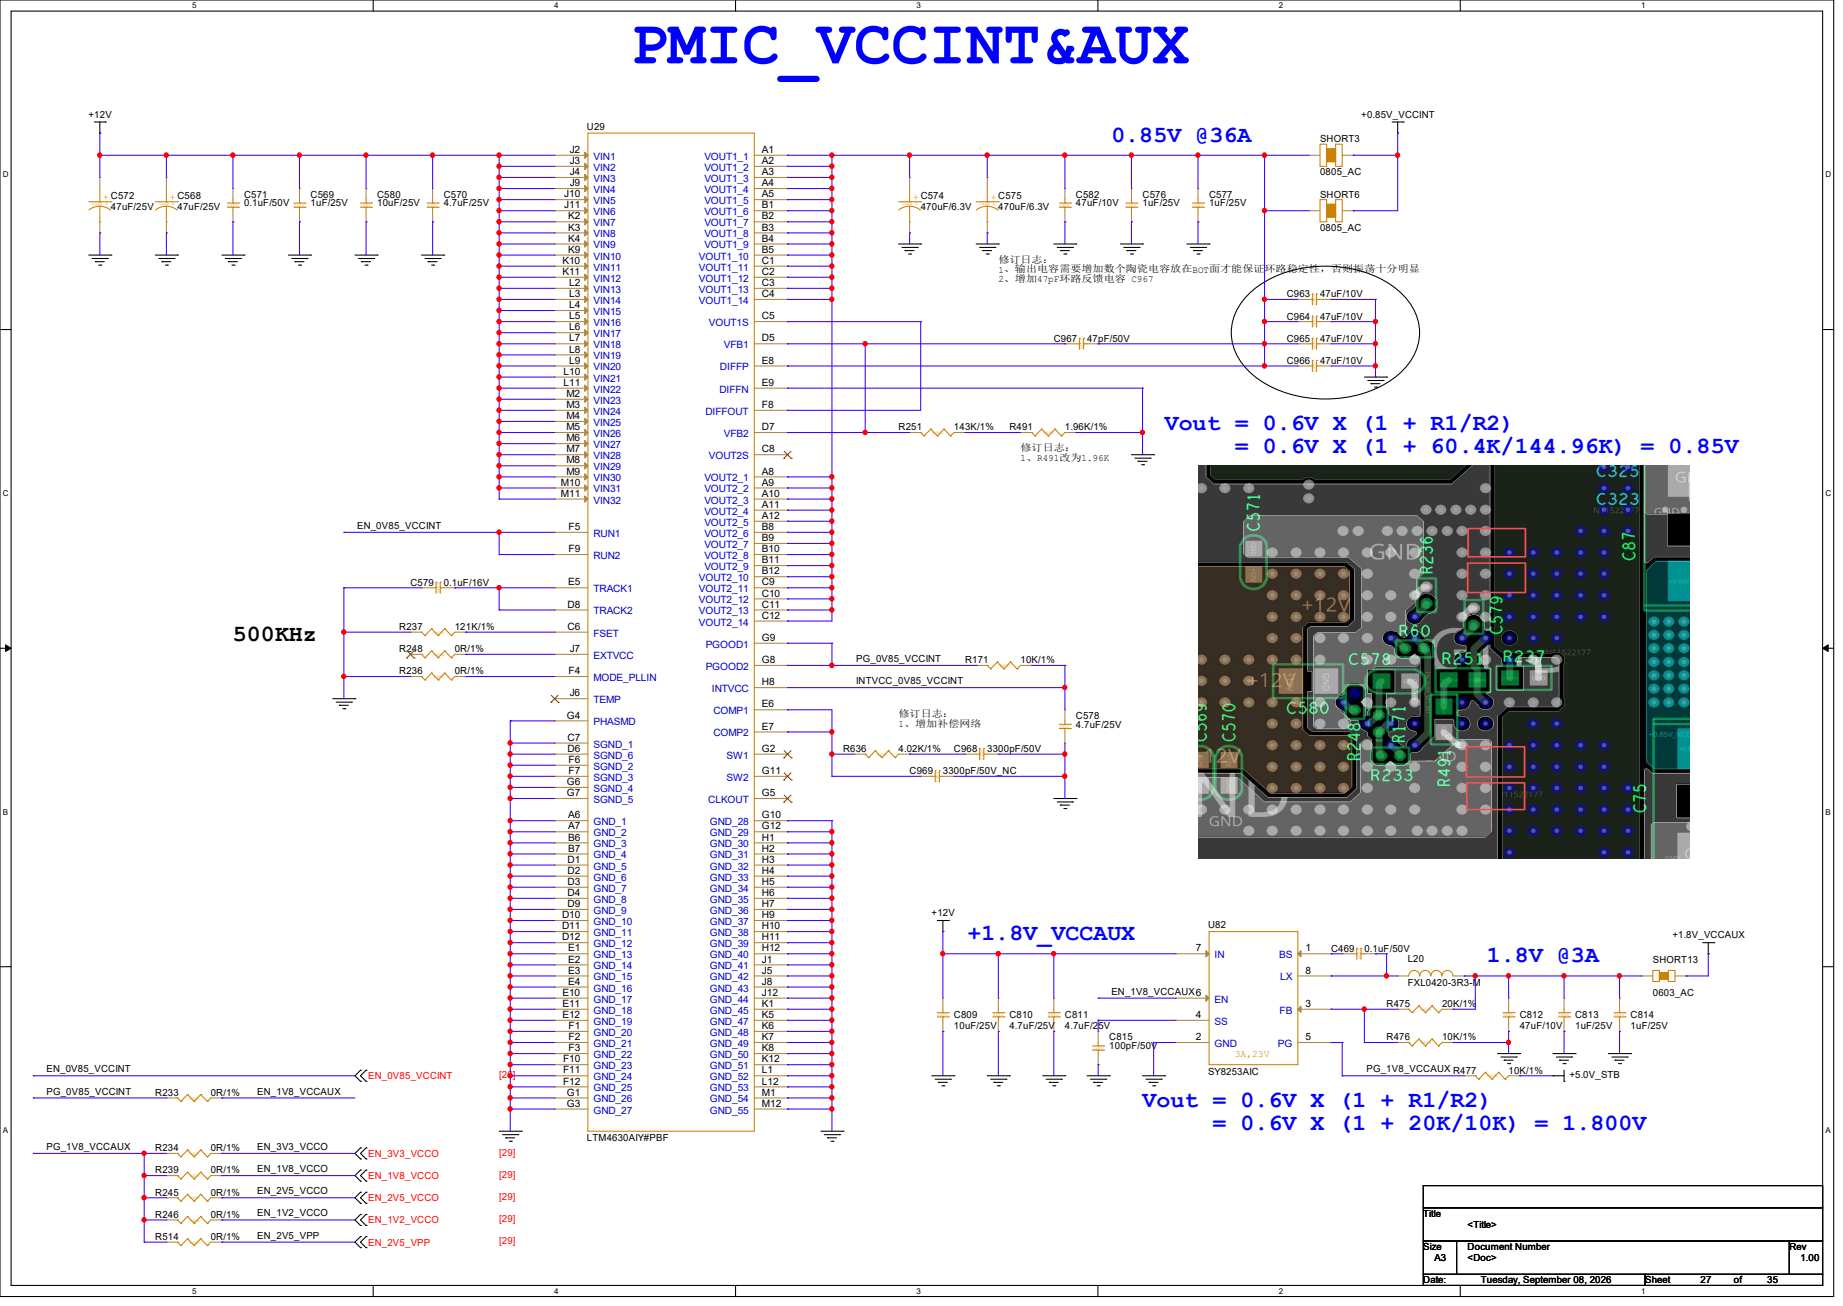
[picture p28: page 27]

# PMIC_FGPA_MGT

# +0.9V_MGTAVCC

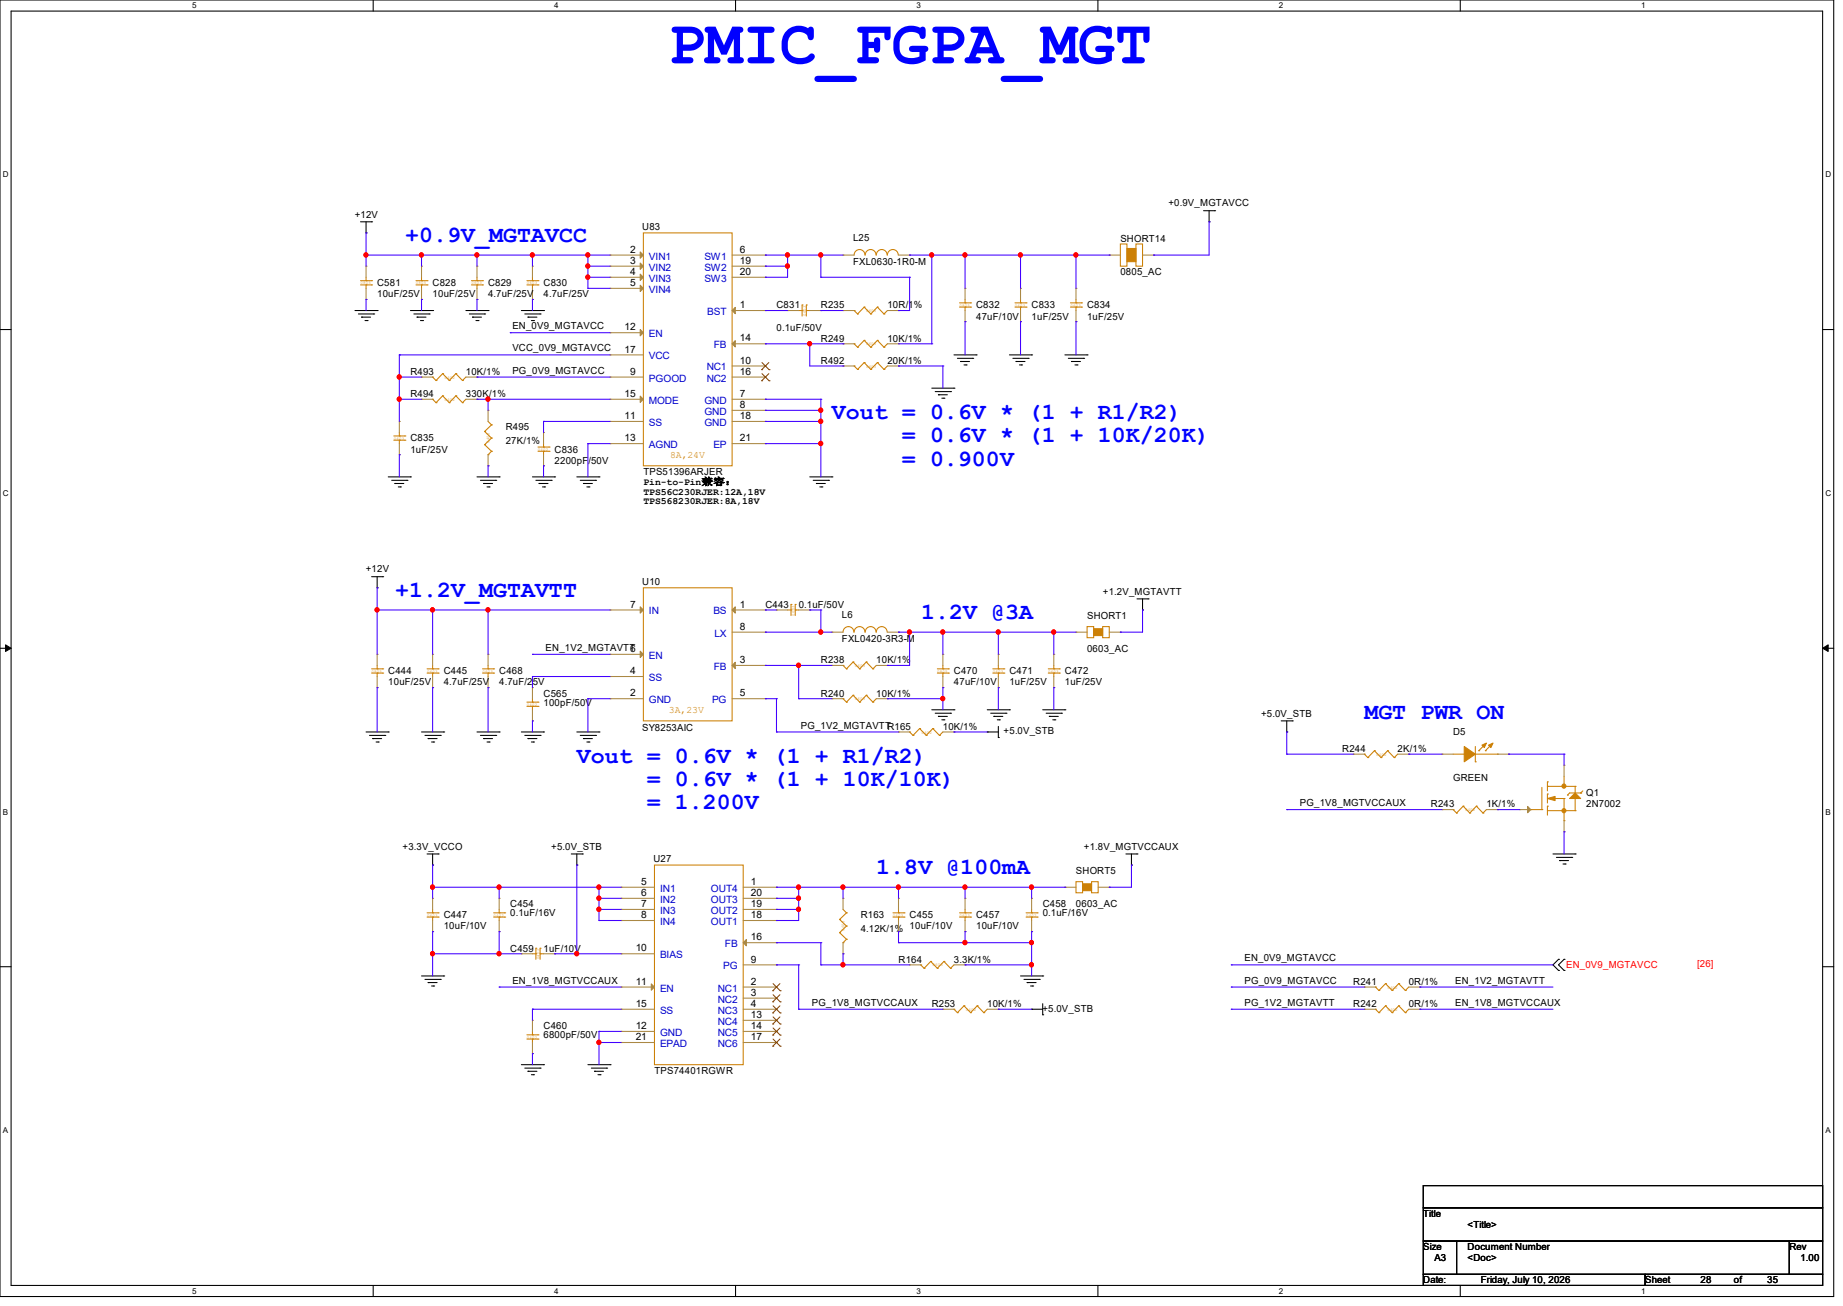
[picture p29: page 28]

# PMIC_VCCO

# +2.5V_VCCO

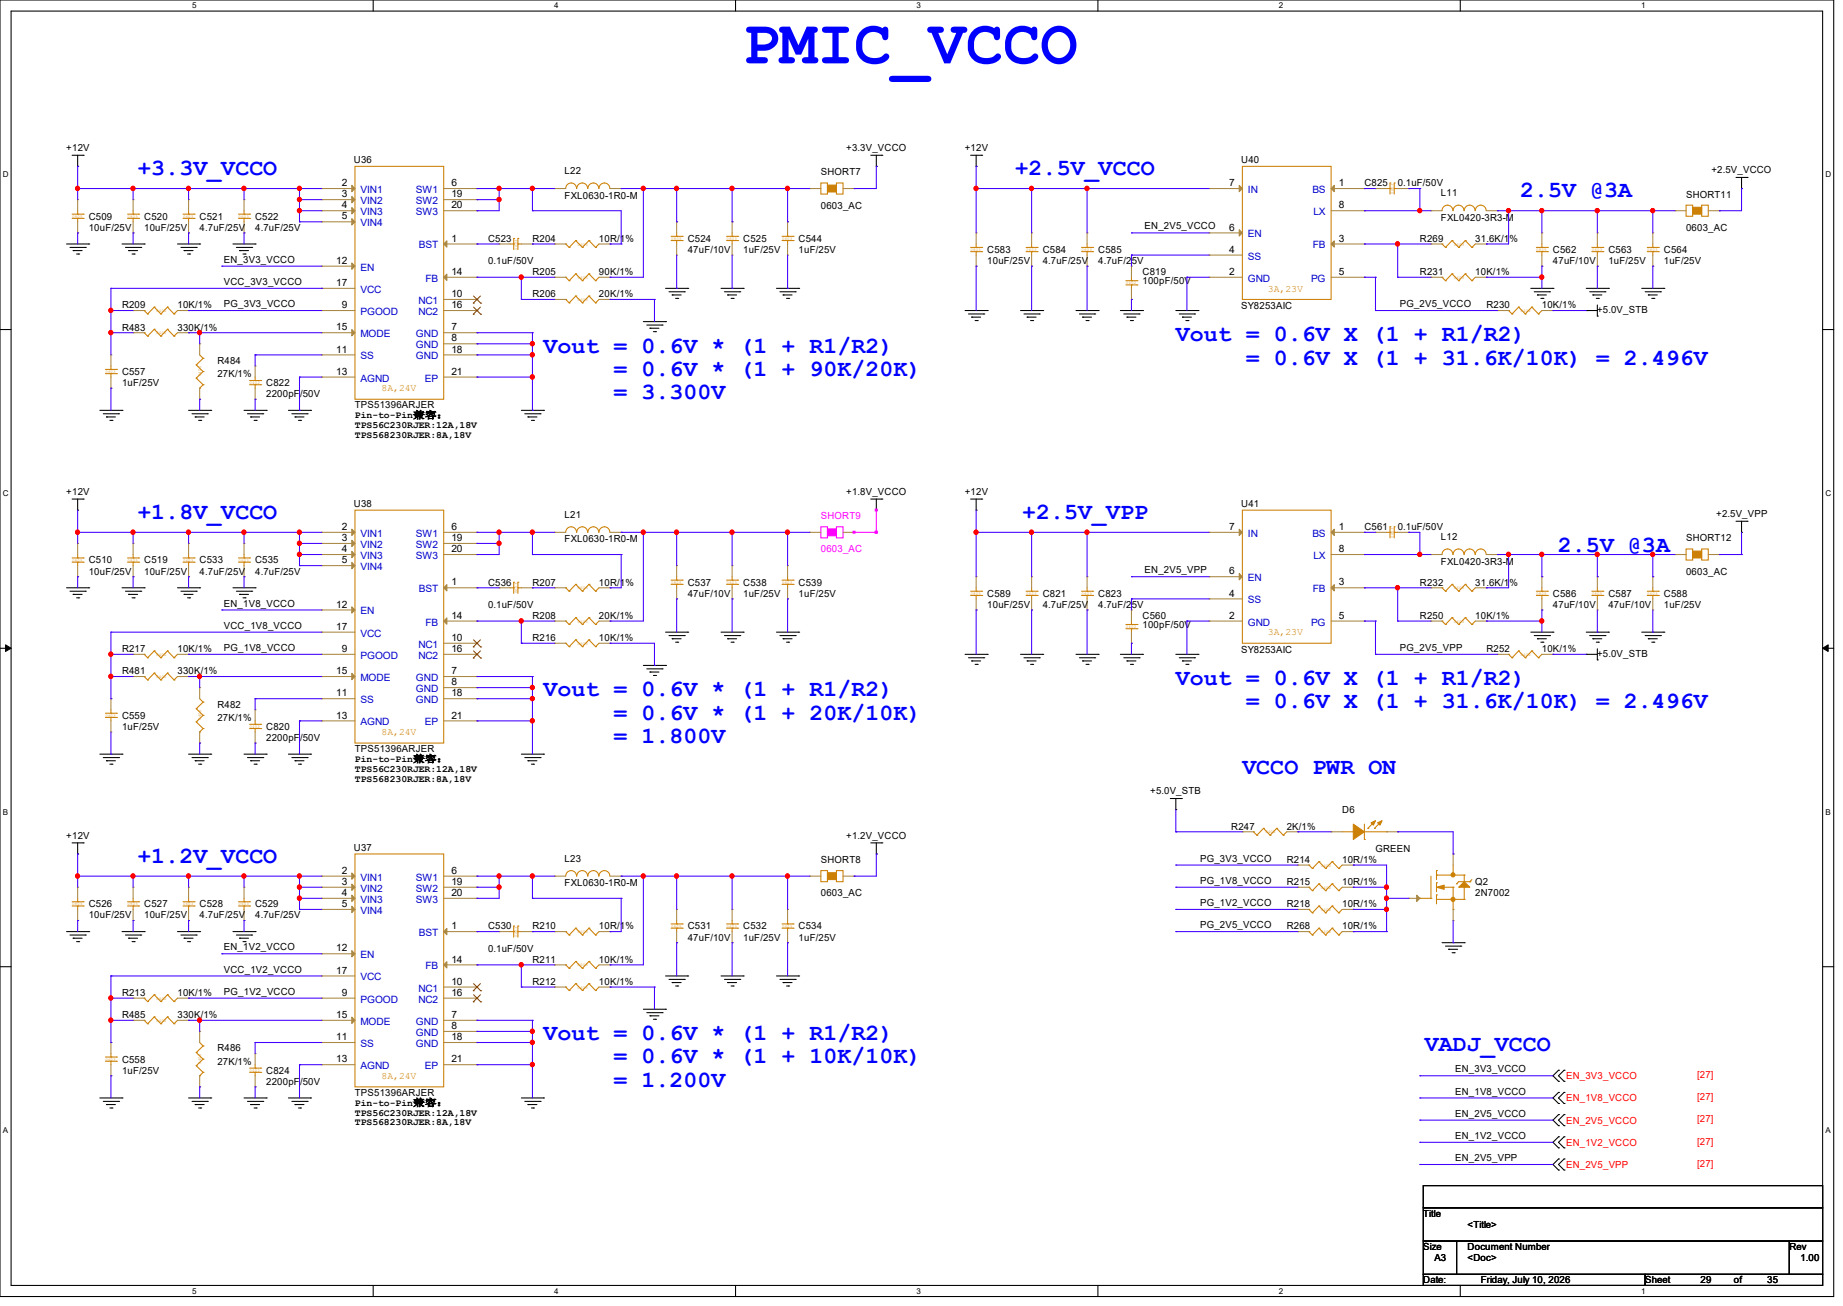
[picture p30: page 29]

# PMIC_ANALOG

## 确认DCDC输出电源正常之后焊接

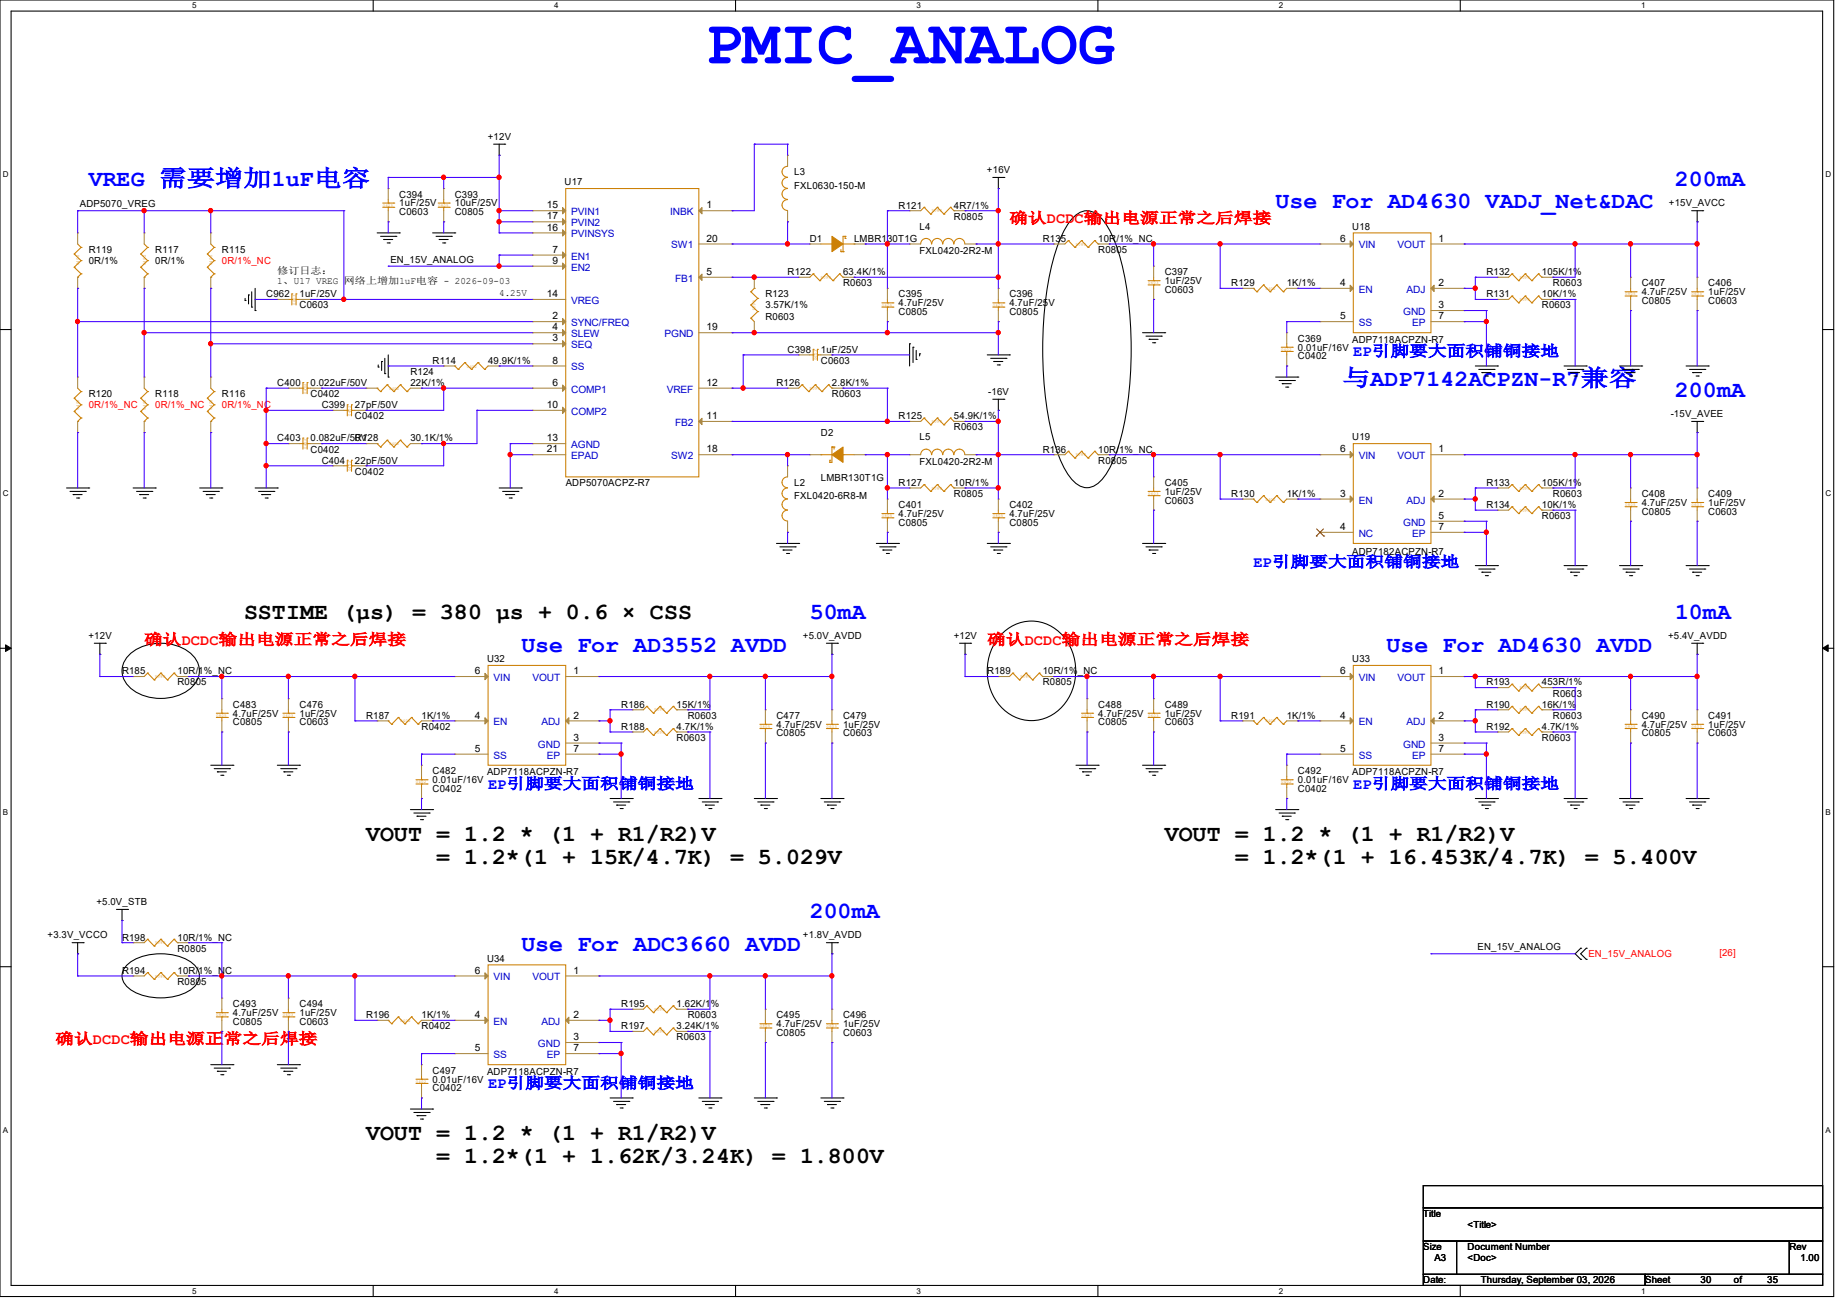
[picture p31: page 30]

SSTIME (μs) = 380 μs + 0.6 × CSS

# PMIC_AMP

# +3.3V_AVCC

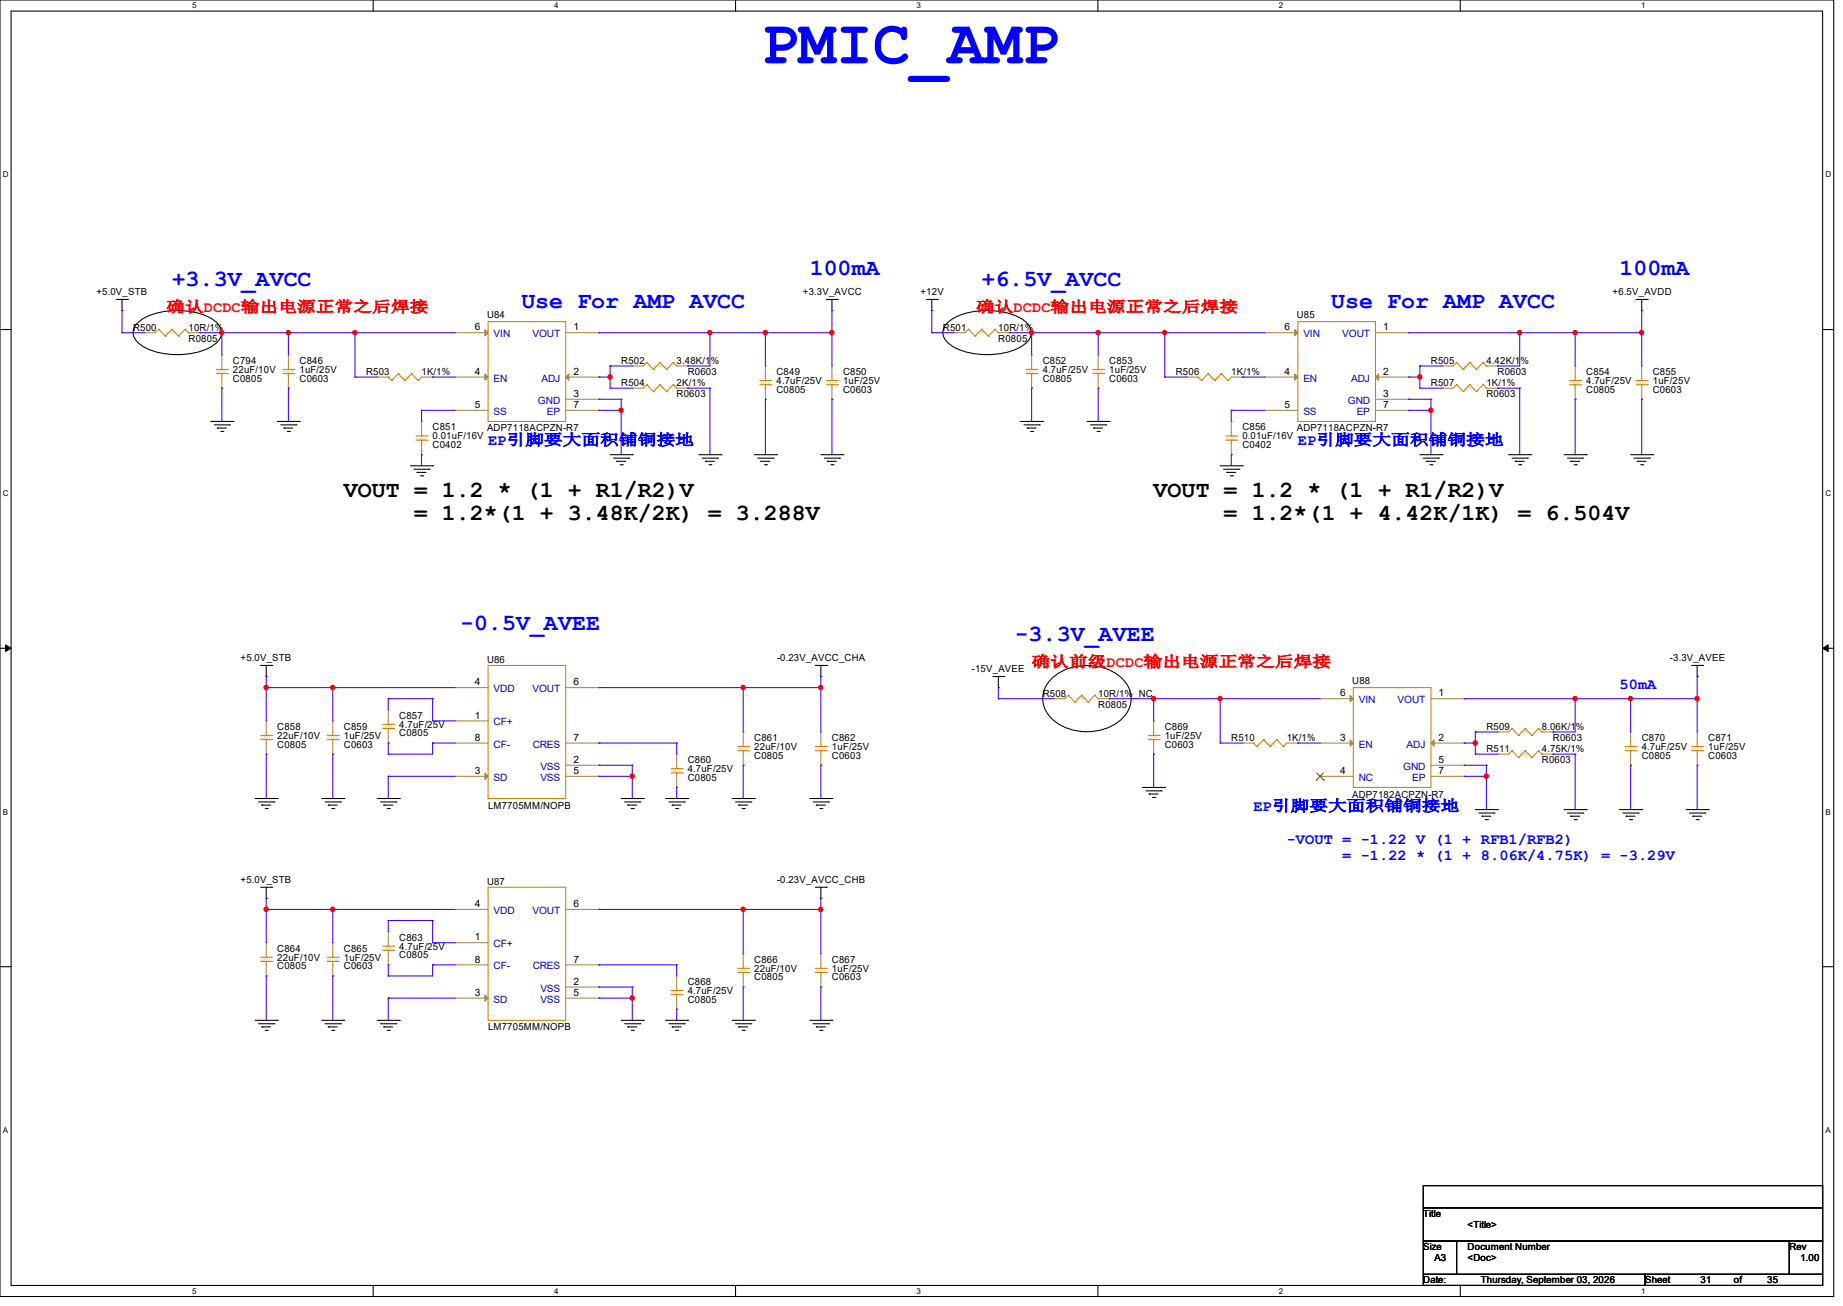
[picture p32: page 31]

Use For AMP AVCC

# PMIC_VREF

# Vref For AD3552

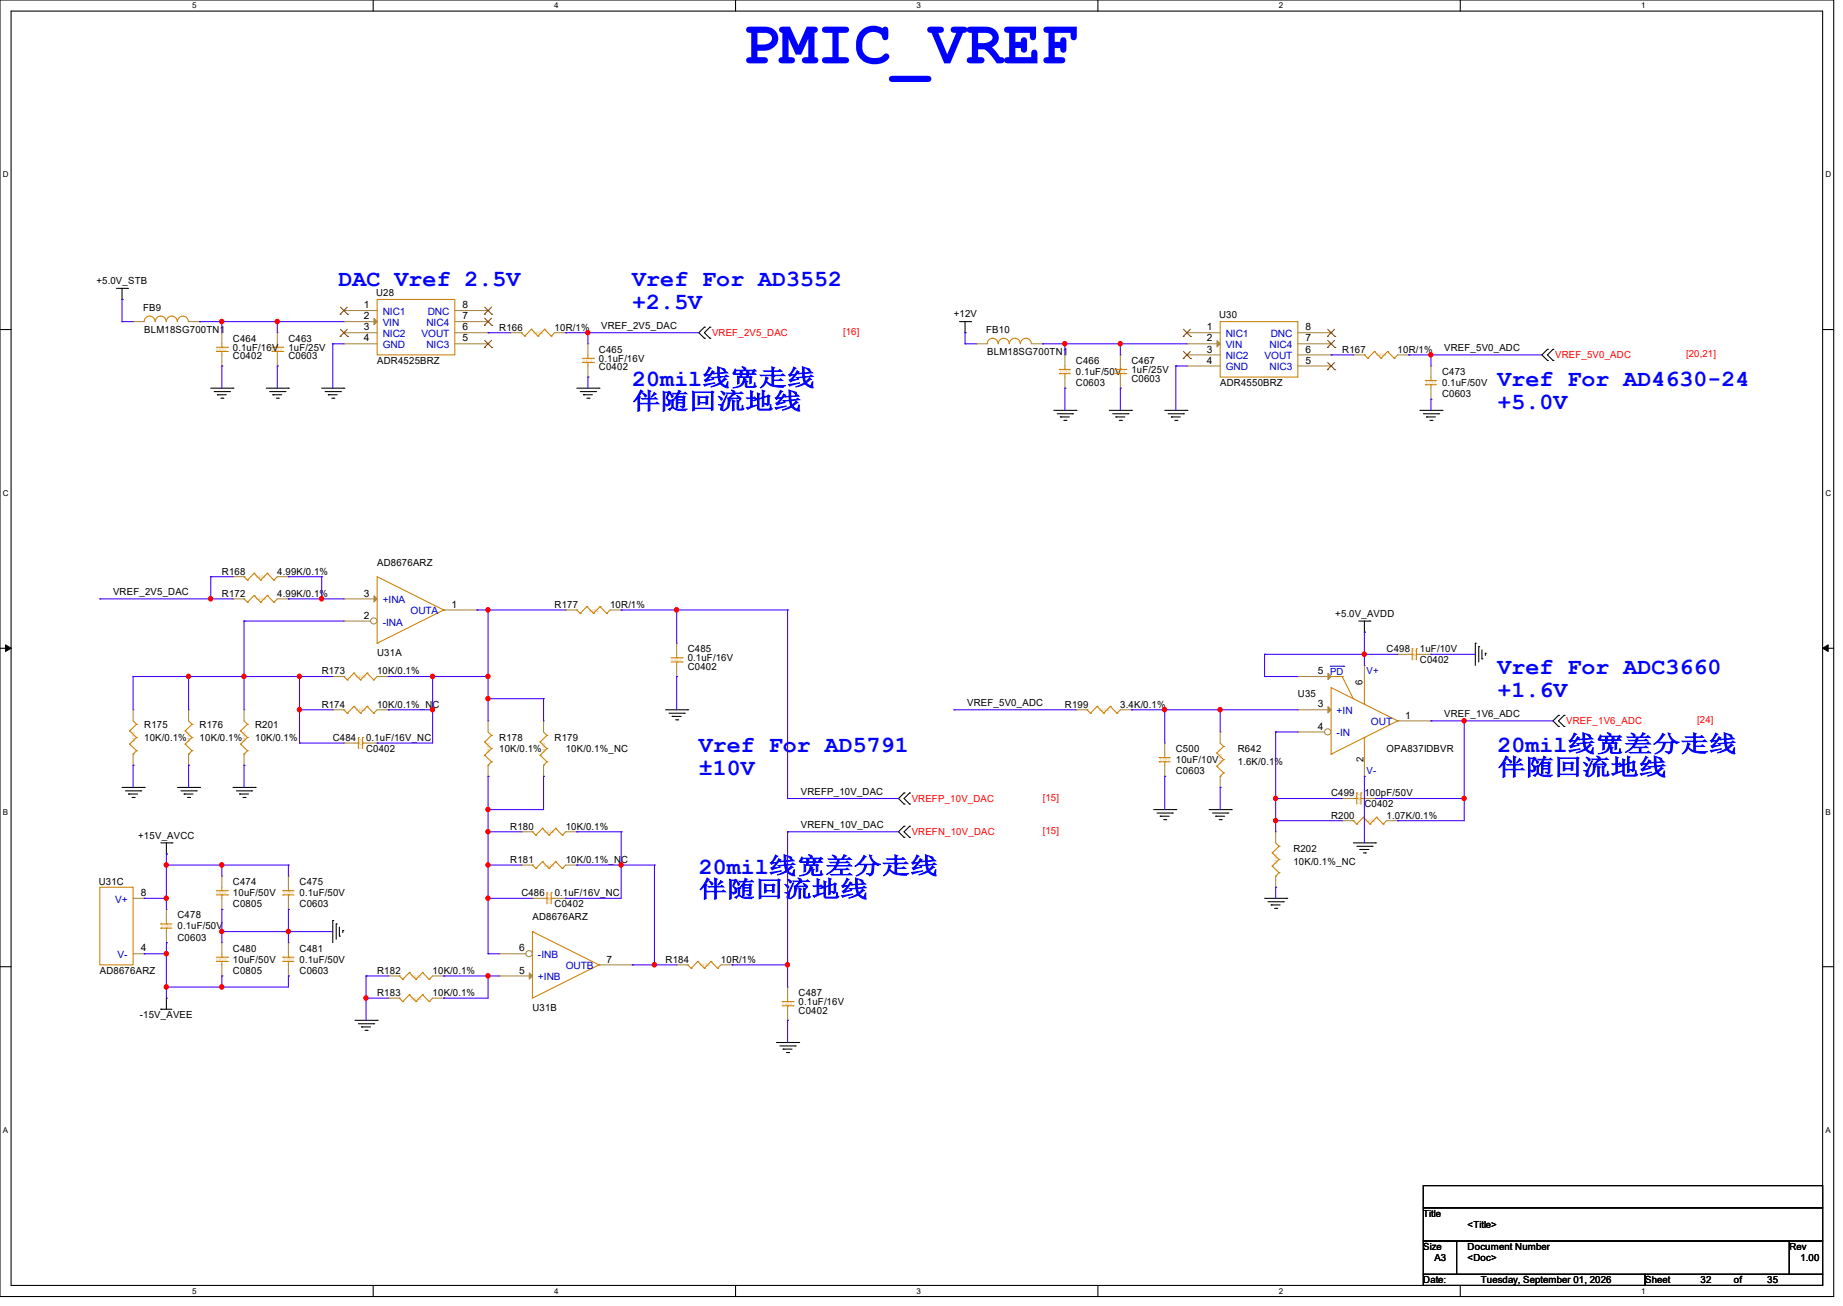
[picture p33: page 32]

# CON_FMC_HPC 参考ZCU102 HPC0

# GT SerDes

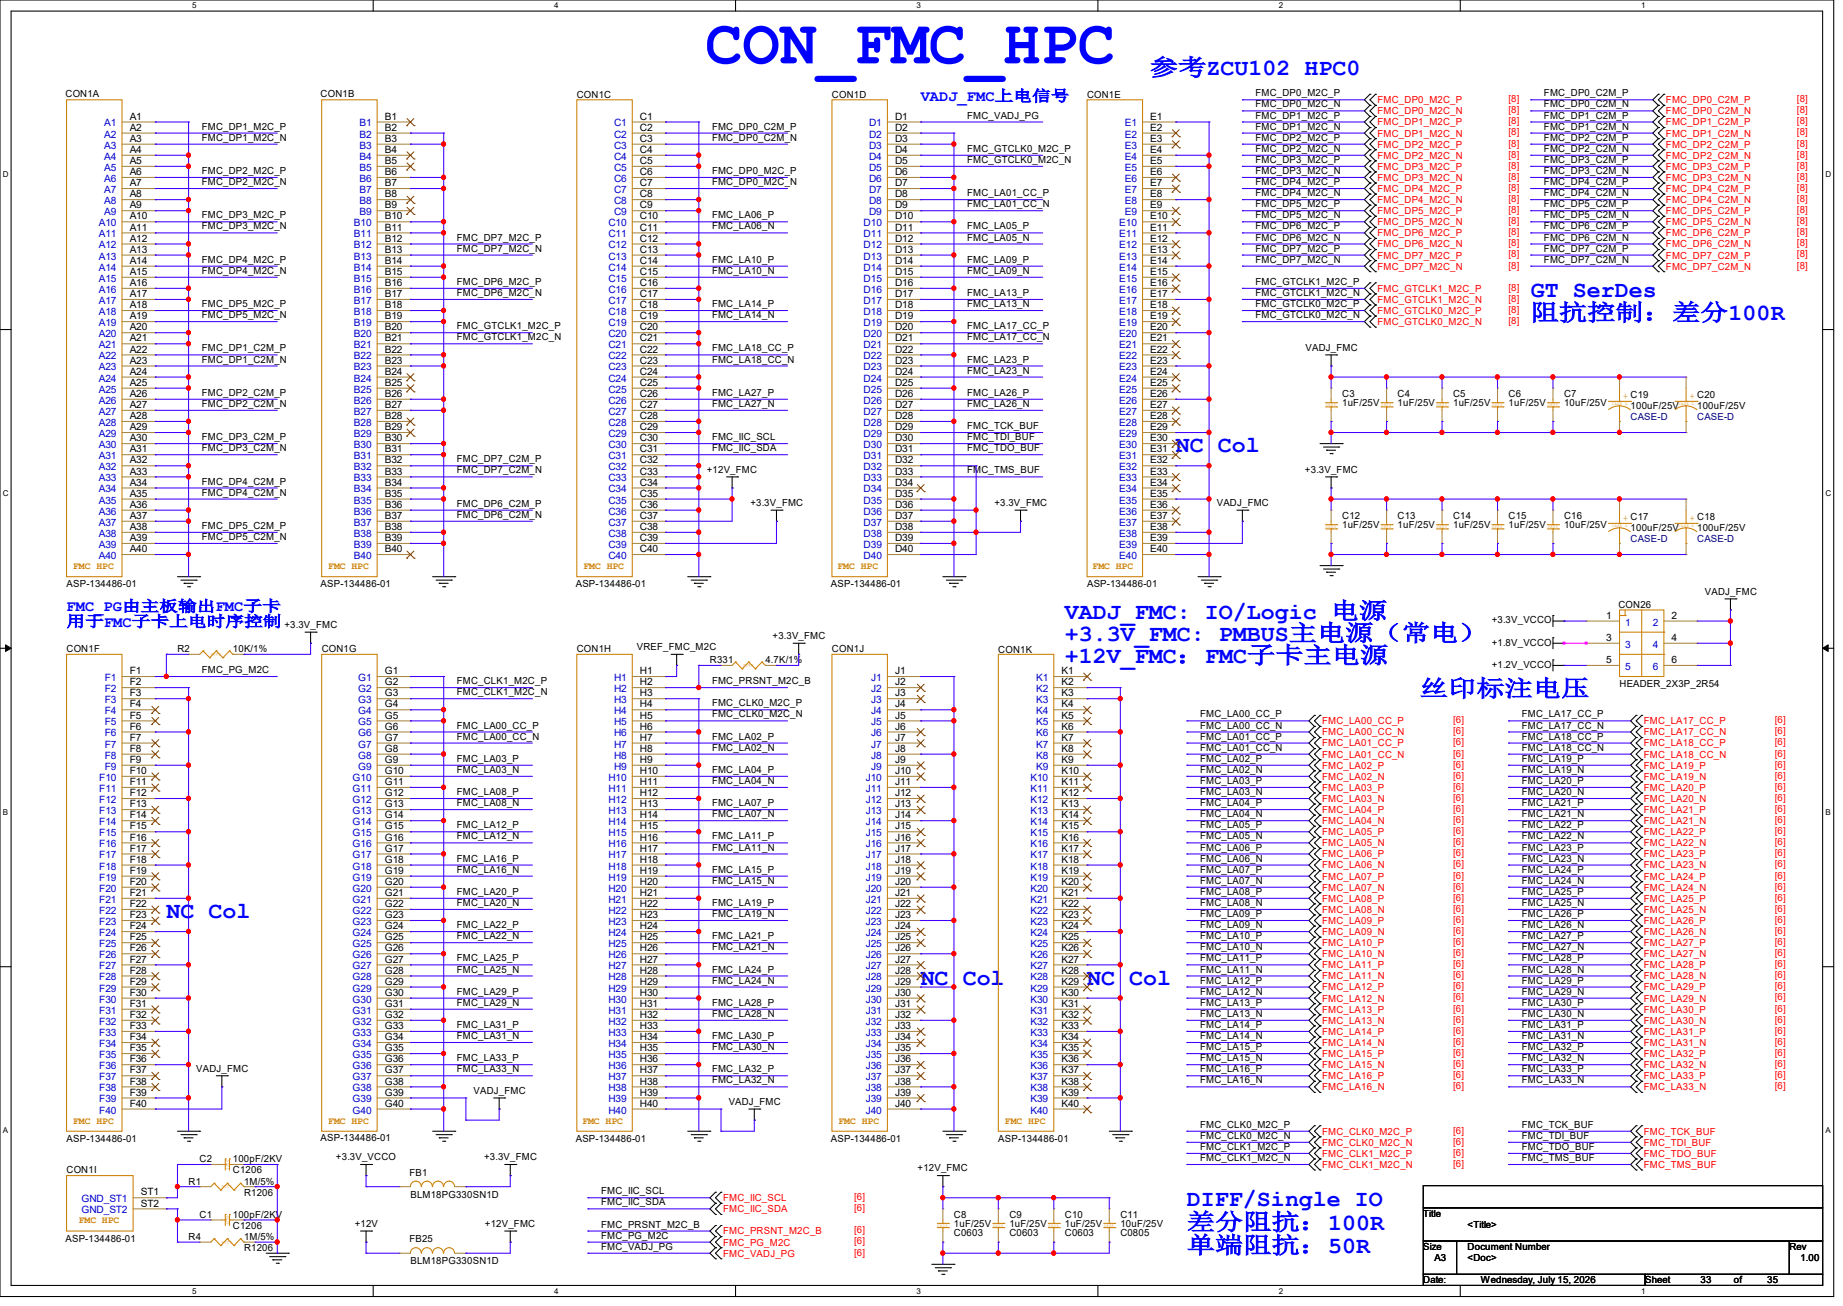
[picture p34: page 33]

# CON_HEADER&RS485&RS422&RS232

# ESD Array For Bank88 +3.3V_VCCO ESD Array For Bank89 VADJ_VCCO

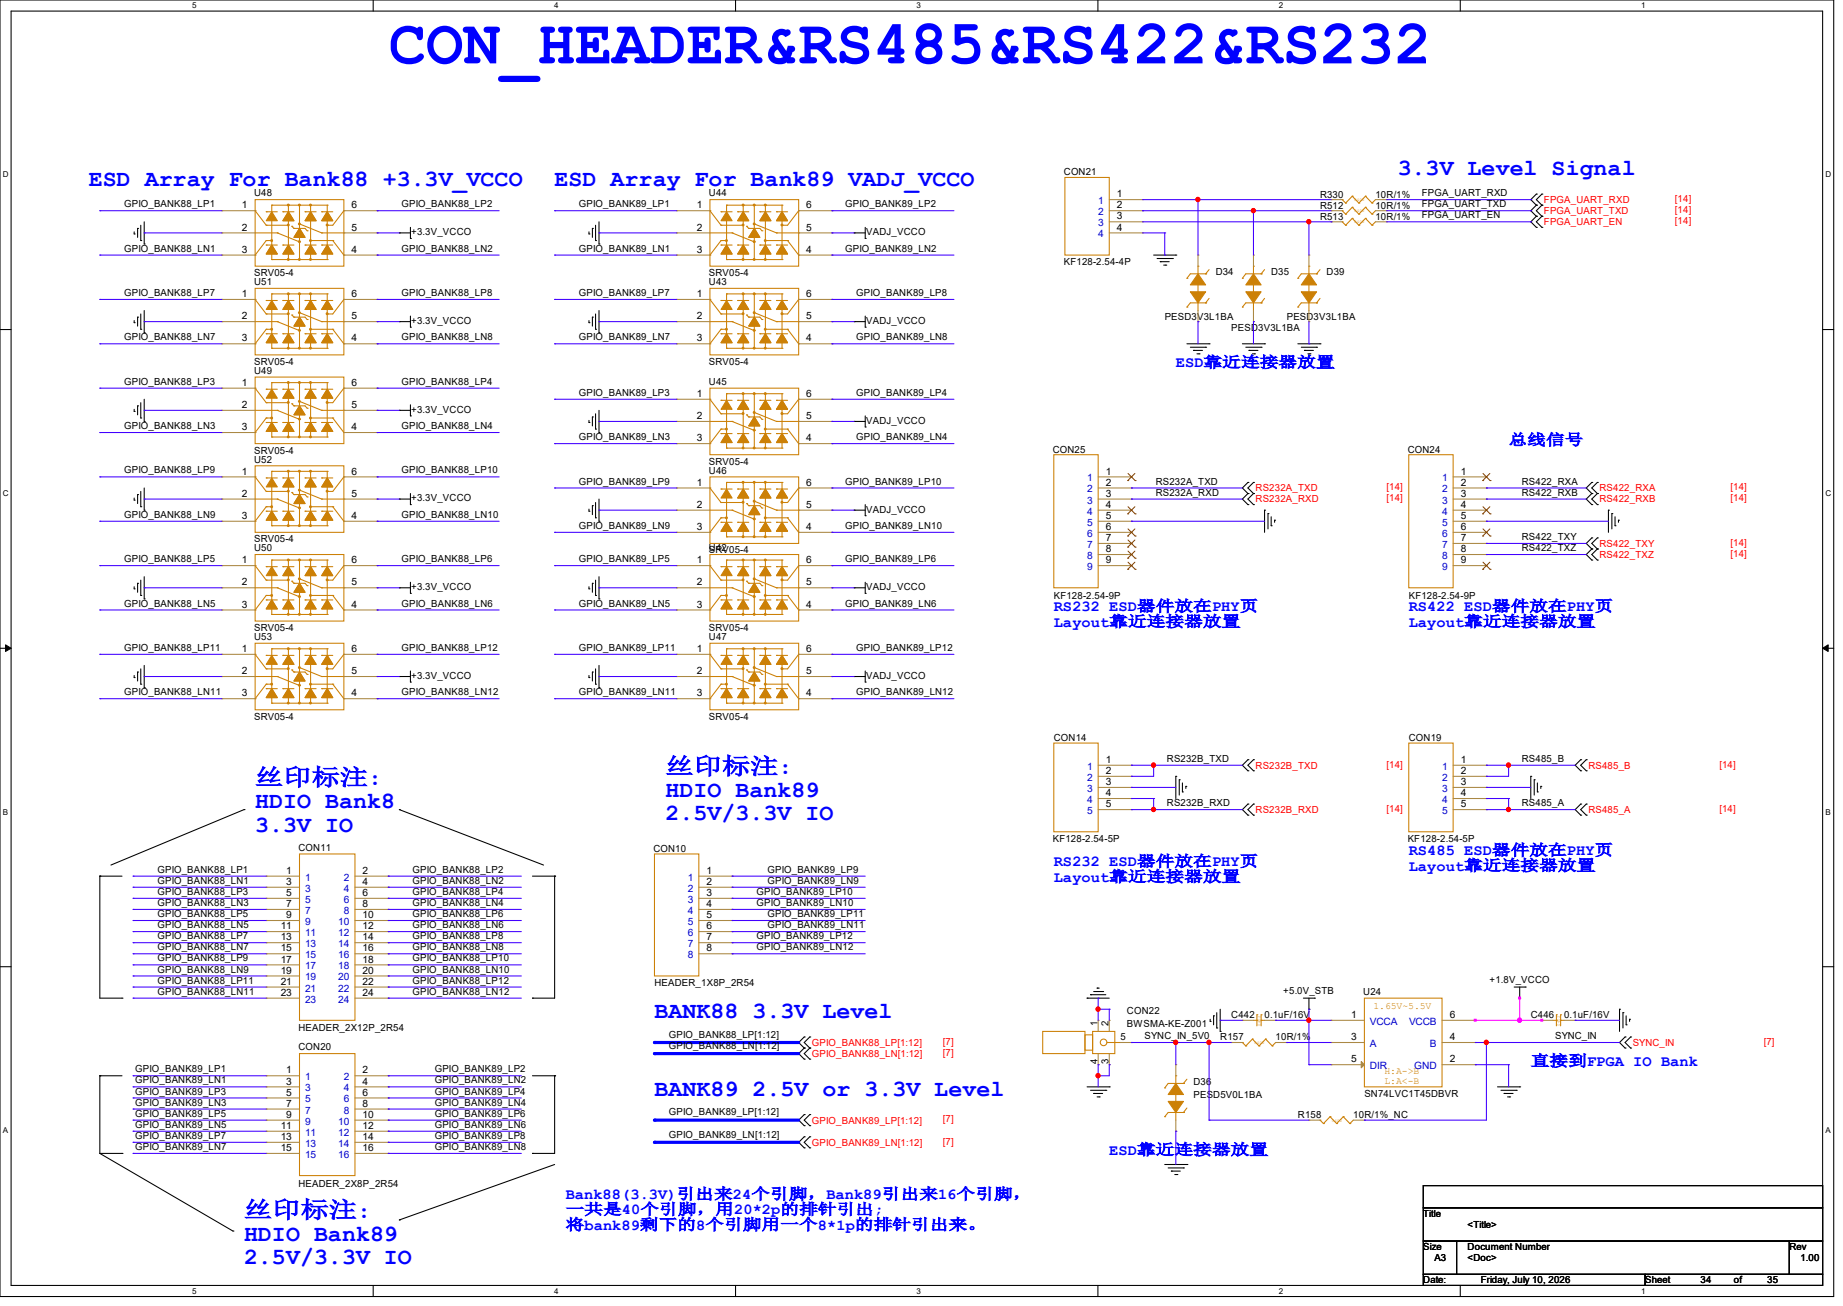
[picture p35: page 34]

CON_PCIE_GOLDEN_FINGER +12V_PCIEIN | +12V_PCIEIN

PRSNT#1 A1 +12V A2 +12V A3 GND A4 TCK A5 TDI A6 TDO A7 TMS A8 +3.3V A9 +3.3V A10 PERST A11 GND A12 REFCLK+ A13 REFCLK- A14 GND A15 PERp0 A16 PERn0 A17 GND A18 RSV1 A19 GND A20 PERp1 A21 PERn1 A22 GND A23 GND A24 PERp2 A25 PERn2 A26 GND A27 GND A28 PERp3 A29 PERn3 A30 GND A31 RSV2 A32 RSV3 A33 GND A34 PERp4 A35 PERn4 A36 GND A37 GND A38 PERp5 A39 PERn5 A40 GND A41 GND A42 PERp6 A43 PERn6 A44 GND A45 GND A46 PERp7 A47 PERn7 A48 GND A49

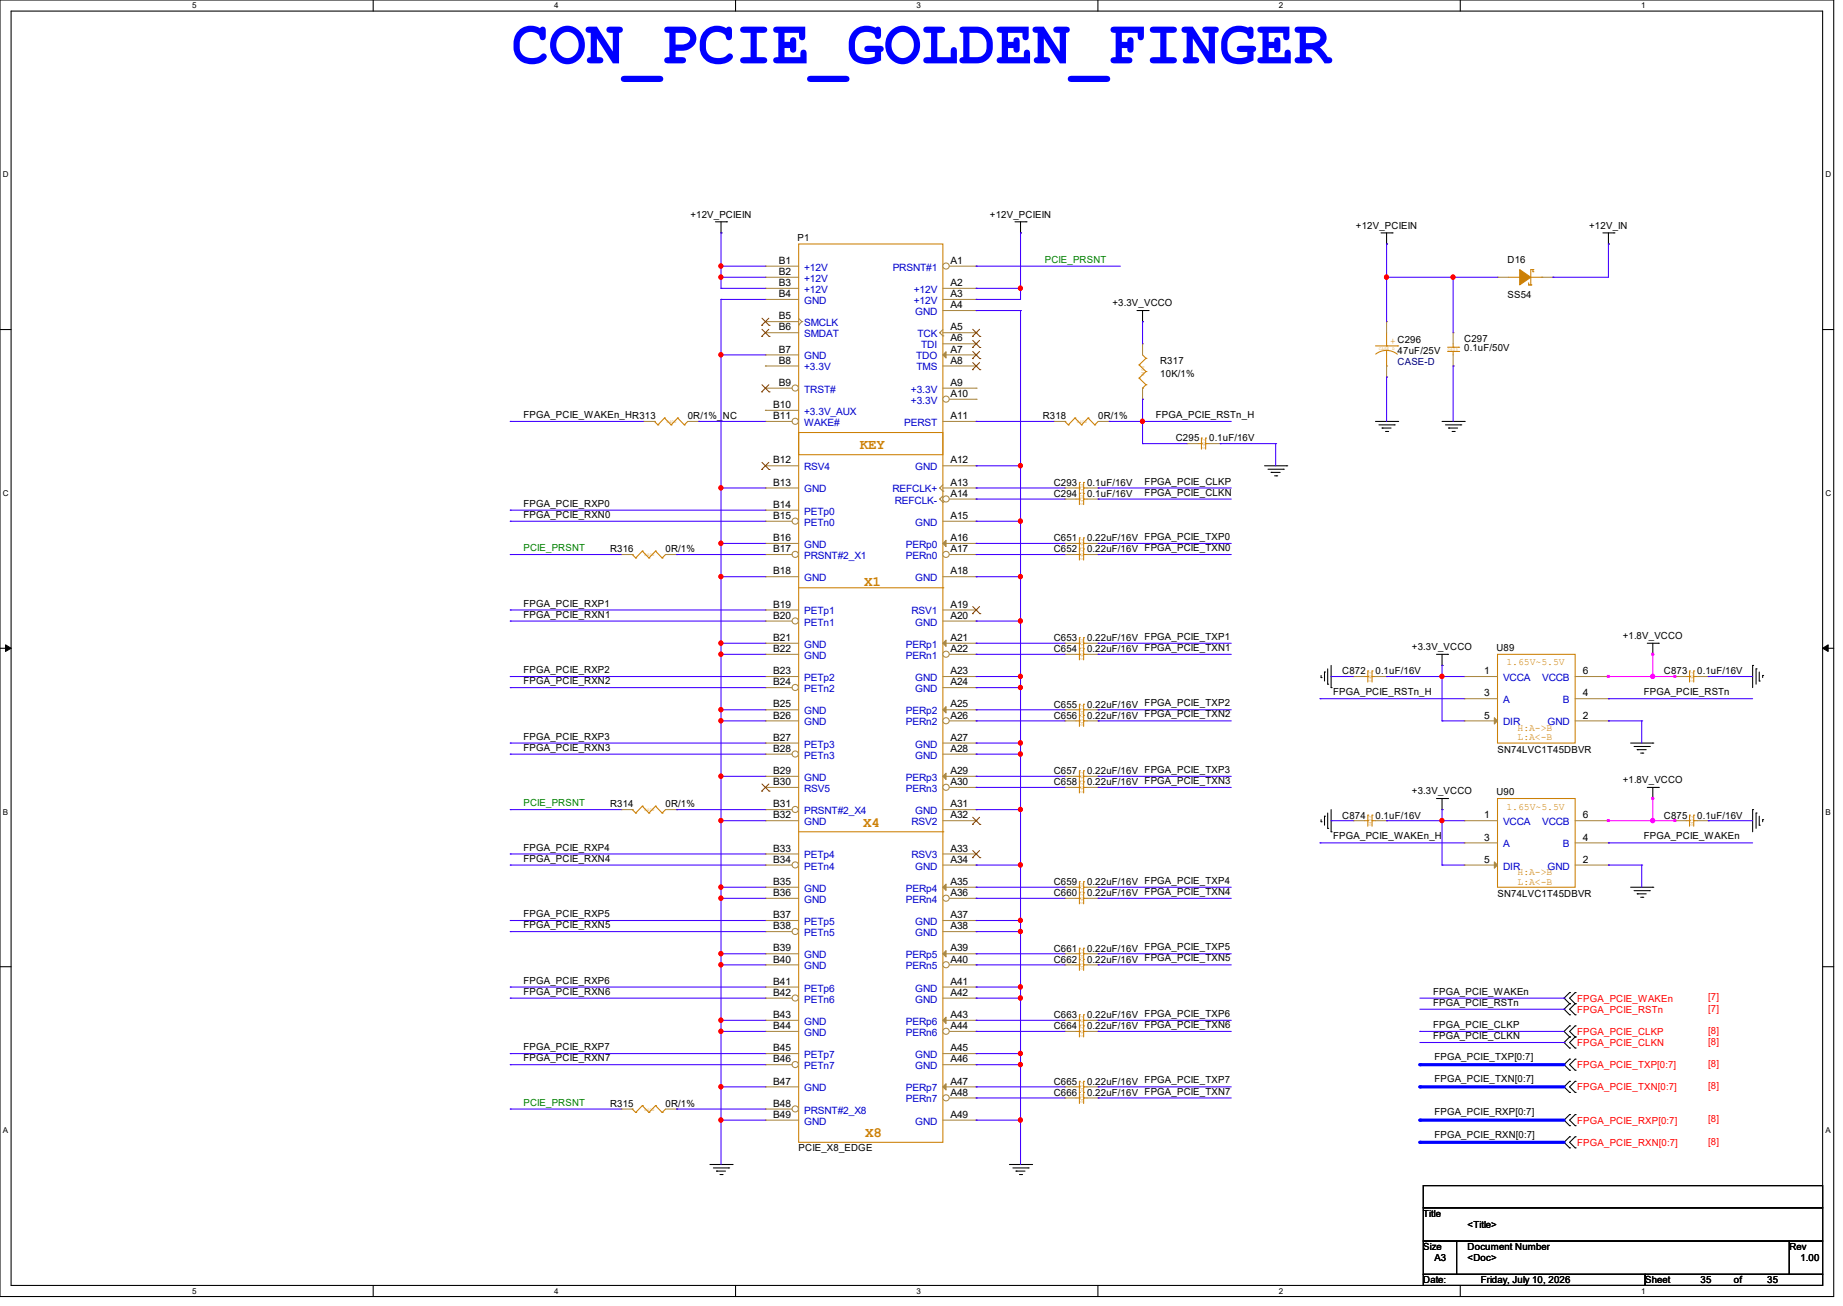
[picture p36: page 35]

+12V B1 +12V B2 +12V B3 GND B4 SMCLK B5 SMDAT B6 GND B7 +3.3V B8 TRST# B9 +3.3V_AUX B10 WAKE# B11 RSV4 B12 GND B13 PETp0 B14 PETn0 B15 GND B16 PRSNT#2_X1 B17 GND B18 PETp1 B19 PETn1 B20 GND B21 GND B22 PETp2 B23 PETn2 B24 GND B25 GND B26 PETp3 B27 PETn3 B28 GND B29 RSV5 B30 PRSNT#2_X4 B31 GND B32 PETp4 B33 PETn4 B34 GND B35 GND B36 PETp5 B37 PETn5 B38 GND B39 GND B40 PETp6 B41 PETn6 B42 GND B43 GND B44 PETp7 B45 PETn7 B46 GND B47 PRSNT#2_X8 B48 GND B49
