JiachengDong2026/Vapor_Radar_App_V2/Docs/【资料】FPGA设备接入手册/7-1-电机20K-2M-31.8-C.pdf

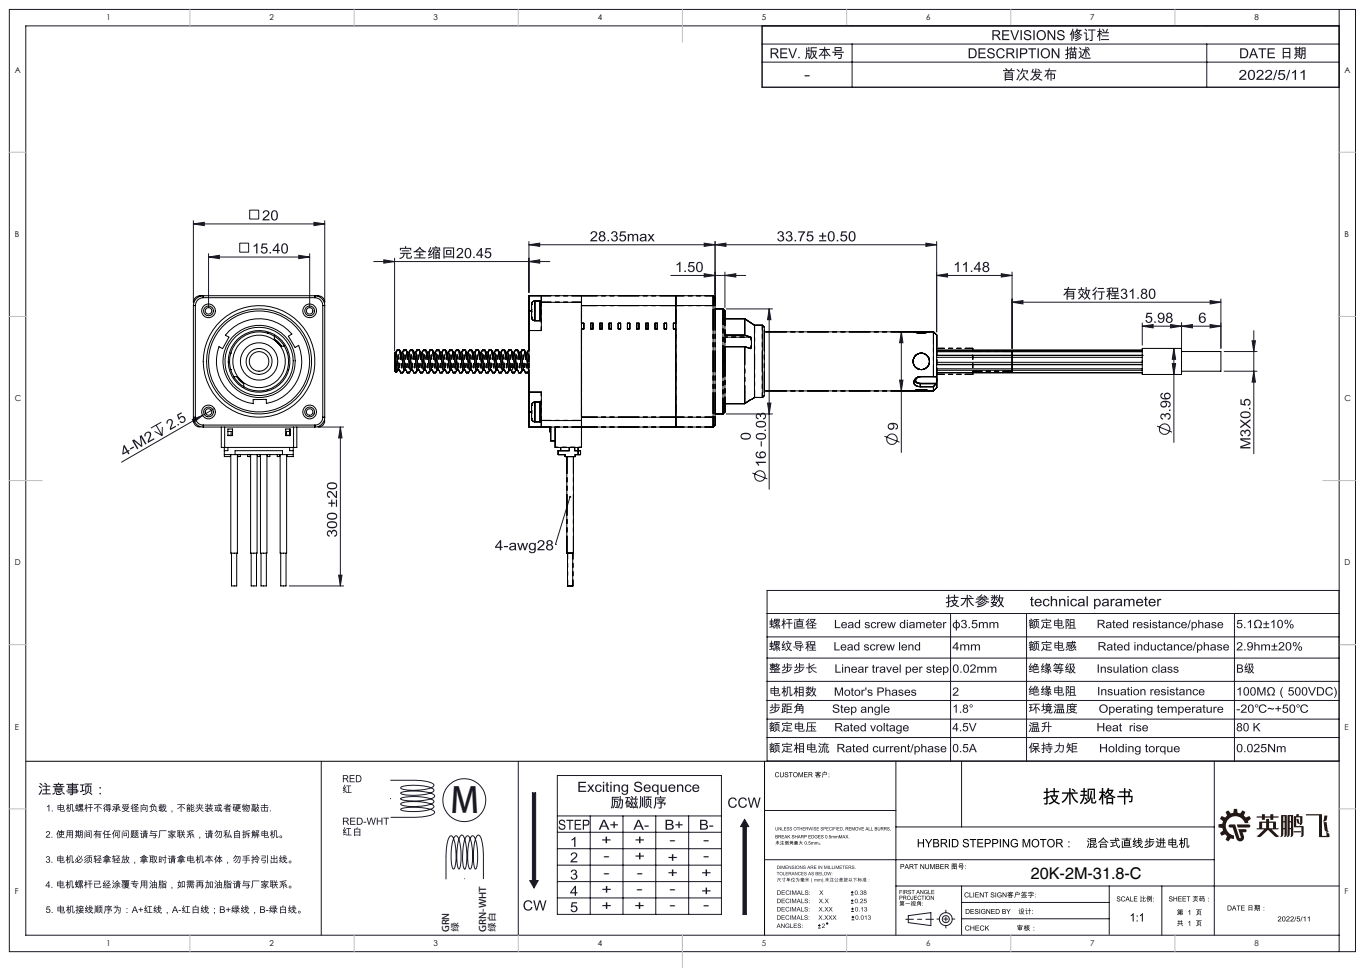
[picture p37: page 1]
GRN 绿; GRN-WHT
