JiachengDong2026/Vapor_Radar_App_V2/fpga/constraints/system/board_pins.xdc

# Generated from the complete original UCF, including both DAC channels.
# Schematic: Bank88 GPIO is 3.3 V; remaining used CMOS banks are 1.8 V. ADC clock output uses LVDS.
set_property -dict {PACKAGE_PIN AK17 IOSTANDARD LVCMOS18} [get_ports {CLK_FPGA_25MHZ}]
set_property -dict {PACKAGE_PIN C13 IOSTANDARD LVCMOS18} [get_ports {FPGA_GPIF_DQ[0]}]
set_property -dict {PACKAGE_PIN F13 IOSTANDARD LVCMOS18} [get_ports {FPGA_GPIF_DQ[1]}]
set_property -dict {PACKAGE_PIN B10 IOSTANDARD LVCMOS18} [get_ports {FPGA_GPIF_DQ[2]}]
set_property -dict {PACKAGE_PIN E13 IOSTANDARD LVCMOS18} [get_ports {FPGA_GPIF_DQ[3]}]
set_property -dict {PACKAGE_PIN C9 IOSTANDARD LVCMOS18} [get_ports {FPGA_GPIF_DQ[4]}]
set_property -dict {PACKAGE_PIN E11 IOSTANDARD LVCMOS18} [get_ports {FPGA_GPIF_DQ[5]}]
set_property -dict {PACKAGE_PIN C12 IOSTANDARD LVCMOS18} [get_ports {FPGA_GPIF_DQ[6]}]
set_property -dict {PACKAGE_PIN H11 IOSTANDARD LVCMOS18} [get_ports {FPGA_GPIF_DQ[7]}]
set_property -dict {PACKAGE_PIN J13 IOSTANDARD LVCMOS18} [get_ports {FPGA_GPIF_DQ[8]}]
set_property -dict {PACKAGE_PIN H13 IOSTANDARD LVCMOS18} [get_ports {FPGA_GPIF_DQ[9]}]
set_property -dict {PACKAGE_PIN H12 IOSTANDARD LVCMOS18} [get_ports {FPGA_GPIF_DQ[10]}]
set_property -dict {PACKAGE_PIN D13 IOSTANDARD LVCMOS18} [get_ports {FPGA_GPIF_DQ[11]}]
set_property -dict {PACKAGE_PIN G12 IOSTANDARD LVCMOS18} [get_ports {FPGA_GPIF_DQ[12]}]
set_property -dict {PACKAGE_PIN L8 IOSTANDARD LVCMOS18} [get_ports {FPGA_GPIF_DQ[13]}]
set_property -dict {PACKAGE_PIN J11 IOSTANDARD LVCMOS18} [get_ports {FPGA_GPIF_DQ[14]}]
set_property -dict {PACKAGE_PIN F12 IOSTANDARD LVCMOS18} [get_ports {FPGA_GPIF_DQ[15]}]
set_property -dict {PACKAGE_PIN K8 IOSTANDARD LVCMOS18} [get_ports {FPGA_GPIF_DQ[16]}]
set_property -dict {PACKAGE_PIN E8 IOSTANDARD LVCMOS18} [get_ports {FPGA_GPIF_DQ[17]}]
set_property -dict {PACKAGE_PIN D9 IOSTANDARD LVCMOS18} [get_ports {FPGA_GPIF_DQ[18]}]
set_property -dict {PACKAGE_PIN C8 IOSTANDARD LVCMOS18} [get_ports {FPGA_GPIF_DQ[19]}]
set_property -dict {PACKAGE_PIN A12 IOSTANDARD LVCMOS18} [get_ports {FPGA_GPIF_DQ[20]}]
set_property -dict {PACKAGE_PIN D8 IOSTANDARD LVCMOS18} [get_ports {FPGA_GPIF_DQ[21]}]
set_property -dict {PACKAGE_PIN B9 IOSTANDARD LVCMOS18} [get_ports {FPGA_GPIF_DQ[22]}]
set_property -dict {PACKAGE_PIN B12 IOSTANDARD LVCMOS18} [get_ports {FPGA_GPIF_DQ[23]}]
set_property -dict {PACKAGE_PIN D11 IOSTANDARD LVCMOS18} [get_ports {FPGA_GPIF_DQ[24]}]
set_property -dict {PACKAGE_PIN A9 IOSTANDARD LVCMOS18} [get_ports {FPGA_GPIF_DQ[25]}]
set_property -dict {PACKAGE_PIN A10 IOSTANDARD LVCMOS18} [get_ports {FPGA_GPIF_DQ[26]}]
set_property -dict {PACKAGE_PIN B11 IOSTANDARD LVCMOS18} [get_ports {FPGA_GPIF_DQ[27]}]
set_property -dict {PACKAGE_PIN E10 IOSTANDARD LVCMOS18} [get_ports {FPGA_GPIF_DQ[28]}]
set_property -dict {PACKAGE_PIN A13 IOSTANDARD LVCMOS18} [get_ports {FPGA_GPIF_DQ[29]}]
set_property -dict {PACKAGE_PIN D10 IOSTANDARD LVCMOS18} [get_ports {FPGA_GPIF_DQ[30]}]
set_property -dict {PACKAGE_PIN C11 IOSTANDARD LVCMOS18} [get_ports {FPGA_GPIF_DQ[31]}]
set_property -dict {PACKAGE_PIN L13 IOSTANDARD LVCMOS18} [get_ports {FPGA_GPIF_CTL[0]}]
set_property -dict {PACKAGE_PIN K12 IOSTANDARD LVCMOS18} [get_ports {FPGA_GPIF_CTL[1]}]
set_property -dict {PACKAGE_PIN K11 IOSTANDARD LVCMOS18} [get_ports {FPGA_GPIF_CTL[2]}]
set_property -dict {PACKAGE_PIN J10 IOSTANDARD LVCMOS18} [get_ports {FPGA_GPIF_CTL[3]}]
set_property -dict {PACKAGE_PIN F9 IOSTANDARD LVCMOS18} [get_ports {FPGA_GPIF_CTL[4]}]
set_property -dict {PACKAGE_PIN H8 IOSTANDARD LVCMOS18} [get_ports {FPGA_GPIF_CTL[5]}]
set_property -dict {PACKAGE_PIN J8 IOSTANDARD LVCMOS18} [get_ports {FPGA_GPIF_CTL[6]}]
set_property -dict {PACKAGE_PIN K13 IOSTANDARD LVCMOS18} [get_ports {FPGA_GPIF_CTL[7]}]
set_property -dict {PACKAGE_PIN F8 IOSTANDARD LVCMOS18} [get_ports {FPGA_GPIF_CTL[8]}]
set_property -dict {PACKAGE_PIN G9 IOSTANDARD LVCMOS18} [get_ports {FPGA_GPIF_CTL[9]}]
set_property -dict {PACKAGE_PIN K10 IOSTANDARD LVCMOS18} [get_ports {FPGA_GPIF_CTL[10]}]
set_property -dict {PACKAGE_PIN J9 IOSTANDARD LVCMOS18} [get_ports {FPGA_GPIF_CTL[11]}]
set_property -dict {PACKAGE_PIN H9 IOSTANDARD LVCMOS18} [get_ports {FPGA_GPIF_CTL[12]}]
set_property -dict {PACKAGE_PIN L12 IOSTANDARD LVCMOS18} [get_ports {FPGA_GPIF_INTN}]
set_property -dict {PACKAGE_PIN G10 IOSTANDARD LVCMOS18} [get_ports {FPGA_GPIF_PCLK}]
set_property -dict {PACKAGE_PIN G11 IOSTANDARD LVCMOS18} [get_ports {CYUSB_RSTN}]
set_property -dict {PACKAGE_PIN AL14 IOSTANDARD LVCMOS18} [get_ports {FPGA_RS232A_RXD}]
set_property -dict {PACKAGE_PIN AP19 IOSTANDARD LVCMOS18} [get_ports {FPGA_RS232B_RXD}]
set_property -dict {PACKAGE_PIN AM17 IOSTANDARD LVCMOS18} [get_ports {FPGA_RS485_RXD_L}]
set_property -dict {PACKAGE_PIN AM15 IOSTANDARD LVCMOS18} [get_ports {FPGA_RS422_RXD_L}]
set_property -dict {PACKAGE_PIN AN14 IOSTANDARD LVCMOS18} [get_ports {FPGA_UART_RXD_L}]
set_property -dict {PACKAGE_PIN AP13 IOSTANDARD LVCMOS33} [get_ports {TFA_LF_RXD}]
set_property -dict {PACKAGE_PIN AM14 IOSTANDARD LVCMOS18} [get_ports {FPGA_RS232A_TXD}]
set_property -dict {PACKAGE_PIN AN16 IOSTANDARD LVCMOS18} [get_ports {FPGA_RS485_TXD_L}]
set_property -dict {PACKAGE_PIN AN19 IOSTANDARD LVCMOS18} [get_ports {FPGA_RS485_DERE_L}]
set_property -dict {PACKAGE_PIN AN18 IOSTANDARD LVCMOS18} [get_ports {FPGA_RS422_TXD_L}]
set_property -dict {PACKAGE_PIN AP14 IOSTANDARD LVCMOS18} [get_ports {FPGA_UART_TXD_L}]
set_property -dict {PACKAGE_PIN AK16 IOSTANDARD LVCMOS18} [get_ports {FPGA_UART_EN_L}]
set_property -dict {PACKAGE_PIN AP15 IOSTANDARD LVCMOS18} [get_ports {RS232_PHY_FORCEON}]
set_property -dict {PACKAGE_PIN AP16 IOSTANDARD LVCMOS18} [get_ports {FPGA_RS232B_TXD}]
set_property -dict {PACKAGE_PIN AP18 IOSTANDARD LVCMOS18} [get_ports {SYNC_IN}]
set_property -dict {PACKAGE_PIN AN13 IOSTANDARD LVCMOS33} [get_ports {BMP390_INT}]
set_property -dict {PACKAGE_PIN AH13 IOSTANDARD LVCMOS33} [get_ports {I2C_SCL}]
set_property -dict {PACKAGE_PIN AJ13 IOSTANDARD LVCMOS33} [get_ports {I2C_SDA}]
set_property -dict {PACKAGE_PIN AM11 IOSTANDARD LVCMOS33} [get_ports {MOTOR_PUL}]
set_property -dict {PACKAGE_PIN AN11 IOSTANDARD LVCMOS33} [get_ports {MOTOR_DIR}]
set_property -dict {PACKAGE_PIN AK12 IOSTANDARD LVCMOS33} [get_ports {MOTOR_ENA}]
set_property -dict {PACKAGE_PIN K21 IOSTANDARD LVCMOS18} [get_ports {dac_sclk[0]}]
set_property -dict {PACKAGE_PIN R22 IOSTANDARD LVCMOS18} [get_ports {dac_sclk[1]}]
set_property -dict {PACKAGE_PIN K25 IOSTANDARD LVCMOS18} [get_ports {dac_sync_n[0]}]
set_property -dict {PACKAGE_PIN J26 IOSTANDARD LVCMOS18} [get_ports {dac_sync_n[1]}]
set_property -dict {PACKAGE_PIN L24 IOSTANDARD LVCMOS18} [get_ports {dac_sdin[0]}]
set_property -dict {PACKAGE_PIN G27 IOSTANDARD LVCMOS18} [get_ports {dac_sdin[1]}]
set_property -dict {PACKAGE_PIN M21 IOSTANDARD LVCMOS18} [get_ports {dac_rst_n[0]}]
set_property -dict {PACKAGE_PIN G26 IOSTANDARD LVCMOS18} [get_ports {dac_rst_n[1]}]
set_property -dict {PACKAGE_PIN H24 IOSTANDARD LVCMOS18} [get_ports {dac_clr_n[0]}]
set_property -dict {PACKAGE_PIN J24 IOSTANDARD LVCMOS18} [get_ports {dac_clr_n[1]}]
set_property -dict {PACKAGE_PIN H27 IOSTANDARD LVCMOS18} [get_ports {dac_ldac_n[0]}]
set_property -dict {PACKAGE_PIN H23 IOSTANDARD LVCMOS18} [get_ports {dac_ldac_n[1]}]
set_property -dict {PACKAGE_PIN L27 IOSTANDARD LVCMOS18} [get_ports {dac_sdo[0]}]
set_property -dict {PACKAGE_PIN H26 IOSTANDARD LVCMOS18} [get_ports {dac_sdo[1]}]
set_property -dict {PACKAGE_PIN K20 IOSTANDARD LVCMOS18} [get_ports {ADC_AD4630_SDI}]
set_property -dict {PACKAGE_PIN R21 IOSTANDARD LVCMOS18} [get_ports {ADC_AD4630_RSTN}]
set_property -dict {PACKAGE_PIN P21 IOSTANDARD LVCMOS18} [get_ports {ADC_AD4630_CNV}]
set_property -dict {PACKAGE_PIN L22 IOSTANDARD LVCMOS18} [get_ports {ADC_AD4630_CSN}]
set_property -dict {PACKAGE_PIN N23 IOSTANDARD LVCMOS18} [get_ports {ADC_AD4630_SCK}]
set_property -dict {PACKAGE_PIN P20 IOSTANDARD LVCMOS18} [get_ports {ADC_AD4630_BUSY}]
set_property -dict {PACKAGE_PIN R25 IOSTANDARD LVCMOS18} [get_ports {ADC_AD4630_SDO[0]}]
set_property -dict {PACKAGE_PIN R26 IOSTANDARD LVCMOS18} [get_ports {ADC_AD4630_SDO[1]}]
set_property -dict {PACKAGE_PIN T24 IOSTANDARD LVCMOS18} [get_ports {ADC_AD4630_SDO[2]}]
set_property -dict {PACKAGE_PIN R23 IOSTANDARD LVCMOS18} [get_ports {ADC_AD4630_SDO[3]}]
set_property -dict {PACKAGE_PIN N21 IOSTANDARD LVCMOS18} [get_ports {ADC_AD4630_SDO[4]}]
set_property -dict {PACKAGE_PIN L20 IOSTANDARD LVCMOS18} [get_ports {ADC_AD4630_SDO[5]}]
set_property -dict {PACKAGE_PIN M20 IOSTANDARD LVCMOS18} [get_ports {ADC_AD4630_SDO[6]}]
set_property -dict {PACKAGE_PIN K22 IOSTANDARD LVCMOS18} [get_ports {ADC_AD4630_SDO[7]}]
set_property -dict {PACKAGE_PIN P23 IOSTANDARD LVCMOS18} [get_ports {ADC_ADC3660_DA5}]
set_property -dict {PACKAGE_PIN L23 IOSTANDARD LVCMOS18} [get_ports {ADC_ADC3660_DA6}]
set_property -dict {PACKAGE_PIN N22 IOSTANDARD LVCMOS18} [get_ports {ADC_ADC3660_DB5}]
set_property -dict {PACKAGE_PIN M22 IOSTANDARD LVCMOS18} [get_ports {ADC_ADC3660_DB6}]
set_property -dict {PACKAGE_PIN N24 IOSTANDARD LVCMOS18} [get_ports {ADC_ADC3660_DCLK}]
set_property -dict {PACKAGE_PIN M27 IOSTANDARD LVCMOS18} [get_ports {ADC_ADC3660_FCLK}]
set_property -dict {PACKAGE_PIN P26 IOSTANDARD LVCMOS18} [get_ports {ADC_ADC3660_DCLKIN}]
set_property -dict {PACKAGE_PIN M25 IOSTANDARD LVDS} [get_ports {ADC_ADC3660_CLKP}]
set_property -dict {PACKAGE_PIN M26 IOSTANDARD LVDS} [get_ports {ADC_ADC3660_CLKN}]
set_property -dict {PACKAGE_PIN K23 IOSTANDARD LVCMOS18} [get_ports {ADC_ADC3660_SEN}]
set_property -dict {PACKAGE_PIN P24 IOSTANDARD LVCMOS18} [get_ports {ADC_ADC3660_SCLK}]
set_property -dict {PACKAGE_PIN J25 IOSTANDARD LVCMOS18} [get_ports {ADC_ADC3660_RST}]
set_property -dict {PACKAGE_PIN G25 IOSTANDARD LVCMOS18} [get_ports {ADC_ADC3660_SYNC}]
set_property -dict {PACKAGE_PIN J23 IOSTANDARD LVCMOS18} [get_ports {ADC_ADC3660_SDIO}]
