JiachengDong2026/Vapor_Radar_App_V2/(commit log)

2026-09-14 Remove legacy application implementation
    [项目开发需求表单—国科大杭高院260420.xlsx]
2026-09-14 Sync current project state
2026-09-23 Integrate validated sensors and USB system
2026-10-06 Sync validated dual ADC and precision DLIA integration
    Integrate dual AD4630 channels, interpolated DLIA references and fourth-order 1 kHz filtering. Archive reproducible precision checks, reviewed CDC baseline, Flash export settings and interface documentation.
    Validation: baseline static check, common Vivado simulation/synthesis and 13 targeted regressions passed. Production logic matches the October 2 board-tested source; Flash BIN/MCS match the deployed image. Hardware evidence covers the first laser channel and October 3 cold boot; no new hardware run for this commit.
2026-10-16 Add VLP1 device control and scanning extensions
